bsaid/SensorBoard/firmware/hello_world_orig/README.md

# Hello World Test

Testing space for new software features in SensorBoard.
