bsaid/SensorBoard/firmware/SensorBoard_orig/README.md

# SensorBoard main firmware

* The main firmware source code for ESP32 in SensorBoard.
