bsaid/SensorBoard/thesisCloneUIB/Acronyms.tex

%!TeX root=indexUIB.tex
\chapter{Acronyms}

\begin{acronym}

\acro{AHRS}[AHRS]{Attitude and Heading Reference System}
\acro{API}[API]{Application Programming Interface}
\acro{ARM}[ARM]{Advanced RISC Machine}
\acro{BOM}[BOM]{Bill of Materials}
\acro{CGI}[CGI]{Computer Generated Imagery}
\acro{CPU}[CPU]{Central Processing Unit}
\acro{CSV}[CSV]{Comma-Separated Values}
\acro{DSP}[DSP]{Digital Signal Processing}
\acro{EAGLE}[EAGLE]{Easy Applicable Graphical Layout Editor}
\acro{ESP-IDF}[ESP-IDF]{Espressif IoT Development Framework}
\acro{GPIO}[GPIO]{General-Purpose Input/Output}
\acro{HAL}[HAL]{Hardware Abstraction Layer}
\acro{IMU}[IMU]{Inertial Measurement Unit}
\acro{IoT}[IoT]{Internet of Things}
\acro{JTAG}[JTAG]{Joint Test Action Group}
\acro{LED}[LED]{Light-Emitting Diode}
\acro{Li-poly}[Li-poly]{Lithium polymer battery}
\acro{MEMS}[MEMS]{Micro Electro Mechanical Systems}
\acro{Mo-Cap}[Mo-Cap]{Motion Capture}
\acro{PCB}[PCB]{Printed Circuit Board}
\acro{POSIX}[POSIX]{Portable Operating System Interface}
\acro{RLC}[RLC]{Resistor (R), Inductor (L), Capacitor (C)}
\acro{SMD}[SMD]{Surface Mounted Device}
\acro{SMT}[SMT]{Surface Mount Technology}
\acro{SPI}[SPI]{Serial Peripheral Interface bus}
\acro{SWD}[SWD]{Serial Wire Debug}
\acro{TCP}[TCP]{Transmission Control Protocol}
\acro{TDOA}[TDOA]{Time Difference of Arrival}
\acro{UART}[UART]{Universal Asynchronous Receiver-Transmitter}
\acro{USB}[USB]{Universal Serial Bus}

\end{acronym}
