bsaid/SensorBoard/thesisCloneUIB/indexUIB.tex

\documentclass[english, GINF]{TFGEPSUIB}

\usepackage[printonlyused]{acronym}
\usepackage{siunitx}
\usepackage[draft=false, backref, hyperindex, plainpages=false, breaklinks=true, bookmarksnumbered=true]{hyperref}

\usepackage{paralist} %% Compact list environments
\usepackage{amsmath}  %% Mathematics
\usepackage{amsthm}
\usepackage{amsfonts}
\usepackage{url}      %% Hyperlinks
\usepackage{listings} %% Source code highlighting
\usepackage{graphicx}
\usepackage{listings}
\usepackage{xcolor}
\usepackage{hhline}
\usepackage{siunitx}
\usepackage[most]{tcolorbox}
\usepackage{geometry}
\usepackage{adjustbox}
\usepackage{tcolorbox}
\usepackage{multirow, tabularx}
\usepackage{booktabs}
\usepackage{multirow}
\usepackage{longtable}
\usepackage{gensymb}
\usepackage{multicol}
\usepackage{float}

\estudis{\MakeUppercase{Master degree}}

% Thesis info
\title{Device for Movement Analysis Using Inertial Sensors}
\author{\MakeUppercase{Bedřich Said}}
\tutor{Dr. Antoni Jaume i Capó}
\supervisor{RNDr. Zdeněk Matěj, Ph.D.}
\date{May 22, 2018}

\bibliographystyle{url}

\theoremstyle{definition}
\newtheorem{definition}{Definition}[section]

\theoremstyle{remark}
\newtheorem*{remark}{Remark}

%% Special colors definitions
\definecolor{background}{HTML}{F5DD9D}
\definecolor{symbolColorTop}{HTML}{FFECB3}
\definecolor{symbolColorBox}{HTML}{FFF9E5}
\definecolor{gray}{rgb}{0.25,0.25,0.25}
\definecolor{darkblue}{rgb}{0.0,0.0,0.6}
\definecolor{cyan}{rgb}{0.0,0.6,0.6}
\definecolor{lightblue}{rgb}{0.9,0.95,1.0}
\definecolor{darkgreen}{rgb}{0.0,0.6,0.0}
\definecolor{brown}{HTML}{A52A2A}
\definecolor{darkmagenta}{HTML}{8B008B}

\lstset{
	basicstyle      = \ttfamily,%
	identifierstyle = \color{black},%
	keywordstyle    = \color{blue},%
	keywordstyle    = {[2]\color{cyan}},%
	keywordstyle    = {[3]\color{olive}},%
	stringstyle     = \color{teal},%
	commentstyle    = \itshape\color{magenta}}

\newcommand\Cpp{
	\lstset{
		basicstyle=\ttfamily,
		columns=fullflexible,
		showstringspaces=false,
		tabsize=4,
		numbers=left,
		xleftmargin=2em,
		backgroundcolor = \color{lightblue},
		language=C++,
		identifierstyle=\color{brown},
		keywordstyle=\color{blue},
		stringstyle=\color{red},
		commentstyle=\color{darkgreen},
		morecomment=[l][\color{darkmagenta}]{\#}
	}
}

%% Table colors
\newcommand\greenLow[0]{\cellcolor{green!25} Low}
\newcommand\greenSpare[0]{\cellcolor{green!25} Spare}
\newcommand\yellowMedium[0]{\cellcolor{yellow!25} Medium}
\newcommand\redHigh[0]{\cellcolor{red!25} High}

\newcommand\greenYes[0]{\cellcolor{green!25} Yes}
\newcommand\redNo[0]{\cellcolor{red!25} No}

\newcommand\greenCell[1]{\cellcolor{green!25} #1}
\newcommand\yellowCell[1]{\cellcolor{yellow!25} #1}
\newcommand\redCell[1]{\cellcolor{red!25} #1}

%% Definition of the box with declarations of used symbols.
\newcommand\highlightedBox[2]{
	\tcbset{
		enhanced,
		colback=symbolColorBox,
		boxrule=1.0pt,
		colframe=symbolColorTop!80!black,
		coltitle=black,
		fonttitle=\bfseries
	}
	\vspace{0.5cm}
	\begin{tcolorbox}[title=#1:,lifted shadow={0mm}{0mm}{0mm}{0.1mm}{black!50!white}]
		#2
	\end{tcolorbox}
	\vspace{0.5cm}
}

\newcommand\itwoc[0]{
	I$^{2}$C
}

\newcommand\ind[1]{#1\index{#1}}

\begin{document}
\tcbset{tab2/.style={enhanced,fonttitle=\bfseries,fontupper=\normalsize\sffamily, colback=yellow!10!white, colframe=black, colbacktitle=white, coltitle=black, center title}}

%\portada
\frontmatter

\cleartorecto \tableofcontents

\include{Acronyms}
\include{Abstract}

\newgeometry{twoside, top=2.5cm, left=3cm, textwidth=15cm, textheight=24cm}
\mainmatter\pagestyle{ruled}

\include{Introduction}
\include{Hardware}
\include{Software}
\include{Analysis}
\include{Conclusion}

\backmatter

\bibliographystyle{IEEEtran}

% Using file Bibliography.bib
\bibliography{bibliografia}

\appendix
\include{Appendix}

\end{document}
