bsaid/SensorBoard/thesis/Acronyms.tex

\newacronym{AHRS}{AHRS}{Attitude and Heading Reference System}
\newacronym{API}{API}{Application Programming Interface}
\newacronym{ARM}{ARM}{Advanced RISC Machine}
\newacronym{BOM}{BOM}{Bill of Materials}
\newacronym{CGI}{CGI}{Computer Generated Imagery}
\newacronym{CPU}{CPU}{Central Processing Unit}
\newacronym{CSV}{CSV}{Comma-Separated Values}
\newacronym{DSP}{DSP}{Digital Signal Processing}
\newacronym{EAGLE}{EAGLE}{Easy Applicable Graphical Layout Editor}
\newacronym{ESP-IDF}{ESP-IDF}{Espressif IoT Development Framework}
\newacronym{GPIO}{GPIO}{General-Purpose Input/Output}
\newacronym{HAL}{HAL}{Hardware Abstraction Layer}
\newacronym{IMU}{IMU}{Inertial Measurement Unit}
\newacronym{IoT}{IoT}{Internet of Things}
\newacronym{JTAG}{JTAG}{Joint Test Action Group}
\newacronym{LED}{LED}{Light-Emitting Diode}
\newacronym{Li-poly}{Li-poly}{Lithium polymer battery}
\newacronym{MEMS}{MEMS}{Micro Electro Mechanical Systems}
\newacronym{Mo-Cap}{Mo-Cap}{Motion Capture}
\newacronym{PCB}{PCB}{Printed Circuit Board}
\newacronym{POSIX}{POSIX}{Portable Operating System Interface}
\newacronym{RLC}{RLC}{Resistor (R), Inductor (L), Capacitor (C)}
\newacronym{SMD}{SMD}{Surface Mounted Device}
\newacronym{SMT}{SMT}{Surface Mount Technology}
\newacronym{SPI}{SPI}{Serial Peripheral Interface bus}
\newacronym{SWD}{SWD}{Serial Wire Debug}
\newacronym{TCP}{TCP}{Transmission Control Protocol}
\newacronym{TDOA}{TDOA}{Time Difference of Arrival}
\newacronym{UART}{UART}{Universal Asynchronous Receiver-Transmitter}
\newacronym{USB}{USB}{Universal Serial Bus}
