bsaid/SensorBoard/thesisCloneUIB/indexUIB.pdf

# Final Degree Report

## MASTER DEGREE

# Device for Movement Analysis Using Inertial Sensors

## BEDRICH SAID ˇ

## Tutor

RNDr. Zdenˇek Matˇej, Ph.D.

## Supervisor Dr. Antoni Jaume i Capó

## Escola Politècnica Superior Universitat de les Illes Balears Palma, May 01, 2018

## CONTENTS

Contents | i
Acronyms | iii
Abstract | v
1 Introduction | 1
2 Hardware | 3
3 Software | 25

i

ii | CONTENTS
3.3.2 | Sensor fusion and Attitude and Heading Reference System (AHRS) . . | 36
3.3.3 | UAV Flight controller with non-critical user programmable processor . | 38
3.4.5 | Controlling via Transmission Control Protocol (TCP) connection . . . | 48
4 Conclusion | 51
Bibliography | 53

## ACRONYMS

AHRS Attitude and Heading Reference System

API Application Programming Interface

BOM Bill of Materials

EAGLE Easy Applicable Graphical Layout Editor

ESP-IDF Espressif IoT Development Framework

IMU Inertial Measurement Unit

IoT Internet of Things

JTAG Joint Test Action Group (standard)

MEMS Micro Electro Mechanical Systems

PCB Printed Circuit Board

POSIX Portable Operating System Interface

SMD Surface Mounted Device

SMT Surface Mount Technology

SWD Serial Wire Debug (interface)

TCP Transmission Control Protocol

TDOA Time Difference of Arrival

iii

## ABSTRACT

Attitude sensors are more widely used and their price is decreasing. The lower price allows creating new solutions with lower costs. Some examples can be found in wearable devices, mobile phones, navigation or control systems. There are several devices for various use cases on the market.
These devices usually cover their use cases and don’t have any additional features like power independence, enough logging memory or openness for user code. The remaining hardware that fulfills all the conditions above is usually very expensive.
I have developed a new wearable independent device for capturing and processing the measured data. The independence means no external wires and no external power supply here. The device is able to work outdoors, to log the measured data and to provide a direct output based on internal computations. The user can choose between completely wireless communication or wired connection to other electronics. The sensors measure inertial, attitude, position and atmospheric values.
For outdoor testing of the device, I have selected a task about movement analysis of a horse. The devices were placed on the horse’s body as wearable devices and I was developing algorithms for determination of the type of its movement – stand, walk, trot or gallop.
In general, the developed device can be used for sensor data capturing, onboard data processing, navigation or control of moving mechanics. The device works independently, so it is easy to install on the measured or controlled objects.

v

## C H A P T E R

1

## INTRODUCTION

Attitude sensors are more widely used and their price is decreasing. The decreasing price allows creating new solutions with lower costs. Some examples can be found in wearable devices, mobile phones, navigation or control systems. There are several devices for various use cases on the market.
These devices usually cover their use cases and don’t have any additional versatility. For example, some wearable devices require permanent connection and don’t have enough memory to log the captured data for several minutes. Another hardware requires an external power supply and cannot work independently. Some next boards are closed and don’t allow to run a user code. The remaining hardware that fulfills all the conditions above is usually very expensive.
The goal of this work is to develop a new independent device with several sensors and a user programmable controller. So, why we don’t use a mobile phone? Well, the device should be able to run a real-time user program and to read the sensors at a precisely specified frequency. The size and weight of the device are also very important. With the decreasing price of Micro Electro Mechanical Systems (MEMS) sensors and controllers, we are able to build cheaper and lighter device than a smartphone.
I have utilized a new microcontroller in this work. This microcontroller was released on September 2016 and it’s designed for various real-time embedded tasks and it’s manufactured with on-chip WiFi and Bluetooth. I think that at least one wearable device should be designed with this microcontroller.
This paper goes through the development process of the new wearable hardware including manufacturing, testing, API implementation, firmware implementation and the first use of the prototype outside the laboratory. Each part is discussed in the separated chapter.
The main motivation was to create an independent wearable device with various sensors and enough memory for storing the measured data. The capacity of the battery and power

1

1. INTRODUCTION

consumption is also very important. During the design process, I have added some additional requirements that don’t increase the cost very much, but they give us higher versatility and possibility to use the new hardware in more solutions.
When I finished the development process of the hardware I had to prove the announced functionality of the device. I have selected a task about movement analysis of a horse using inertial sensors. When the device is mounted on a horse’s body, the real-time analysis is able to detect the type of movement of this horse. With this task, I can compare the functionality of my device to the other hardware available on the market. The movement analysis task is based on outdoor measurements, so I can see the usability of my hardware and software outside laboratory conditions. These successful tests are also part of this thesis.
When I was looking for a good algorithm for determination of the movement based on data from inertial sensors, I tried to write my own algorithm with low requirements on the CPU power. The algorithm runs real-time with latency around one step of the horse. Lower latency cannot be achieved because one step is the basic element of each movement. During the outdoor tests, we could see the horse with the SensorBoard mounted on its back and the real-time results of the analysis on the screen of a connected tablet.
The algorithm first determines very basic types of movements and then it’s looking for more advanced ones based on previous results. The types of movement are defined as state-ments, so new types of movement of any subject can be detected without modification of the computation code. These tests achieved the last milestone of this thesis.

2

## C H A P T E R

2

## HARDWARE

The hardware design is split into several steps in this paper. First, I had to decide if it’s really necessary to build a new device or if I can find a suitable solution on the market. When we want to select a suitable device for our task, we have to know the specification of the task itself. The task is specified in section 2.1. Based on the task we can specify all requirements that the selected device should meet (section 2.2). Now, we can start looking for a device that fulfills all the requirements (section 2.3).

When we don’t find any suitable device on the market, we can start to think about creating a new one. In my opinion, it’s not a good way to start any development before doing the previous steps.

When we already start a development of a new hardware we can think about adding some additional requirements for increasing the versatility of the final hardware. Of course, the new requirements mustn’t rapidly increase the final prize. But if the hardware will be used only in the specific task, it’s usually unnecessary to add any other functionality. In this case, I’m adding some additional requirements in section 2.2.3, because I think that in this case, I can add very high versatility with very low additional cost. The analysis of the final expenses is in section 2.7.4.

When I’m decided to develop a new hardware and I have the specification of all the requirements, I can start the development process. The selection of chips and other parts is in section 2.4 and the printed circuit board (Printed Circuit Board (PCB)) design is discussed in section 2.5.

Finally, the manufacturing of the first prototype is described in section 2.6. With the first prototype, it’s time for testing. The tests should find as many errors as possible and they should proof us if the requirements were already met. The section 2.7. The whole process is shown in the figure 2.

3

2. HARDWARE

Figure 2.1: Flowchart of the hardware design process

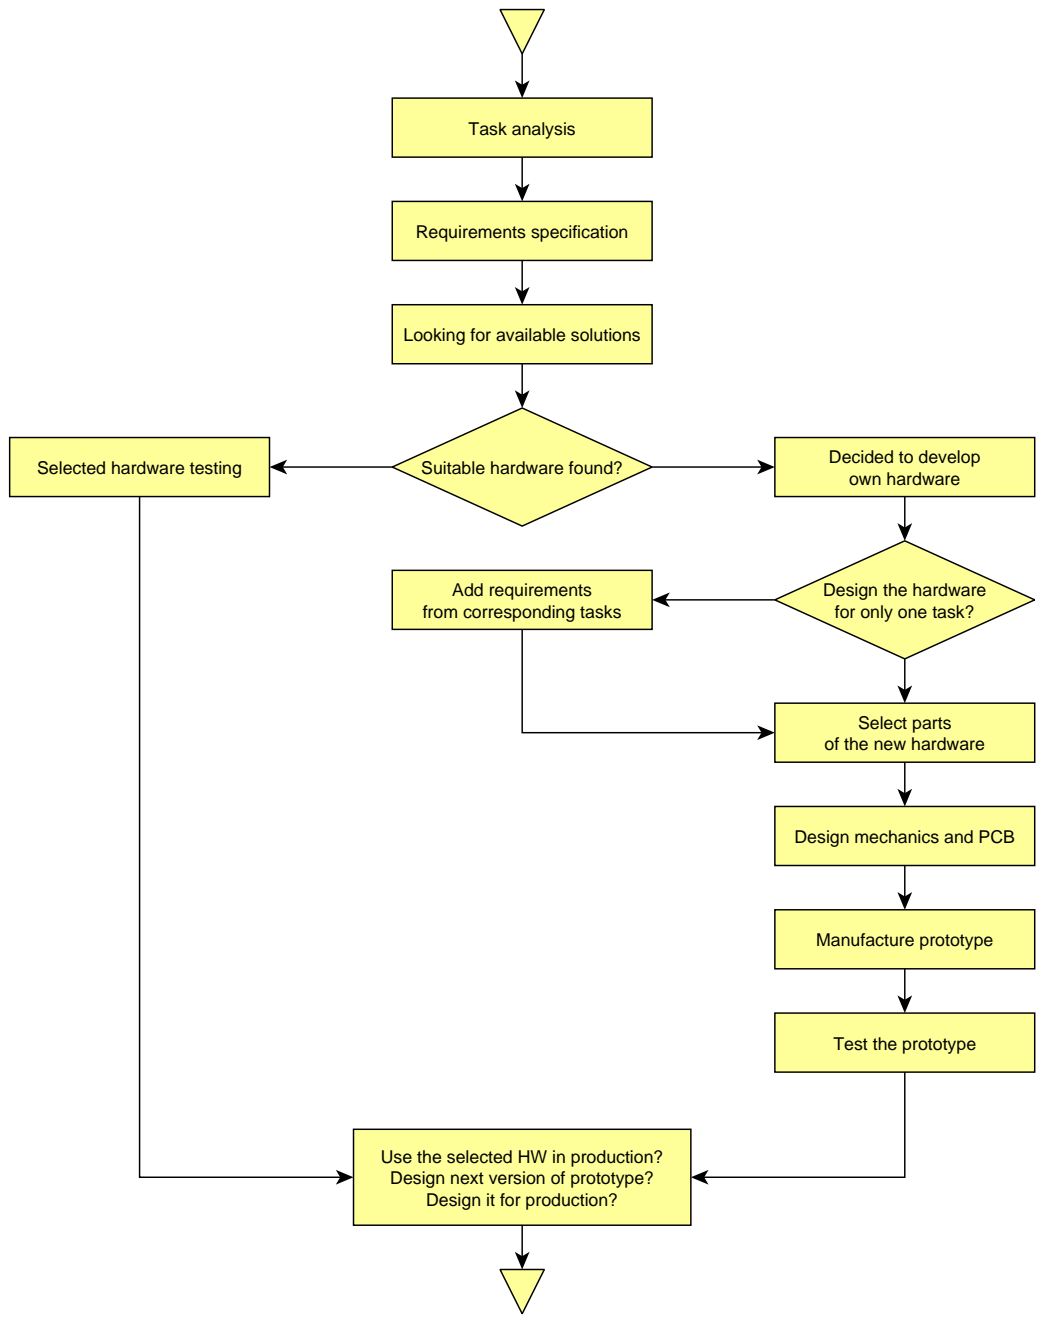
[picture p14: figure]
Task analysis; Requirements specification; Looking for available solutions; Selected hardware testing; Suitable hardware found?; Decided to develop; own hardware; Design the hardware for only one task?; Add requirements from corresponding tasks; Select parts of the new hardware; Design mechanics and PCB; Manufacture prototype; Test the prototype; Use the selected HW in production? Design next version of prototype? Design it for production?

4

2.1. Task Analysis

## 2.1 Task Analysis

When we define our complete task in the first step, then we can derive all requirements for our solution. Finally, we can check if our project was successful based on the previously defined task and requirements.

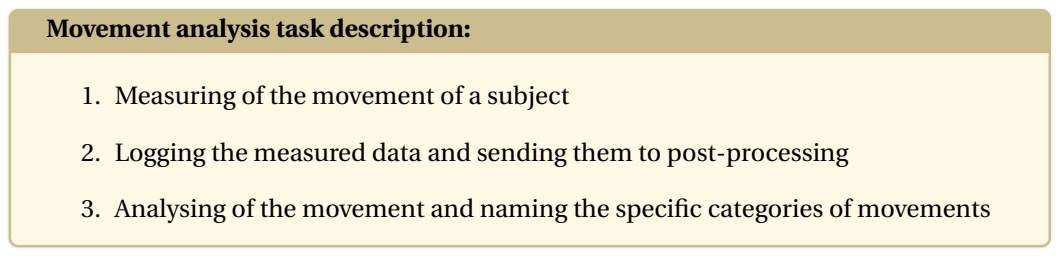
[picture p15: figure]
Movement analysis task description:

1. Measuring of the movement of a subject
2. Logging the measured data and sending them to post-processing
3. Analysing of the movement and naming the specific categories of movements

The subject is an animal – horse in this paper – or human being or a moving machine. The post-processing can be done real-time during the measurement process, but this is not mandatory. The analysis is primarily focused to recognize known movements in logged data. For example, the categories of movement of a horse are stand, walk, trot, gallop etc.

## 2.2 Requirements

The development of a new hardware or software is usually driven by specified requirements. In this paper, I have specified two groups of requirements. The first group is based on the selected task to solve. The second group has lower priority and specifies all the requirements that I found during other similar tasks with similar hardware. The second group of requirements is adding higher versatility to the final electronic device with very low additional cost. These two groups of requirements are later merged and used as a source for next development of the hardware.

### 2.2.1 High level requirements

Measuring of the movement of a subject: The solution should work outdoor. So, we cannot take into account any studio or laboratory-based technologies like Motion Capture (Mo-cap). On the other hand, we can replace the passive or active markers with the whole sensors and remove the necessary cameras. The sensor-based electronics is easier to install and can be used in large and complex areas. Based on this outdoor requirement I will consider only wearable sensor systems.

Logging the measured data and sending them to post-processing: There are no wires ac-ceptable for outdoor use, so we can log the data to internal memory or transmit them via any wireless technology. The wireless systems may be not fully reliable in complex areas with many objects. So, when we want to transmit the data directly it’s still better to log them internally for later downloads.

5

2. HARDWARE

Analysis of the movement and naming the specific categories of movements This is a software requirement, so it’s not very important during the hardware design. But this requirement defines what data we need to measure and this is a hardware requirement.
For the movement reconstruction, we primarily need data about position and attitude of every sensor. Some methods for movement classification don’t need to know the exact location (for example accelerometer-based step counter). This task is focused on developing a new analysis of the movement, so now I cannot exactly say what sensors will be needed in the future. I can make a prediction that the inertial measurement unit (Inertial Measurement Unit (IMU)) and some location sensors will be needed. But there are some other sensors that produce interesting data according to the movement analysis, for example, a heart rate sensor according to animals.
Finally, I would like to add as many interesting sensors as possible, because it will give us more data sources and we are less limited by the data sources. The other advantage is multifunctionality of the hardware. On the other hand, these additional sensors should be added only into additional requirements with lower importance. Otherwise, the selection of an appropriate hardware (based on the requirements) will be manipulated by a number of probably unnecessary sensors.

### 2.2.2 Low level requirements

Finally, I’ve chosen a wearable sensors technology. The next requirements are specific to this technology and focused on the selection of the devices. Let’s call a used wearable device or devices as Sensor Board. The tables 2.1 and 2.2 shows the list of requirements for this Sensor Board.

### 2.2.3 Additional requirements

The additional requirements are not directly derived from the task, but they can increase the versatility of the final product. These requirements are shown in table 2.2.3.

## 2.3 Available solutions

The table 2.4 shows the overview of existing devices I have found.

## 2.4 Selection of parts for the new device

Here I have finally decided to develop a new hardware. Now I’m looking for suitable parts for this new electronic device. The table 2.5 lists all the parts I took into account during the hardware development process.

6

2.4. Selection of parts for the new device

Table 2.1: Sensor Board low level requirements 1

Importance legend

Low | Nice to have
Medium | Very useful, reduce time or human effort
High | Mandatory, impossible without this functionality

Low level requirements 1

Category | Requirement | Importance
Power Supply | Accumulator Battery percentage indicator Charging when external power applied Voltage and current sensor Power LED Power switch Automatic selection between external and battery power Standardized charging connector | High High High Medium High High High Medium
Sensors | Accelerometer Dynamic Gyroscope Magnetometer Indoor position Outdoor position Barometer Board temperature | High High High Medium Low Low Low
Communication | Allow user programming Wireless programming Wired programming Wireless Standardized protocol Wired access Connector for external sensors | High Low High High High High Low

7

2. HARDWARE

Table 2.2: Sensor Board low level requirements 2

Low level requirements 2

Category | Requirement | Importance
Functions | Logging all data for several hours Sensor fusion coprocessor LED indicators | High Low High
Mechanical | Wearable design Dimensions under 6 cm Dimensions under 3 cm Weight under 50 g Weight under 20 g | High High Low High Low
Control multiple devices simultaneously | Medium
Download logged data | High
Streaming data during measurement | Medium
Start logging on multiple devices by clicking one button | Medium
Time synchronization of multiple devices | High

Software

Possibility to upload data to a server | High

## 2.5 PCB design

The PCB design should meet both electrical and mechanical requirements. It’s usually easier to design a large board in the first iteration, which is used only in the laboratory for software development and testing. Then the second iteration brings the first practically usable device and probably the third iteration is the first one dedicated to production use.
Here in this process, I will merge the first and the second version together. I will create a larger device which can be still used as a wearable device. This implies that I can do the software development, laboratory tests and the first outdoor tests with the same board designed during the first iteration. I’m going to decrease the dimensions of the first prototype by splitting the PCB to separate sandwich modules. The testing process should give us advantages and disadvantages of this mechanical solution.
I have used CadSoft EAGLE (Easy Applicable Graphical Layout Editor) [33] during this process. I’ve finally chosen this editor because it has the availability of the libraries for the devices I wanted to use. I would probably use KiCad [34] if there was the same availability of the libraries.

### 2.5.1 Schematics and board layout

The schematics and the board layout was created in CadSoft EAGLE [33]. The figures 2.5.1 and 2.5.1 shows the exported schematics split into two sheets. The exported PCB layout drawing in scale 1:1 is in figure 2.5.1 and in scale 2:1 with more details in figure 2.5.1.

8

2.5. PCB design

Table 2.3: Additional requirements for the SensorBoard

Importance legend

Low | Nice to have
Medium | Useful, can significantly improve functionality
High | Not applicable

Low level additional requirements

Category | Requirement | Importance
Functions | Coprocessor for periodic computations like sensor fusion Piezo buzzer Buttons | Low Low Medium
Sensors | Ambient light Humidity Sound (microphone) Ambient temperature | Low Low Low Low
Communication | UART, I2C, SPI connector PWM outputs Analog inputs | Low Low Low
Software | NMEA input | Low

Table 2.4: Available solutions

Available solutions
Device | Link | Price | Main disadvantages
MetaWear | [1] | $ 80 | Low memory, impossible longer logging. Loosing
| | | packets during streaming.
ArduPilotMega | [2] | $ 250 | Dependent on external power supply, higher dimen-
| | | sions.
pixHawk | [3] | $ 260 | Dependent on external power supply, higher dimen-
| | | sions.
X-IMU | [4] | $ 400 | Price.
Smart Phone | N/A | $ 100 | Impossible logging at higher frequencies, inaccurate
| | | logging frequency.
Fitness sensors | N/A | $ 100 | Mostly closed commercial projects.

9

2. HARDWARE

Table 2.5: Selection of parts for the new electronic device

Available solutions
Part ID | Description | Datasheet | Selected
TACTM-35N-F | Button | [5] | Yes
ADP5062 | Power management and battery charger | [6] | Yes
ADP5063 | Power management and battery charger | [7] | No
SI7006 | Humidity and temperature sensor | [8] | Yes
HDC2010YPAR | Humidity and temperature sensor | [9] | No
SHTC1 | Humidity and temperature sensor | [10] | No
DWM1000 | TDOA location sensor (with antenna) | [11] | Yes
DW1000 | TDOA location sensor (only sensor) | [12] | No
BMP280 | Barometer | [13] | Yes
BMP388 | Barometer | [14] | No
FT232R | UART to USB converter | [15] | Yes
CP2102 | UART to USB converter | [16] | No
CH340E | UART to USB converter | [17] | No
MPU-9250 | Accelerometer, dynamic gyroscope, magne- tometer
[18] Yes
BMI160 | Accelerometer, dynamic gyroscope | [19] | Yes
BMF055 | Accelerometer, dynamic gyroscope, magne- tometer, ARM microcontroller
[20] Yes
GY953 | Backup accelerometer, dynamic gyroscope and megnetometer with embedded pitch, roll and yaw angle estimation (sensor fusion)
[21] Yes
HM-TRP | Long range 433 MHz radio | [22] | Yes
MOLEX-47219 | Micro SD card holder | [23] | Yes
LTR-329ALS | Digital ambient light sensor | [24] | Yes
EAALSTIC1708A0 | Analog ambient light sensor | [25] | No
NOA1212 | Analog ambient light sensor | [26] | No
ESP-WROOM-32 | Dual core controller with WiFi and Bluetooth | [27] | Yes
STM32 | ARM microcontroller | [28] | No
UM18533 | Linear stabilizer 3.3 V | [29] | Yes
LF33 | Linear stabilizer 3.3 V | [30] | No
USB-MICRO | Micro USB connector | [31] | Yes
Pin header | Servo connector 2.54 mm | [32] | Yes

10

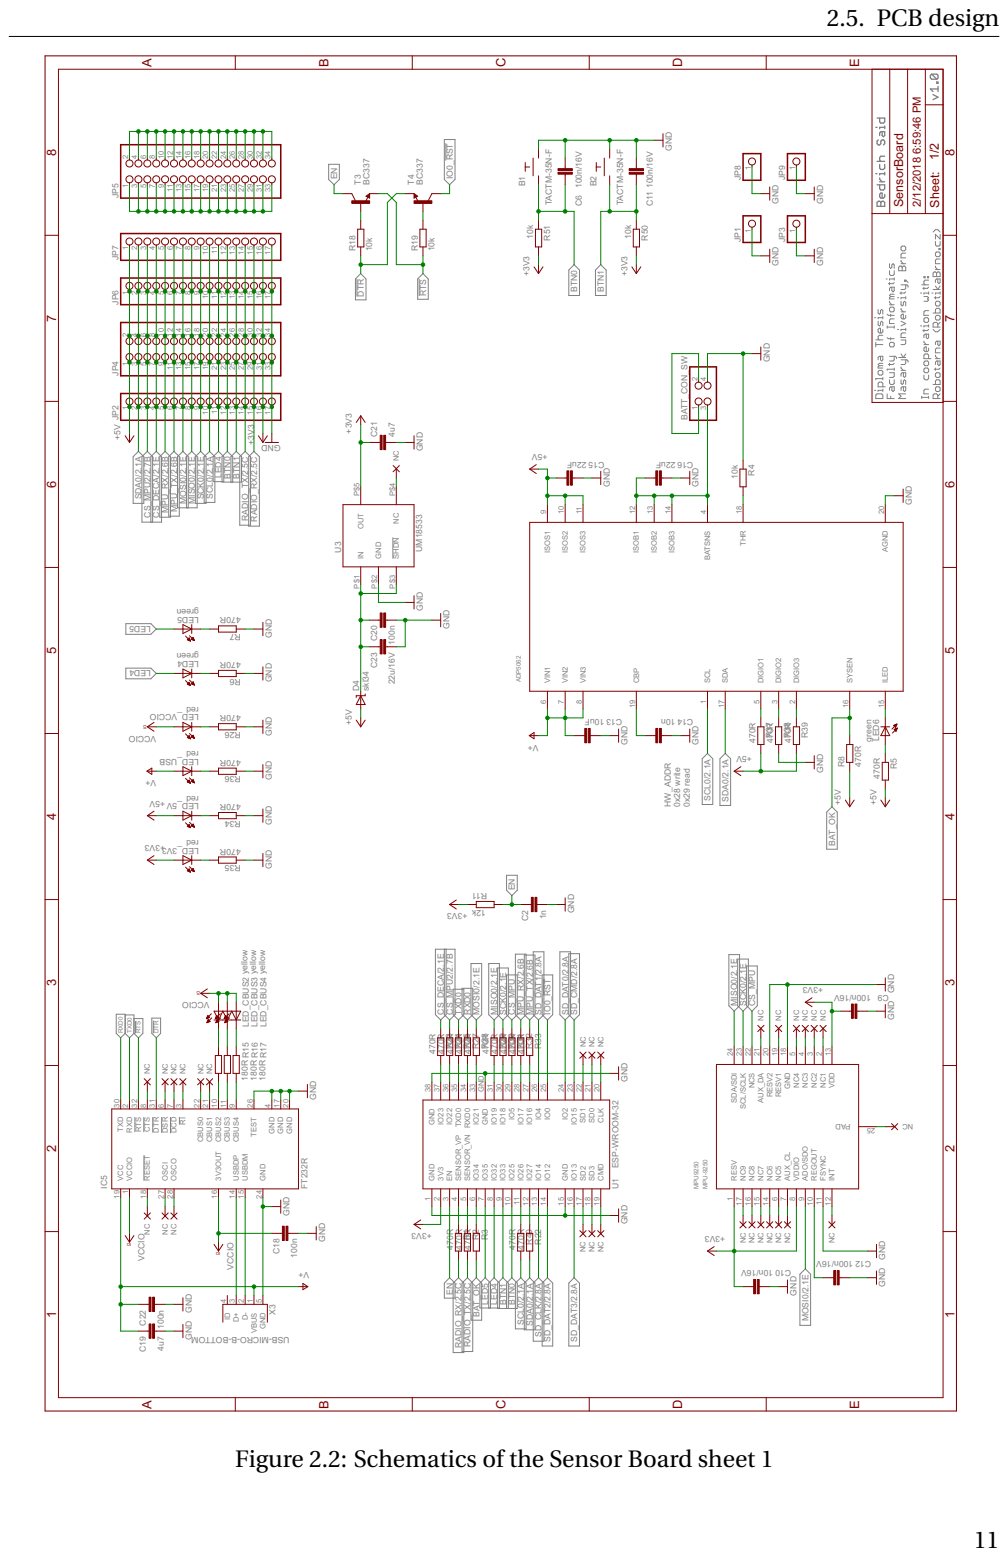
[picture p16: page 19]

GND GND

SDA/SDI 24 SCL/SCLK

Figure 2.2: Schematics of the Sensor Board sheet 1

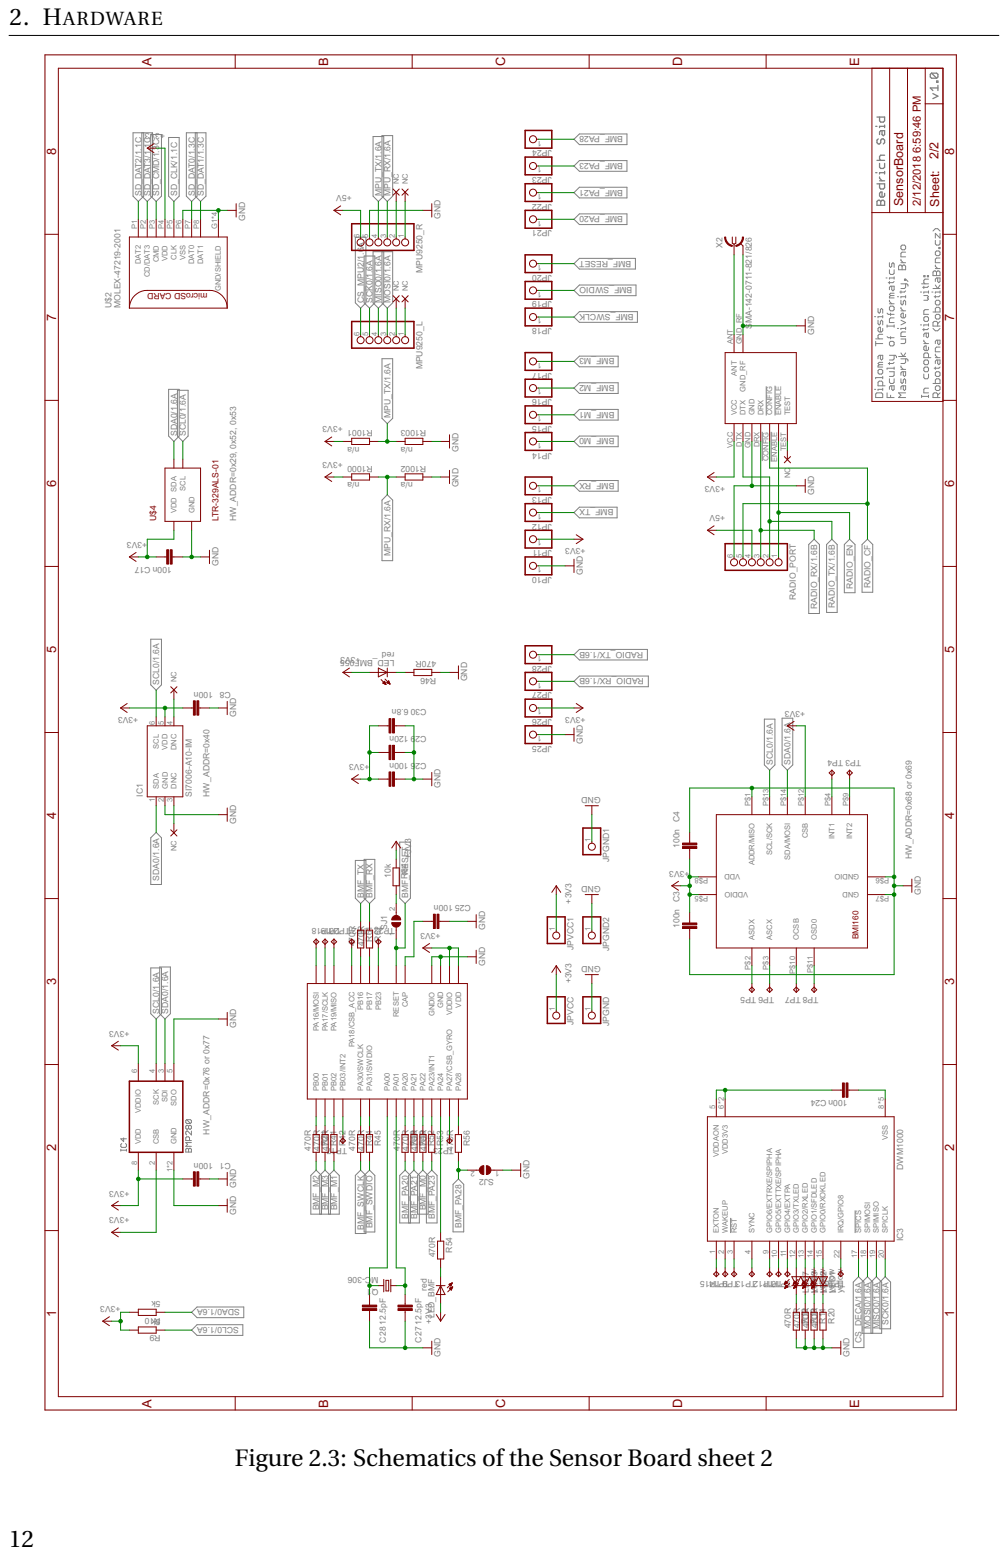
[picture p17: page 20]

P6 DAT0 P7 DAT1 P8 GND/SHIELD G1*4 NC NC

DTX DTX GND GND

Figure 2.3: Schematics of the Sensor Board sheet 2

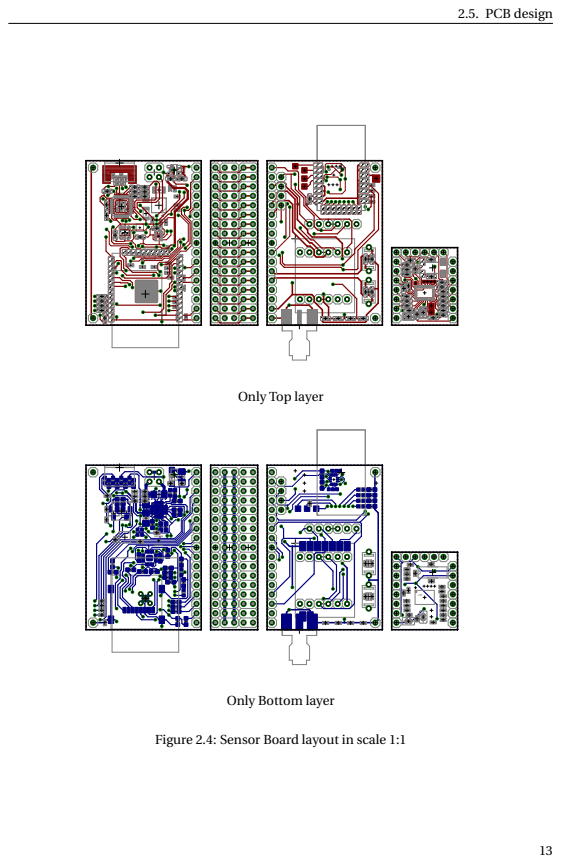
[picture p18: page 21]
2.5. PCB design

Only Top layer

Only Bottom layer

Figure 2.4: Sensor Board layout in scale 1:1

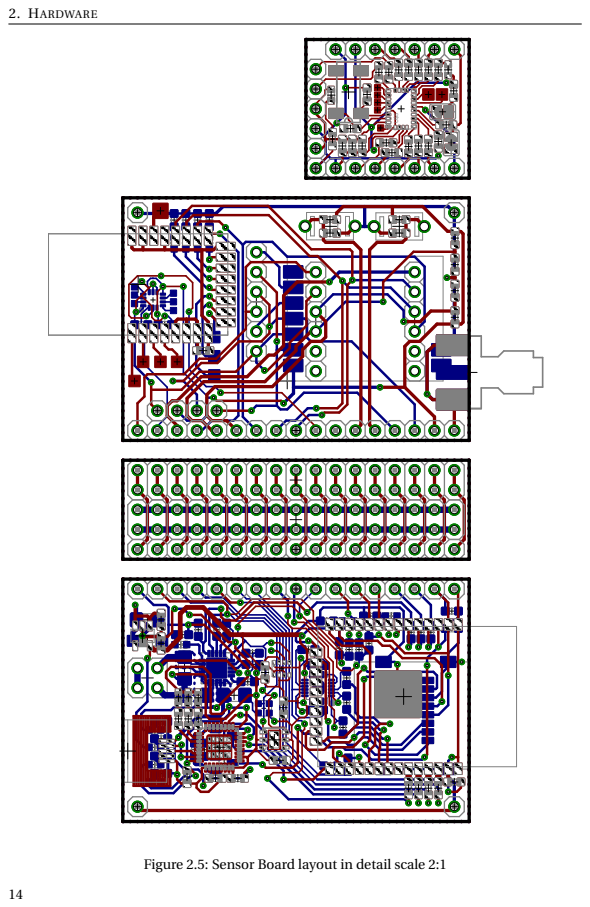
[picture p19: page 22]
2. HARDWARE

Figure 2.5: Sensor Board layout in detail scale 2:1

2.6. Manufacturing

Figure 2.6: Sensor Board dimensions

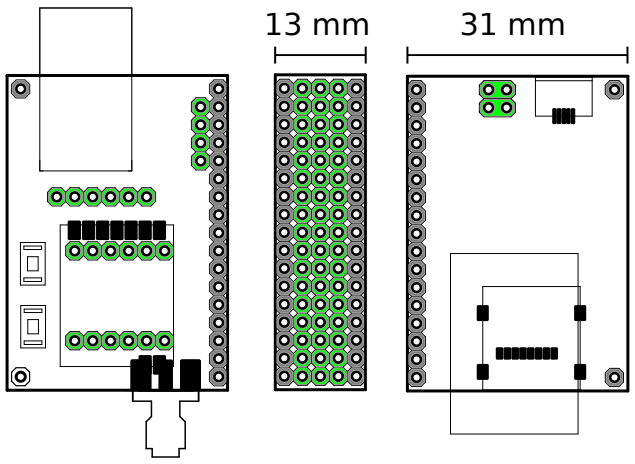
[picture p20: figure]

60 mm

### 2.5.2 Mechanical layout and connectors

The mechanical layout is shown in figure 2.5.2.

## 2.6 Manufacturing

The manufacturing process of the prototype consists of these steps:

1. Collecting source data – schematics and board layout (in this paper in Eagle)
2. Manufacturing of the Printed Circuit Board (PCB)
a) Panelization of the board layout
b) Adding calibration markers
c) Export gerber files
d) Send exported files to manufacturing company
3. Machine surface mount technology (Surface Mount Technology (SMT))
a) Export data for the template for applying solder paste
b) Export partlist – the list of all devices with their coordinates
c) Export bill of materials (Bill of Materials (BOM))
d) Manufacturing of the template for applying solder paste

15

2. HARDWARE
e) Order all devices according to BOM

f ) Sending template for applying solder paste, packages with devices and part list to the manufacturer

4. Finalization of the prototype
a) Hand soldering of some remaining devices like connectors or wires
b) Completing the final prototype from possible parts and packaging
c) Applying power and first testing

### 2.6.1 Collecting source data

The source data may be in various formats according to the used tools. I used CadSoft Easy Applicable Graphical Layout Editor (EAGLE) [33] during the development, but many other tools are available on the market. It depends on the manufacturer company if they accept the source data in our format. They usually accept the source data, but they usually apply an exporting fee. All PCB editors should be able to export the manufacturing data in standardized formats. (Sometimes it’s very hard or impossible to edit the exported data.)

### 2.6.2 Manufacturing of the Printed Circuit Board

When we have more than one board we should assemble all boards onto one or more panels. If we plan to solder the devices using the SMT, we should add a calibration marks on the final panel. I have followed the instructions from SMTplus company [35].
First, I have panelized the separated boards and I have added the calibration marks according to the rules of SMTPlus company [36]. Finally, I have exported the Gerber files using a CAM job [37] in EAGLE. I have followed the design rules for class 3 by Gatema a.s. company [38].

### 2.6.3 Machine surface mount technology

We need the PCB, template for soldering paste and all devices in this step. Some PCB manufac-turers offer to create the template as well, so this is the way I used. The thickness of the template indicates the volume of the paste on each pad. For the small Surface Mounted Device (SMD) parts I used 100 µm, but I recommend to discuss the parameters with the manufacturer. The BOM and part list export depends on the used design tools. When we connect used devices in the sources directly with their part numbers on selected shops, we can simply export the part list and then import it on the seller’s website. I recommend buying some spare devices to minimize the risk of their damage.

### 2.6.4 Finalization of the prototype

We can discuss the finalization works with the manufacturer, but when we create a prototype, I would like to recommend to do this job by yourself. It allows to perform some tests before

16

2.7. Testing

Figure 2.7: Template for soldering paste in scale 1:2

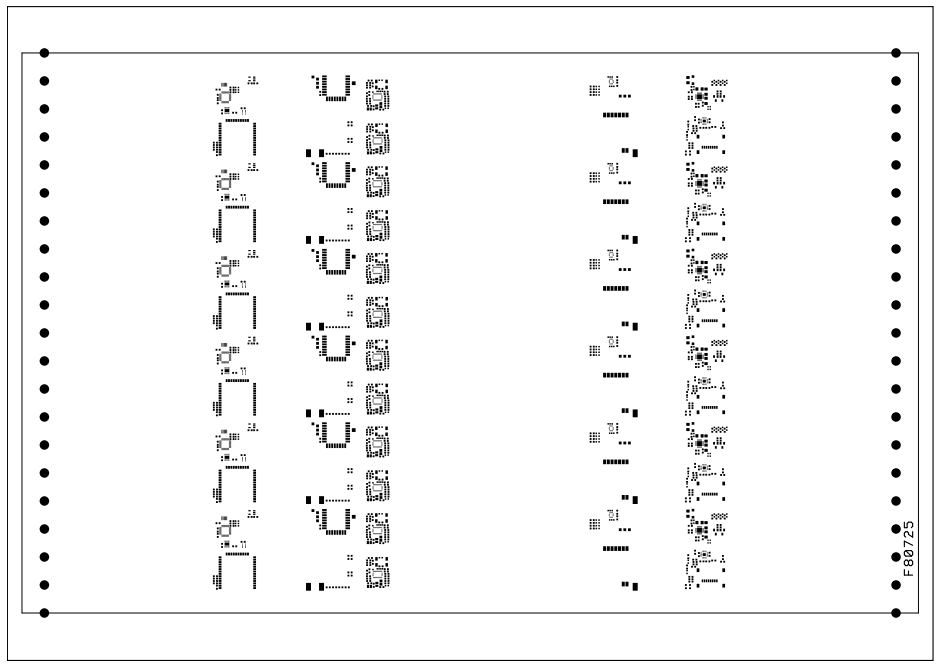
[picture p21: figure]

packaging and we don’t have to spend time and money with a preparation of the documentation about how to assemble and package our prototype. Otherwise, the different software developers and testers can receive the different parts of the prototype for their next work.

## 2.7 Testing

The testing process has been split into two parts: the laboratory testing during the software development and the outdoor testing. I have found some errors in the version 1.0 during the laboratory testing. These errors are described in Errata list in section 2.7.1. I did other tests against the specification of used devices. The results show us what devices should be used in the next version of the hardware and what devices are redundant. The results are shown in the section 2.7.2. The outdoor tests didn’t find any significant errors, but there were found several recommendations for the future versions of the SensorBoard. These recommendations are mentioned in section 2.7.3.

17

2. HARDWARE

### 2.7.1 Errata

The tables 2.6 and 2.7 show all errors I have found during software development and laboratory testing of the Sensor Board prototype.

### 2.7.2 Device testing

The device testing helped me to select the parts recommended for the future versions of the SensorBoard. It also helped me to mark all spare parts in the prototype. The table 2.8 shows the results.

### 2.7.3 Recommendations for the next version

Recommendations for the future versions of the Sensor Board based on the outdoor testing:

– Replace software LEDs by one or more RGB LEDs. For example WS2812 RGB LED [39].

– Move the sensor fusion and computations to Atmel SAM D21 [40] processor inside the BMF055 [20] chip. Keep the ESP32 [27] processor only for communication and user computations.

– Decrease board dimensions using 4 layer PCB. The increased cost for 4 layer board may be saved on a smaller surface.

– Sometimes it is better to have all SMD parts on one side of the board. The manufacturing is cheaper and the space on the second side can be used for example for battery mounting or for connectors.

– Split the board area to an area for sensors, an area for power electronics and an area for computing. The power distribution is easier in this situation and the sensors are less influenced by other electronics.

– Use another driver with more capabilities for USB connection. The USB on board actually supports only UART communication on the virtual COM port. The File Transfer protocol for the SD card should be supported, too. (If it is needed we can add full USB host support or USB-C compatibility.)

– Add specialized pads for an oscilloscope. The pads are connected to the signal and to the ground, so the oscilloscope measurements are more accurate.

– The main processor should be able to switch on/off the power of other parts (sensors). The sensors support sleep modes, but we cannot completely switch them off to save more energy from the battery.

– If we recognize that the ESP-WROOM-32 controller is not powerful enough, we can use a fully compatible alternative with larger memory ALB32-WROVER [41]. It should be possible to compile a terminal based Linux distribution for this controller.

18

2.7. Testing

Table 2.6: Errata of the SensorBoard

Severity legend

Low | No significant affects
Spare | Only spare devices may not work
Medium | Some part of the prototype may not work
High | The prototype has to be remade

Errata 1 of 2
Number | Description | Error | created
| | during

Severity

1 | Bridge between boards under micro USB connector What happens: The micro USB connector may be placed with lower accuracy | panelization | Low
2 | Swapped MISO and MOSI on pins IO19 and IO21 on the ESP-WROOM-32 chip according to ESP32 Arduino standard What happens: The SPI interface is not working in Arduino compatible mode without modification of the Arduino SPI library | schematics design | Medium
3 | LED5 connected to IO35 on ESP-WROOM-32 is not working What happens: The pins IO34 – IO39 are input only, so they cannot drive a LED | schematics design | Spare
4 | Missing pull-up resistors on SD card What happens: The SDIO interface needs external pull-up resistors to work properly. I have added these resistors later by hand. | schematics design | Medium

19

2. HARDWARE

Table 2.7: Errata of the SensorBoard

Errata 2 of 2
Number | Description | Error | created
| | during

Severity

5 | The temperature measurement is placed very close to the main processor What happens: The processor heating affects the measured temperature | board layout | Spare
6 | Low capacity capacitor placed on power supply What happens: When we use WiFi some brownouts can be detected. I have added a bigger capacitor later by hand. | schematics design | Medium
7 | The light sensor is placed on inner side of the board What happens: The measured values are affected by shadow of the board. | board layout | Spare
8 | Missing safety resistors on pins with buttons. These pins are directly connected to processor. What happens: When the pins are defined in software to be used in different way, incorrect connection can burn the processor. | schematics design | Medium

20

2.7. Testing

Table 2.8: Parts of the SensorBoard recommended for the future versions

Decision legend

Selected | Recommended for use in future versions
Possible | Not necessary, but has use-cases, may be replaced with another part
Removed | Not recommended or will be spare

Parts of the SensorBoard recommended for the future versions
Part ID | Description | Datasheet | Selected
TACTM-35N-F | Button | [5] | Selected
ADP5062 | Power management and battery charger | [6] | Selected
SI7006 | Humidity and temperature sensor | [8] | Selected
DWM1000 | TDOA location sensor (with antenna) | [11] | Selected
BMP280 | Barometer | [13] | Selected
FT232R | UART to USB converter | [15] | Selected
MPU-9250 | Accelerometer, dynamic gyroscope, magne- tometer
[18] Removed
BMI160 | Accelerometer, dynamic gyroscope | [19] | Removed
BMF055 | Accelerometer, dynamic gyroscope, magne- tometer, ARM microcontroller
[20] Selected
GY953 | Backup accelerometer, dynamic gyroscope and megnetometer with embedded pitch, roll and yaw angle estimation (sensor fusion)
[21] Removed
HM-TRP | Long range 433 MHz radio | [22] | Possible
MOLEX-47219-
2001 | Micro SD card holder | [23] | Selected
LTR-329ALS | Digital ambient light sensor | [24] | Selected
ESP-WROOM-
32 | Dual core controller with WiFi and Bluetooth | [27] | Selected

UM18533

Linear stabilizer 3.3 V

Note: Insufficient current

[29] Removed
LF33 | Linear stabilizer 3.3 V | [30] | Selected
USB-MICRO | Micro USB connector | [31] | Selected
Pin header 2.54 mm | Servo connector | [32] | Possible

21

2. HARDWARE

### 2.7.4 Analysis of additional costs

By the analysis of additional costs, I mean the counting the prices of all parts that were finally spare or weren’t used. The table 2.9 counts all parts of the SensorBoard and their prices.
The column "Used" tells us if the item was used for any use case or if it was spare at all times. If any item is still unused it doesn’t mean that it cannot be used in some future use case. The column "Is necessary" points the basic items, the SensorBoard can’t work or can’t be built without them.
It means that the green cost "Total used and necessary" is the lowest cost of the prototype without any additional functionality. The yellow cost "Total used and unnecessary" is the cost of all items that had significant value during development, but weren’t mandatory for the main task. These items also made the development process easier and faster, so I don’t count this cost as additional. The last red cost "Total unused" covers all items that weren’t used. These items were a part of the design because they lowered some risks in functionality. For example, if I wasn’t sure that an accelerometer will work properly, I added another spare accelerometer, which covered this risk. I could get a working prototype in the first iteration using this strategy. I finally count the red cost as a cost of decreased risks and as a cost of higher versatility.
We have to take into account that all the mentioned costs are costs of the prototype. The same items would have significantly lower costs during the production of more devices.

22

2.7. Testing

Table 2.9: Additional cost calculation

Additional cost calculation
Part ID | Price | Used | Is necessary
PCB SMT job | $ 23 $ 65 | Yes Yes | Yes Yes
TACTM-35N-F ADP5062 SI7006 DWM1000 BMP280 FT232R MPU-9250 BMI160 BMF055 GY953 HM-TRP MOLEX-47219-2001 LTR-329ALS ESP-WROOM-32 | $ 0.4 $ 3.8 $ 2 $ 22 $ 4 $ 5 $ 10 $ 4.3 $ 11 $ 11 $ 13 $ 1.2 $ 0.7 $ 12 | Yes Yes No Yes Yes Yes Yes No Yes No Yes Yes No Yes | No Yes No No No Yes No No Yes No No Yes No Yes
Total used and necessary | $ 121 | Yes | Yes
Total used and unnecessary | $ 49.4 | Yes | No
Total unused | $ 18 | No | No

23

## C H A P T E R

3

## SOFTWARE

The Sensor Board hardware has two programmable CPUs and several configurable chips. The main ESP32 CPU (two low-power Xtensa 32-bit LX6 microprocessors) [27] is programmable via USB or Bluetooth or Joint Test Action Group (standard) (JTAG). The JTAG connector is not present on the Sensor Board. The second microcontroller is a part of BMF055 [20] multifunctional chip. It is Atmel SAMD20 [40] with ARM Cortex-M0+ CPU programmable via Serial Wire Debug (interface) (SWD) interface [42].

Microcontrollers:

1. Espressif ESP-WROOM-32 [27]:
- dual core, 240 MHz, 448 kB ROM, 520 kB SRAM, 4 MB SPI flash memory
- Designated for main program handling all communication and interaction with user or other devices.
2. Atmel SAMD20 [40]:
- ARM Cortex-M0+ CPU, 48 MHz, 32 kB SRAM, 256 kB flash memory
- Designated for processing inertial data (for example computing sensor fusion), it can be used for example as an emulator of other sensors or as a simple flight controller.

25

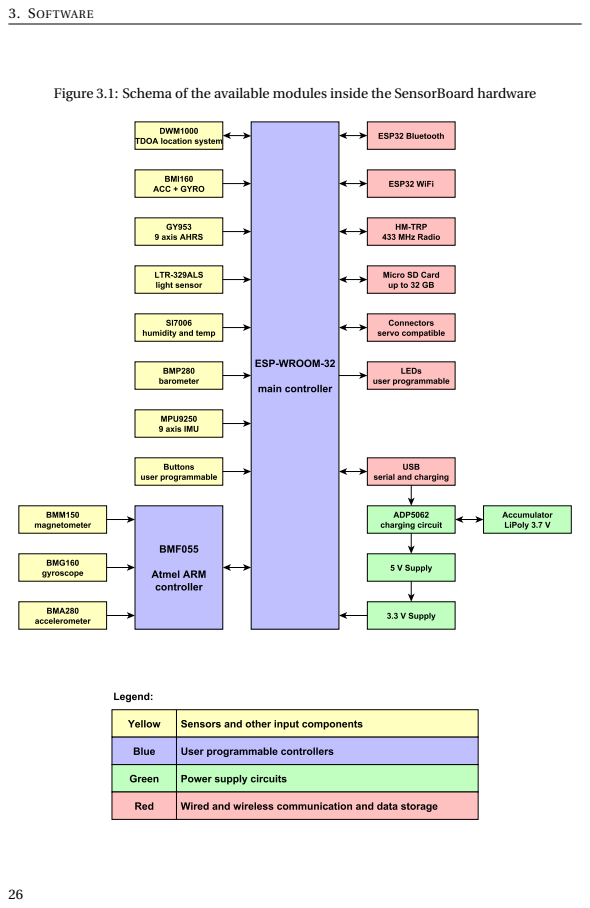
[picture p22: page 34]
3. SOFTWARE

Figure 3.1: Schema of the available modules inside the SensorBoard hardware

3.1. Programming the Board

## 3.1 Programming the Board

Each processor on the SensorBoard has to be programmed separately via its interface. Only ESP32 [27] (main processor) can be programmed over the air via Bluetooth. This feature is disabled by default.

### 3.1.1 Programming ESP32

There are several ways how to program and use the ESP32 [27] controller. The official framework is Espressif IoT Development Framework (ESP-IDF) [43] and supports all the chip functionality. The ESP-IDF framework is Portable Operating System Interface (POSIX) compatible. The chip can be programmed using Arduino compatible framework [44] which creates an easy way for prototyping and learning, but does not offer all the functionality of the chip. The Arduino framework uses the ESP-IDF framework, so we can create "hybrid" programs that use both frameworks.
The last mentioned programming method is scripting in Python. We can upload the MicroPython [45] firmware directly to the ESP32 controller. The Python libraries, scripts and other files are stored on the SD card. The MicroPython firmware supports most of the hardware functionality, but there are still some restrictions.
There are some other ways how to create a program for this hardware, but many of them use one of the mentioned frameworks. For example, we can create a program in Simulink and then export the code to the ESP32 controller. [46]

ESP-IDF Framework

The ESP-IDF framework is almost POSIX compatible. [47] It supports many POSIX compatible functions, but it still doesn’t support all of them. It means that we can compile many POSIX compatible programs for ESP32, but not all of them.
We can follow the official ESP32 programming guide [48] to set up the environment and program the board. The user can do everything from the terminal (command line). The figure 3.1.1 shows a configuration tool used for setup the program before the first compilation and upload to the ESP32 microcontroller.
If we prefer some GUI for development of our software we have several options. I will mention two of them:
1. Eclipse IDE can be setup using the guide in ESP-IDF Programming Guide [49]. In my opinion, the compilation of our programs is very slow when we use this option. The figure 3.1.1 shows the SensorBoard project opened in Eclipse IDE.
2. PlatformIO IDE is an open source ecosystem for IoT development. [50] There is integrated ESP-IDF and Arduino framework for ESP32 microcontrollers. This option was more familiar to me with much faster compilation process. I have used the PlatformIO ecosystem inside Atom [51] advanced text editor. The figure 3.1.1 shows the SensorBoard project opened in Atom editor with PlatformIO plugin.

27

3. SOFTWARE

Figure 3.2: Configuration of the ESP-IDF program in terminal before the first compilation

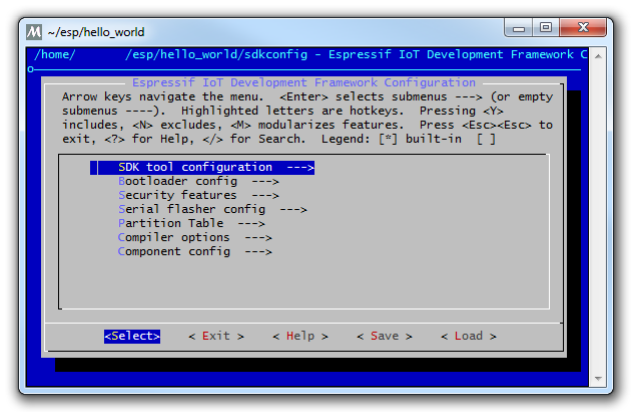
[picture p23: figure]

Arduino Compatibility

The Arduino compatible framework for ESP32 [44] is dependent on ESP-IDF framework [43]. It means that we can use both – the ESP-IDF functions and the Arduino functions – in our programs. The Arduino framework is primarily targeted for beginners and for fast prototyping. I don’t recommend to use this framework for advanced applications, because it doesn’t cover the whole ESP32 functionality. We can develop our Arduino compatible programs in Arduino IDE, but we can use the PlatformIO ecosystem, too. It means that we can use the same environment like in the figure 3.1.1. All libraries are downloaded and installed automatically inside the PlatformIO. We have to set only a platformio.ini file in the root directory of our project. We can add a line framework = arduino for Arduino compatible programs and a line framework = espidf for programs using the ESP-IDF framework.

MicroPython Compatibility

The built MicroPython binary for ESP32 can be directly downloaded from MicroPython website.
[45] We can directly flash this binary to our ESP32 controller (to the SensorBoard) and then directly run our Python scripts. Of course, it is possible to download the MicroPython source code from the same website. The MicroPython allows to control the SensorBoard via Python serial terminal, so we can send a separate command via this serial terminal or run the whole Python scripts stored as files in the SD card. The SD card slot is a part of the SensorBoard.

28

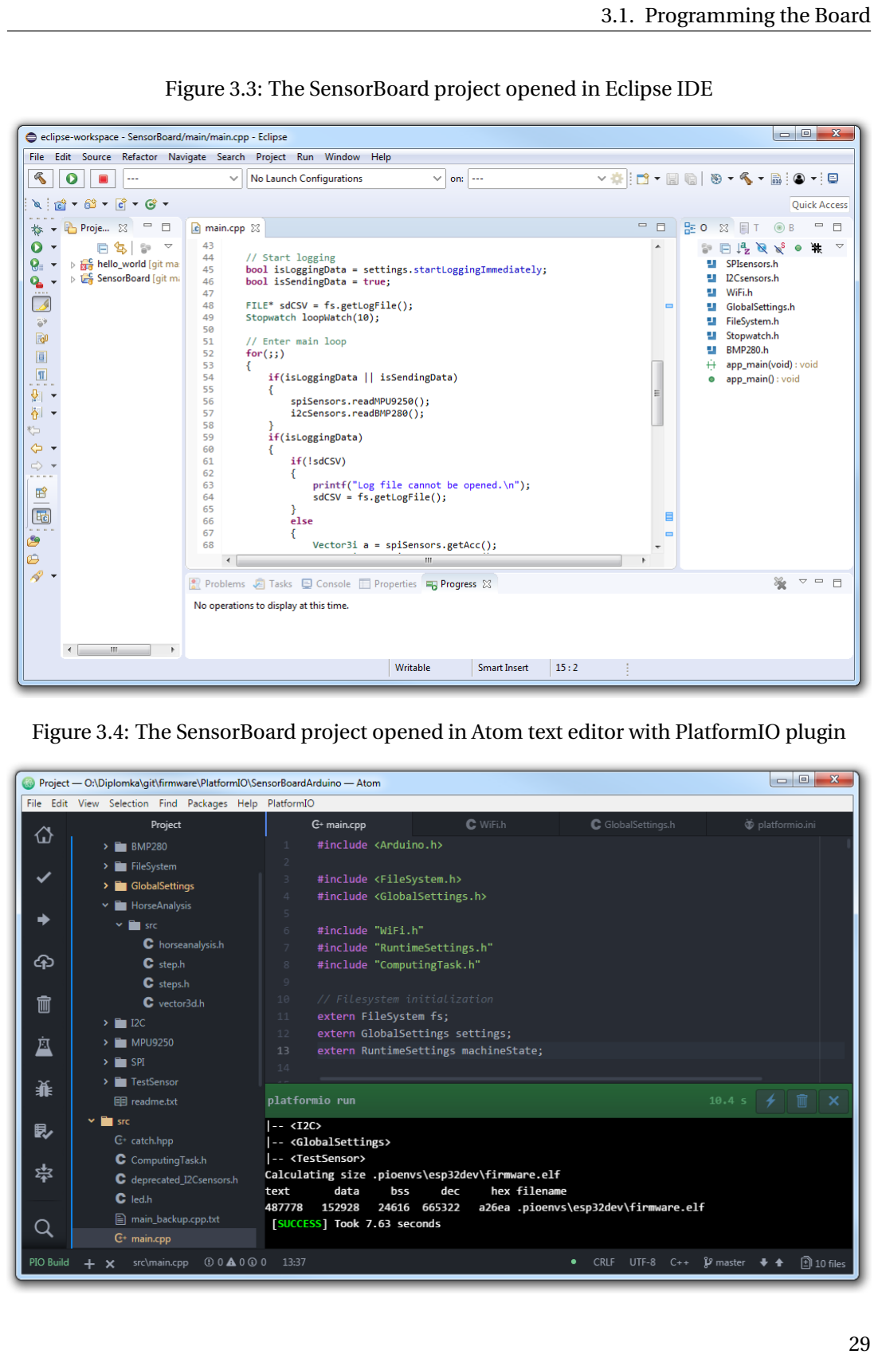
[picture p24: page 37]

3.1. Programming the Board

Figure 3.3: The SensorBoard project opened in Eclipse IDE

Figure 3.4: The SensorBoard project opened in Atom text editor with PlatformIO plugin

29

3. SOFTWARE

One of the Python scripts on the SD card can be configured to be executed automatically after powering on the SensorBoard. The running Python serial terminal on the SensorBoard is shown in figure 3.1.1.

Figure 3.5: The running Python serial terminal on the SensorBoard


30

3.1. Programming the Board

### 3.1.2 Programming BMF055

The BMF055 [20] is a custom programmable 9-axis motion sensor. It is a single chip triaxial accelerometer, dynamic gyroscope, magnetometer and ARM controller. The BMF055 chip is mounted on a separate board which can be optionally mounted to the SensorBoard or it can be used independently. The figure 3.1.2 shows the separate BMF055 board and the same board mounted to the SensorBoard.

Figure 3.6: The separate BMF055 board on the left and the same board mounted to the Sensor board on the right

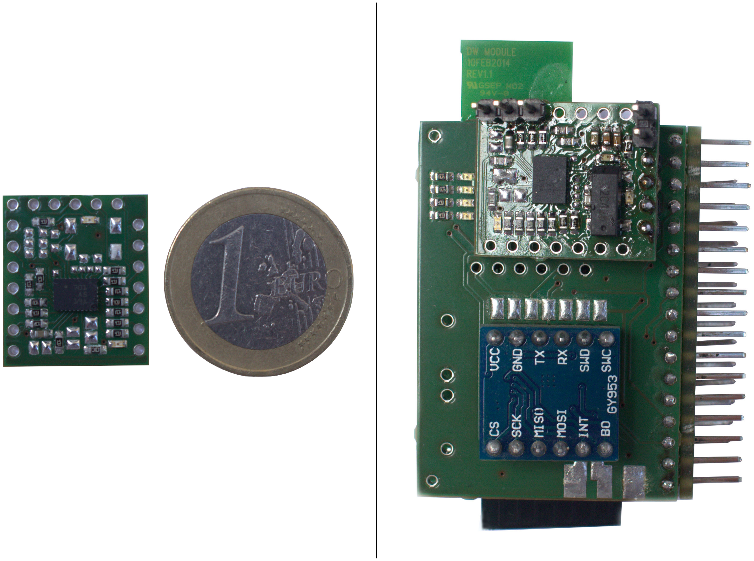
[picture p25: figure]

The BMF055 board has several usages because it contains a user programmable controller. It can be used for example as a simple UAV controller or autopilot. The project BMF055-flight-controller [52] implemented this single chip autopilot solution for multicopters.

The Atmel SAM D20 controler [40] can be programmed in Atmel Studio [53] and the program can be flashed to the chip via SWD interface [42]. We have to use Atmel ICE programmer
[54] or similar hardware. For details about configuration and programming of the BMF055 chip we can follow the BMF055 datasheet [20] or the Atmel SAM D20 datasheet [40]. The figure 3.1.2 shows an opened BMF055 project in Atmel Studio 7.

31

3. SOFTWARE

Figure 3.7: An opened BMF055 project in Atmel Studio 7


## 3.2 Application Programming Interface

The programming interface for the SensorBoard can be split into several categories. There is a native support from the manufacturer of the microcontrollers. This API is written for any electronic device with the targeted microcontroller and this API is mentioned in section 3.2.2. I have implemented a new library for easier working with the sensors on the SensorBoard. This library is described in section 3.2.1.

### 3.2.1 SensorBoard API

The ESP32 and Atmel SAM controller have defined their API by the manufacturer, but these APIs don’t implement a communication with specific sensors and peripherals connected to the controllers. For easier work with all the functionality of the SensorBoard, I have implemented specific API for the ESP32 controller.
The API is built on ESP-IDF and it should be used together with the ESP-IDF API from the manufacturer. It allows, for example, a FreeRTOS usage, because the FreeRTOS is a part of ESP-IDF framework [27]. The SensorBoard API can be used together with Arduino API for ESP32, too.

32

3.2. Application Programming Interface

The SensorBoard API implements

- Peripherials:

– MPU9250 Accelerometer, dynamic gyroscope and magnetometer

– BMP280 Barometer (Altitude meter)

– Programmable LEDs Two green LEDs

– PWM Servo output Controlling connected servos or regulators

– File System SD card and SPI file system

– ADP5062 Battery charger and power supply configuration

– Buttons Read button state as input device

– WiFi Access Point, FTP server, remote control and communication protocol

- Internal functionality:

– Global Settings Configuration file stored on the SD card

– Stopwatch Checking the timing of tasks

– Test Sensor Virtual sensor used for testing other functionalities

- Partially implemented and actually unused

– BMI160 Acclerometer and dynamic gyroscope

– LTR-329ALS Light sensor

– SI7006 Humidity and teperature sensor

The API is documented in the source code and in the separate generated file.

### 3.2.2 General API for the controllers

Both controllers used on the SensorBoard have an API defined and implemented by the manufacturer.

Atmel SAM D21: [55]

- AC – Analog Comparator (Callback APIs)
- ADC – Analog-to-Digital Converter (Polled APIs)
- T30TSE75X Temperature Sensor
- AT45DBX DataFlash
- AVR2025 – IEEE 802.15.4 MAC Stack

v3.1.1

- AVR2025 – TAL
- AVR2025 – TFA
- AVR2025-MAC Serial Interface Module
- AVR2130 – LW MESH v1.2.1
- BOD – Brown Out Detector

33

3. SOFTWARE
- CRC-32 calculation
- CRC32 – 32-bit cyclic redundancy check
- DAC – Digital-to-Analog Converter (Callback APIs)
- Debug Print (FreeRTOS)
- Delay routines
- EEPROM Emulator Service
- Ethernet Physical Transceiver (ksz8851snl)
- EVSYS – Event System with interupt hooks support
- EXTINT – External Interrupt (Polled APIs)
- FatFS file system
- Generic board support
- GFX Monochrome – Menu System
- GFX Monochrome – Monochrome Graphic Library
- GFX Monochrome – Spinner/Spin control widget
- GFX Monochrome – System Font
- Interrupt management – SAM implementation
- IOPORT – General purpose I/O service
- Memory Control Access Interface
- NVM – Non-Volatile Memory
- PAC – Peripheral Access Controller
- Performance Analyzer Application
- PORT – GPIO Pin Control
- QTouch Library for SAMD20/D21
- RTC – Real Time Counter in Calendar Mode (Callback APIs)
- RTC – Real Time Counter in Count Mode (Callback APIs)
- SAM D20/D21 implementation of AT25DFx SerialFlash with vectored master SPI
- SD/MMC stack on SPI interface
- SERCOM I2C – Slave Mode I2C (Polled APIs)
- SERCOM SPI – Serial Peripheral Interface (Callback APIs)
- SERCOM SPI – Serial Peripheral Interface (Master Mode, Vectored I/O)
- SERCOM USART – Serial
Communications (Polled APIs)
- Serial I/O – Host using UART
- Serial I/O – NCP Using UART
- Sleep manager – SAMD
implementation
- Smart Card
- SSD1306 OLED controller
- Standard serial I/O (stdio)
- SYSTEM – Clock Management for SAMD20
- SYSTEM – I/O Pin Multiplexer
- TC – Timer Counter (Callback APIs)
- Unit test framework – SAM0 implementation
- USART – Serial interface – SAM implementation for devices with only USART
- WDT – Watchdog Timer (Polled APIs)

34

3.2. Application Programming Interface

Espressif ESP-WROOM-32: [56]

- Wi-Fi

– Wi-Fi
– Smart Config

– ESPNOW

- Mesh

– ESP Mesh

- Bluetooth

– Bluetooth Controller && VHCI

– Bluetooth Common

– Bluetooth LE

– Bluetooth Classic

- Ethernet

– Ethernet

- Peripherals

– ADC

– DAC
– GPIO (including RTC low power I/O)

– I2C

– I2S
– LED Control

– MCPWM
– Pulse Counter

– Remote Control

– SDMMC Host

– SD SPI Host
– Sigma-delta Modulation

– SPI Master
– SPI Slave

– Timer
– Touch Sensor

– UART

- Protocols

– mDNS

– ESP-TLS

- Storage

– SPI Flash and Partition APIs

– SD/SDIO/MMC Driver

– Non-Volatile Storage

– Virtual Filesystem

– FAT Filesystem

– Wear Levelling

– SPIFFS Filesystem

- System

– FreeRTOS

– FreeRTOS Hooks

– Heap Memory Allocation

– Heap Memory Debugging

– Interrupt Allocation

– Watchdogs

– Inter-Processor Call

– High Resolution Timer

– Logging

– Application Level Tracing

– Power Management

– Sleep Modes

– Base MAC address

– Over The Air Updates (OTA)

– ESP pthread

- Configuration Options

– Kconfig

35

3. SOFTWARE

Figure 3.8: Simple logging application with SensorBoard

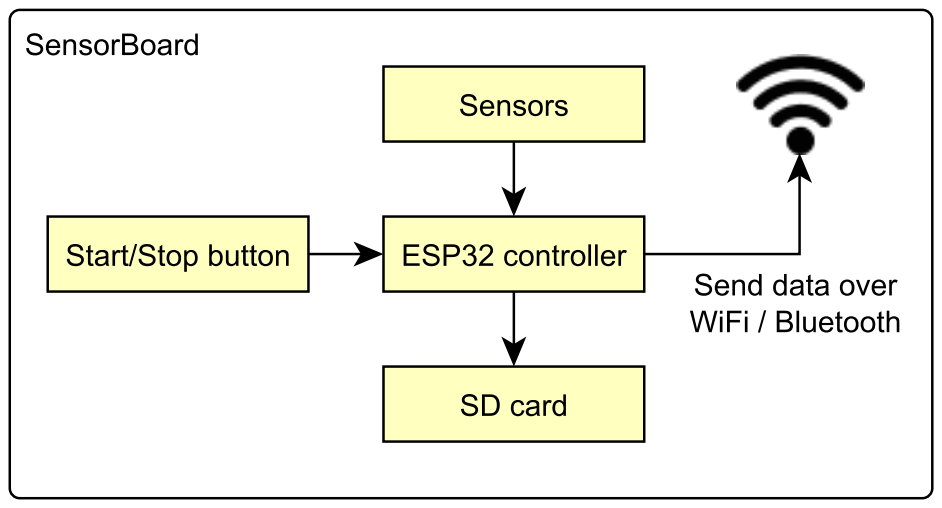
[picture p26: figure]

## 3.3 Usage Examples

The SensorBoard is a multifunctional user programmable hardware that can be used in several ways. There are some examples presented in this section.

### 3.3.1 Sensors data logger

Sensor logger can be understood as very simple logging device or as a very advanced application with an integrated web server and with the ability to connect more boards into one synchronized grid with centralized control. The simple version is shown in figure 3.3.1.
When we need to measure some inertial data, we sometimes need more sensors placed in different places. Then, it’s a big advantage when we can start and stop all the sensors synchronously and control all of them by one button. This solution is shown in figure 3.3.1. I’m using this advanced configuration during the analysis of a movement of a horse. This solution is explained in detail in section 3.4. The goal of this task is to recognize the type of the movement of a horse (stand, walk, trot or gallop). So, we can get some results from only one sensor, but we get better results when we can measure each leg and the body separately. How the SensorBoards are used in this task is shown in figure 3.3.1.

### 3.3.2 Sensor fusion and AHRS

Sensor fusion is a method that combines data from more sensors and calculates new information. The new information is read from the sensor fusion algorithm like from a virtual sensor. [57]

36

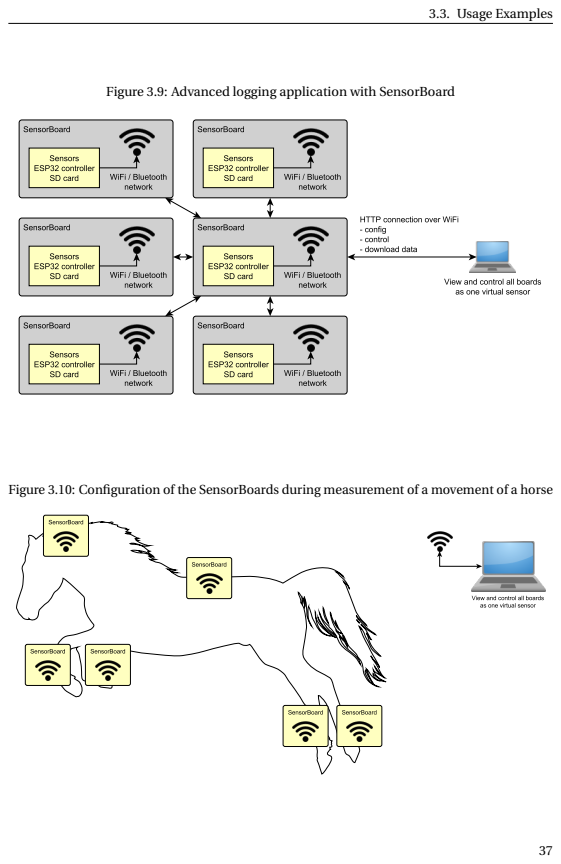
[picture p27: page 45]
3.3. Usage Examples

Figure 3.9: Advanced logging application with SensorBoard

Figure 3.10: Configuration of the SensorBoards during measurement of a movement of a horse

3. SOFTWARE

Figure 3.11: Sensor fusion example on custom AHRS

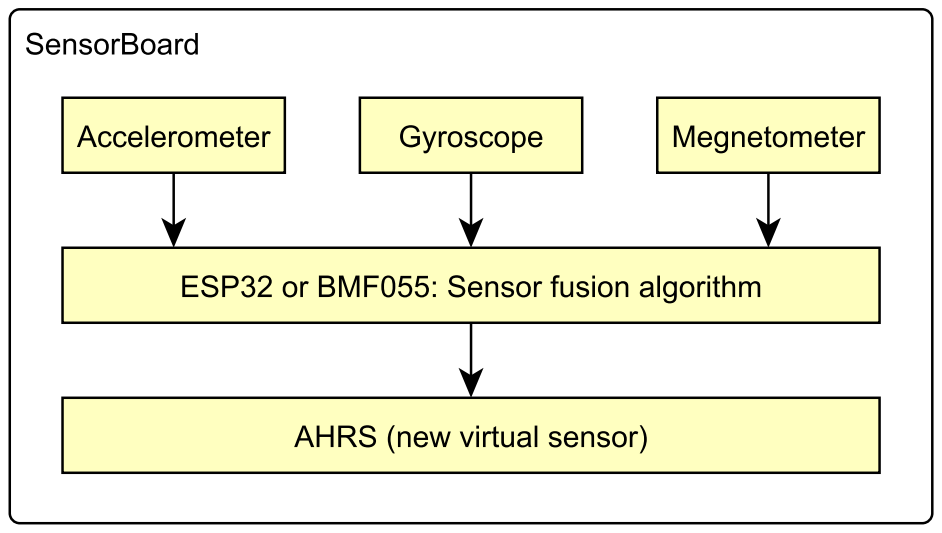
[picture p28: figure]

This example shows how to use a sensor fusion algorithm to computing AHRS data on the SensorBoard. AHRS is Attitude and heading reference system and computes pitch, roll and yaw values from triaxial accelerometer, dynamic gyroscope and magnetometer data. We can use for example Madgwick’s algorithm [58] in the way shown in figure 3.3.2. This application is a base step for example 3.3.3.
We can use an advantage of two controllers at one board and run the sensor fusion algorithm on the BMF055 chip and the ESP32 is still free for some user program like is shown in figure 3.3.2. When an error occurs in the user program, the sensor fusion at BMF055 chip continues to run without any problem. This feature is a big advantage for Flight Controllers where we want to allow the user to run for example his navigation code.

### 3.3.3 UAV Flight controller with non-critical user programmable processor

The flight controllers must be very reliable devices. They usually consist of two parts. The first part controls the pitch, roll, yaw, velocity, the angle of attack etc. The second part is a navigator that processes user commands and makes high-level flight planning. The pilot’s input can be processed on both parts. We usually want to create only the basic control algorithm, which is safety critical and develop all the remaining as a non-critical code.
Here we can use dual controller advantage on the SensorBoard and run the basic critical code at the first controller and the remaining non-critical code on the second controller. The non-critical program on the second controller is usually a navigator or user program. The figure 3.3.3 shows the possible configuration of the flight controller on the SensorBoard. This configuration uses BMF055 Flight Controller [52] by Lukas Blocher. His code can be compiled

38

3.3. Usage Examples

Figure 3.12: Sensor fusion AHRS example with two controllers

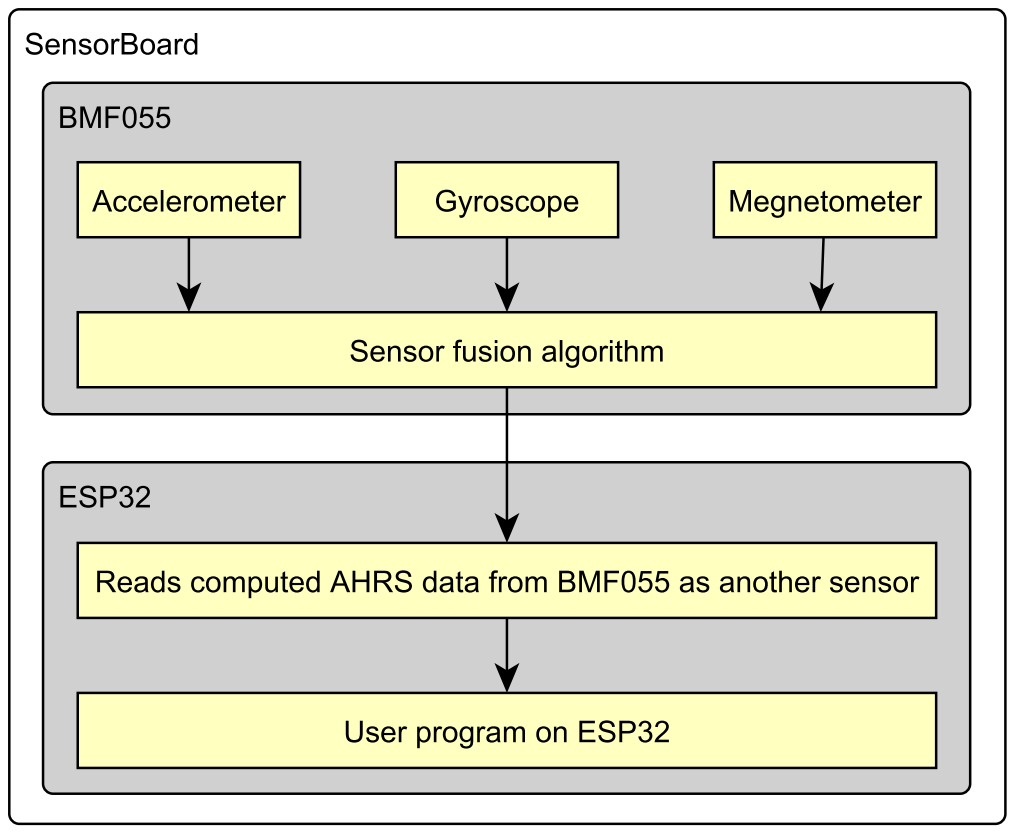
[picture p29: figure]

directly for the SensorBoard without any modification.

### 3.3.4 Indoor navigation using TDOA

Indoor navigation requires high accuracy positioning. We usually need higher accuracy than given by GPS. I know so many projects approaching the indoor positioning. There was, for example, an Indoor Positioning and Indoor Navigation conference in September 2017 in Japan. This example uses Time Difference of Arrival (TDOA) method to compute its position in space with the precision of 10 cm. The device measures time differences in received messages from other devices. When the device knows the time differences and the speed of light, it can compute its relative position to the other boards. There is a DWM1000 chip that is able to measure and compute these data. [11]. The figure 3.3.4 shows how the relative positioning works on the SensorBoard.
The DWM1000 [11] module is present on SensorBoard and when it connects to at least

39

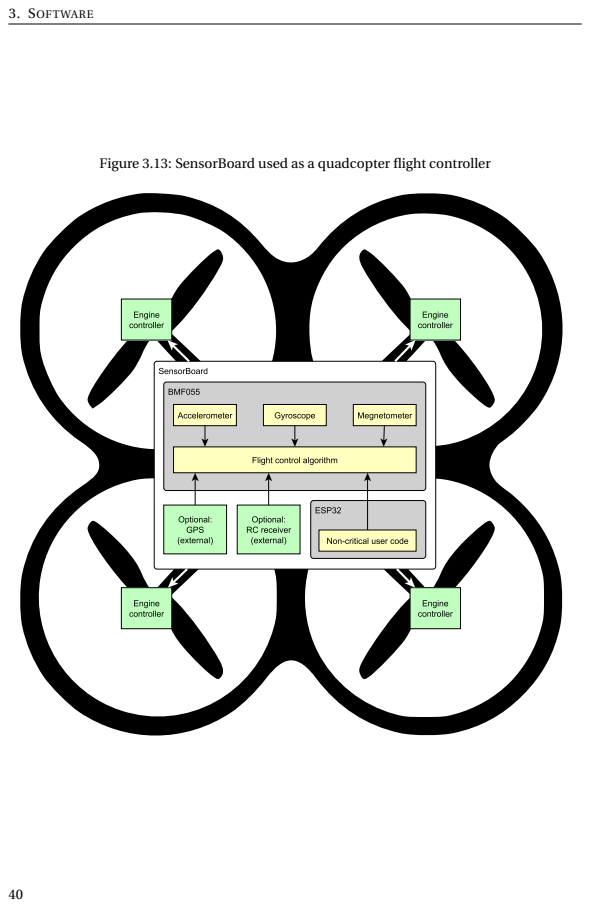
[picture p30: page 48]
3. SOFTWARE

Figure 3.13: SensorBoard used as a quadcopter flight controller

3.3. Usage Examples

Figure 3.14: TDOA relative location service on the SensorBoard

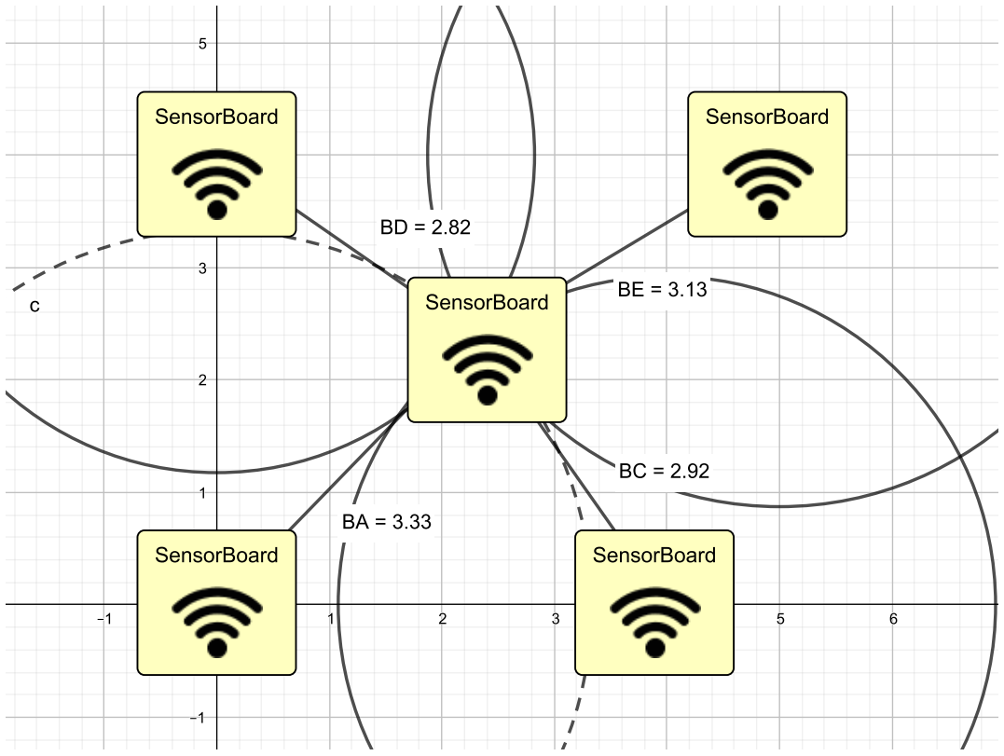
[picture p31: figure]

three other boards, then it computes its relative position with the mentioned precision. When the board knows an absolute position of the other boards, it can compute its absolute position, too. The absolute location can be obtained for example from GPS receiver or from static transmitters.
When we use the AHRS mentioned in section 3.3.2, we have all data about current position and attitude of the SensorBoard. We can use some other sensors on the SensorBoard like BMP280 barometer [13] to improve the current position and attitude data.

### 3.3.5 RTOS education board

Real-time systems are different from common operating systems in personal computers and they cannot be emulated as a standard application for a computer with the common operating system. The common operating system doesn’t give a guarantee that a job completes on time, so any application running on this operating system cannot give this guarantee, too.
The ESP32 controller on the SensorBoard uses FreeRTOS and supports all its functionality.
[59] So, we can run a hard real-time system on the SensorBoard or on the other hand, we can use the SensorBoard for education about real-time systems. Simple FreeRTOS application uses

41

3. SOFTWARE

Figure 3.15: FreeRTOS application diagram on ESP32 on the SensorBoard

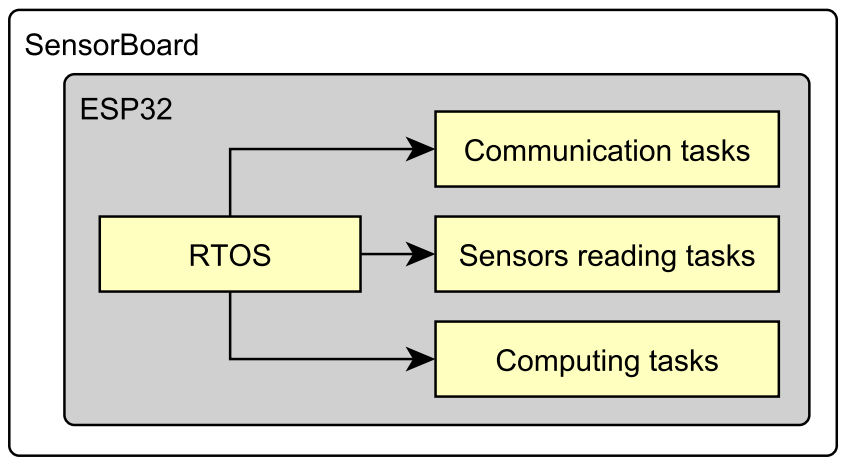
[picture p32: figure]

only the ESP32 controller like is shown in figure 3.3.5 and optionally we can use the sensors as data sources and as resources.

### 3.3.6 MicroPython Robot Controller

The SensorBoard supports MicroPython firmware [45] on the ESP32 controller. When we create a Python library that implements simple API for controlling some electromechanical device. We can use the SensorBoard as a controller of this electromechanical hardware. Then we simply send Python commands via UART or WiFi to the target device.
In my opinion, this setup is an easy way how to teach the basics of programming (in Python) with some dynamic hardware. This way of teaching is probably easier for the students and it probably creates more interactivity between students and the device. The figure 3.3.6 shown an example of using MicroPython inside the SensorBoard.

### 3.3.7 WiFi AccessPoint with server services

The ESP32 controller has a built-in Bluetooth and WiFi module. So, we can create any WiFi based application on the SensorBoard. The only limitation is memory (SD card up to 32 GB) and CPU power (dual-core 240 MHz). We can use the SensorBoard for example as a simple HTTP server [60] or FTP server [61] or implement any other WiFi-based service like is shown in figureUEWiFi.

### 3.3.8 Grid computing education board

The biggest advantages of the SensorBoard are hidden in its real-time system, wireless technology and independence. These advantages can create a grid of multiple items. Then we can use

42

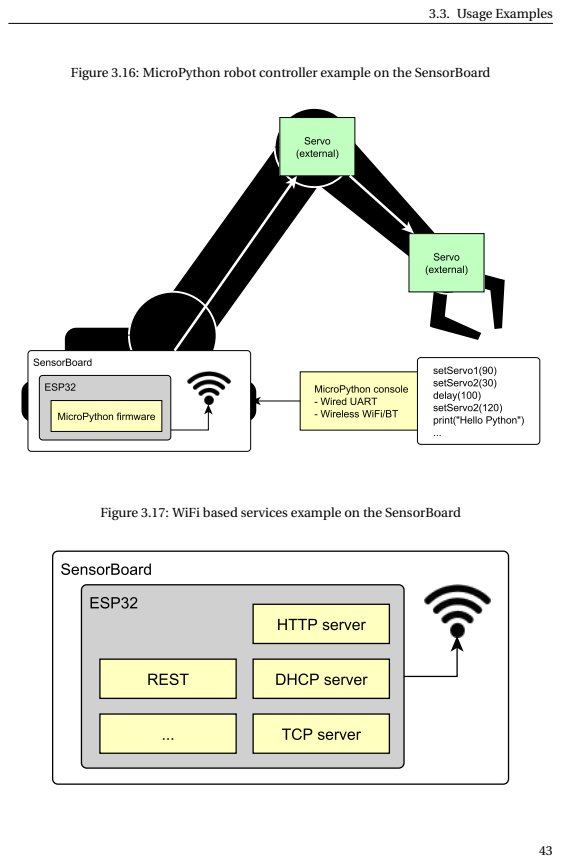
[picture p33: page 51]
3.3. Usage Examples

Figure 3.16: MicroPython robot controller example on the SensorBoard

Figure 3.17: WiFi based services example on the SensorBoard

3. SOFTWARE

Figure 3.18: Example of a grid with two failures created from multiple SensorBoards

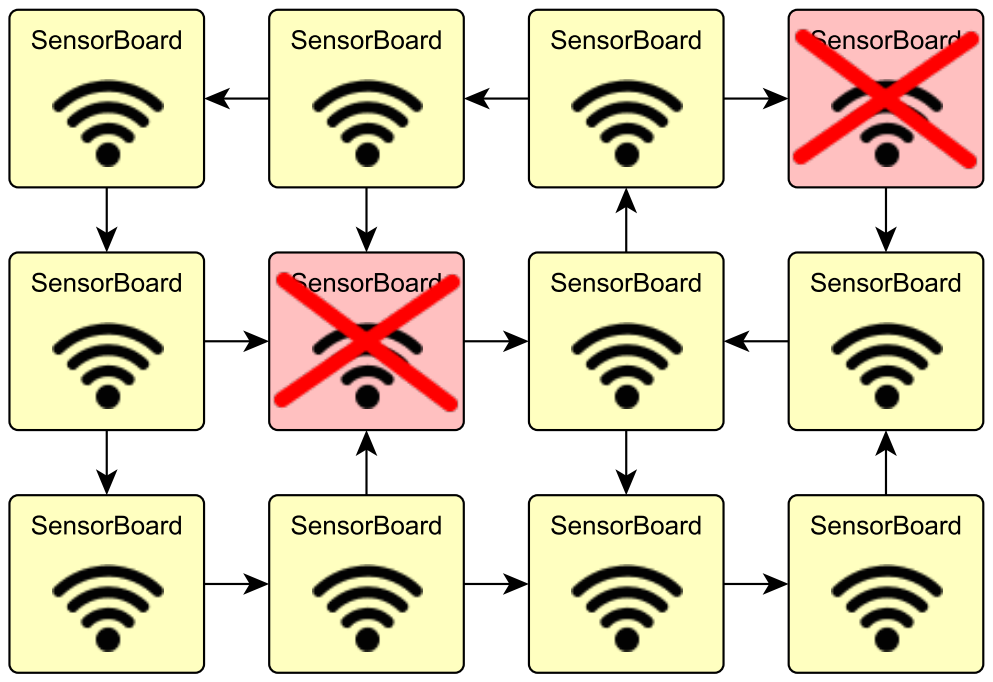
[picture p34: figure]

the whole grid as one virtual unit. When we solve the problems with failures and accessibility, we have a grid solution with swappable items. An example of a grid with two failures is shown in figure 3.3.8.

### 3.3.9 IoT wireless sensors

The Internet of Things (IoT) is a commercially used word for all devices connected to the Internet with some sensors onboard. The SensorBoard fulfills both conditions and it can be used directly this way. The figure 3.3.9 shows an example of using the SensorBoard as a device reading sensors data and streaming them via GSM network or via WiFi connection.

## 3.4 Movement Analysis Firmware

The firmware is a sensor data logging application similar to the example in section 3.3.1. The program is able to read values from sensors in a defined frequency and store the captured data to SD card and/or send them directly via WiFi. The application is controlled by start/stop button or via TCP connection.

44

3.4. Movement Analysis Firmware

Figure 3.19: Example of using SensorBoard as an IoT device streaming data from sensors via

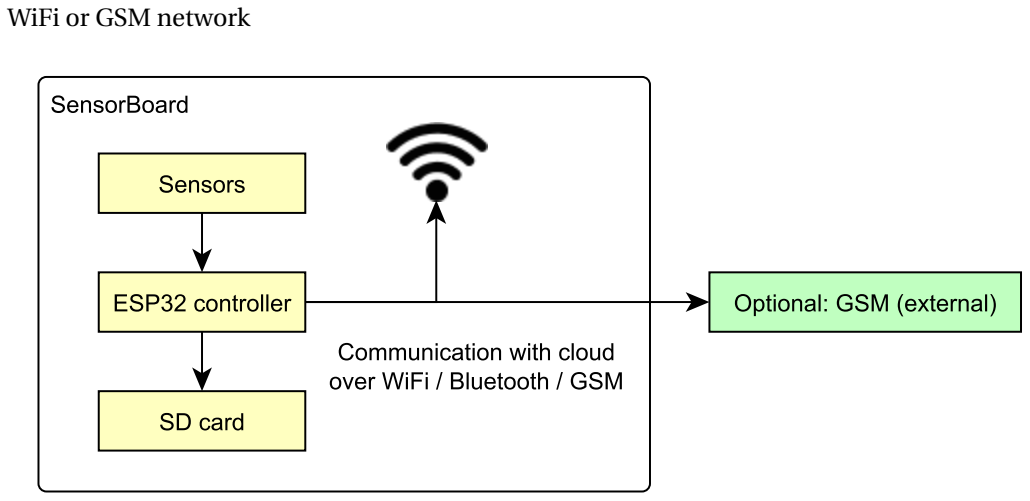
[picture p35: figure]
WiFi or GSM network

When the SensorBoard is switched on, it initializes WiFi access point and waits 5 seconds before the reading and logging procedure starts. After these 5 seconds, the board enters a loop and starts logging data to SD card. The logging loop can be stopped via TCP connection, by pressing the start/stop button or by switching the board off.
When we want to control the SensorBoard via TCP client, we have to connect our device to SensorBoard’s WiFi access point. Then we can connect to the TCP server and send the control commands.

### 3.4.1 Before first use

All the configuration is saved in config.ini file on the SD card (root directory). The configuration is read every time when the SensorBoard is powered on. The configuration file is never modified by the SensorBoard. An example of the configuration file is in figure 3.4.1. If no configuration file is present on the SD card, default values are used.

### 3.4.2 Files on the SD card

All the files are stored and read from the root directory of the SD card. The files are:

- config.ini: (read-only) Configuration file explained in section 3.4.1.
- counter.txt: (read/write) This text file contains only one integer on the first line, other data are ignored. The SensorBoard has no real-time clock reference, so it cannot add a timestamp to each log file. The board increments this number after each startup. This number is used as session number of each log file.

45

3. SOFTWARE

Figure 3.20: Example of the configuration file on SD card

% Enable or disable WiFi adapter
isWiFienabled = true

% Initializes WiFi as an access point when true, otherwise as a station isWiFiAccessPoint = true

% Network SSID
% When initialized as a station: tries to connect % to an existing network with this SSID
% When initialized as AP: creates the new network WiFiSSID = SensorBoard

% WiFi network password
WiFiPassword = 1234567890

% IP address of the device,
% if initialized as an access point, we can use 192.168.1.1 myIP = 192.168.1.1

% TCP server port
TCPseverPort = 3000

% If enabled, starts logging automatically ’startUpWaitTime’ seconds % after powered on
startLoggingImmediately = true

% Waits N milliseconds before entering the logging loop startUpWaitTime = 5000

% If enabled, the horse movement analysis starts automatically isHorseAnalysis = false

% If enabled, the data streaming starts automatically
isStreaming = false

% If enabled, the logging can be controlled by the start/stop button isStartButtonUsed = false

46

3.4. Movement Analysis Firmware

Figure 3.21: Example of the ’format.txt’ file on SD card.

’S’; #; milliseconds; baroAltitude QFE [m]; baroTemp [degree C]; | \
ACC_X [g]; ACC_Y [g]; ACC_Z [g]; | \
GYR_X [rad/s]; GYR_Y [rad/s]; GYR_Z [rad/s]; | \
MAG_X [degree]; | MAG_Y [degree]; | MAG_Z [degree]; | \
- X_Y_log.csv: (write only) The main log file in CSV format. The name consists of the session number X, log number Y and the configured filename. The format is X_Y_NAME, for example 12_34_log.csv. It means, that the file was created after 12th switching on, it is 34th log during the session and the configured file name is log.csv.
- format.txt (write only) Format of the CSV main log file. This file contains names of all columns in order in the main log file. Example of this file is shown in figure 3.4.2.
- X_Y_horse.txt: (write only) The movement analysis log file in plain text or CSV format. The X, Y numbers correspond to the main log file numbers. The files with the same numbers were captured simultaneously during the same measurement.

### 3.4.3 Using the firmware

The application is usually used only during the measurement process. The behavior of the program can be described using the state machine presented in figure 3.4.3.
The meaning of each state of the machine:
- Startup Powering on the board
- WiFi initialization Initialization of the WiFi adapter according to the configuration file
- Waiting N seconds Waiting a few (milli)seconds according to the configuration file. We usually configure this waiting when we want to prevent the creation of very short logs.
- System idle The system is waiting for control commands. If the board is configured to start logging immediately, the system automatically switches to running state.
- Downloading data The data can be downloaded directly from the SD card or to a connected device.
- Running The Running state starts the measuring loop and allows to log, stream or analyze the measured data. It’s not possible to download data from SD card in this state. This state is activated when the user starts logging, streaming or movement analysis process from the Idle state. The Running state can be activated automatically according to the configuration file.

47

3. SOFTWARE

Figure 3.22: State machine of the firmware

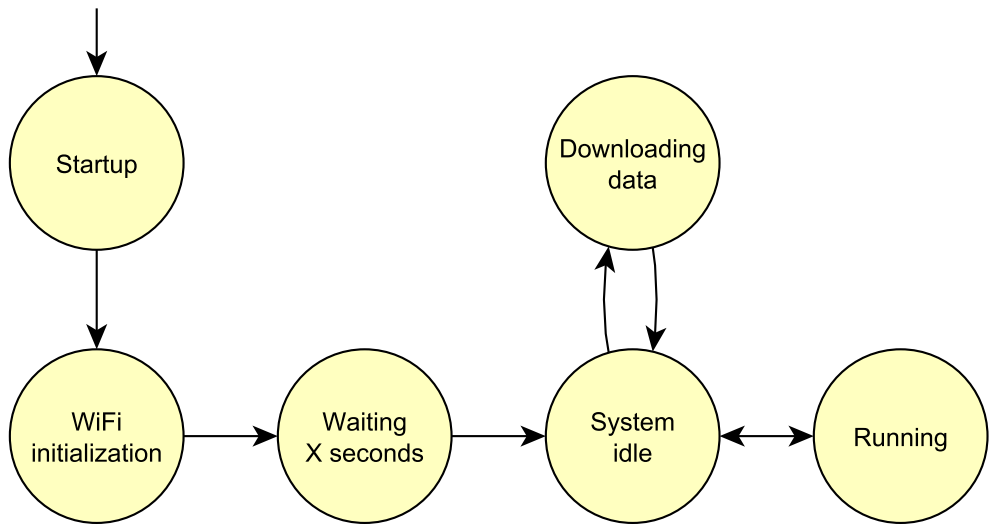
[picture p36: figure]

### 3.4.4 Horse movement analysis feature

The application has built-in movement analysis tool. When the SensorBoard is placed on a horse’s body, the tool can determine when the horse is moving and what kind of movement it does. The figure 3.4.5 shows a screenshot from the tablet used for controlling the SensorBoard during measurement process on a horse’s body.
This tool demonstrates that the SensorBoard is able to run some user code in real-time with real-time results.

### 3.4.5 Controlling via TCP connection

The application can be controlled via TCP connection using single letter commands. I recommend implementing a web-page based user interface in the future versions of the application. One letter commands are actually used because it’s the easiest way how to control the board from a tablet with on-screen keyboard only. All the communication is possible via the TCP connection or via UART through USB connection. The control commands are:

r Reset the board and restart the application. We get the same result when we switch the board off and on.

p Ping command. When received, the text "Ping received." is printed.

h Start/stop the horse movement analysis. When the analysis is running the text output is sent every second.

s Start/stop streaming the raw data from the sensors.

48

3.4. Movement Analysis Firmware

l Start/stop logging the raw data from the sensors to the SD card. When the logging is in progress, the green software LED is ON on the SensorBoard.

Figure 3.23: Screenshot of the tablet used for controlling the SensorBoard during measurement process


### 3.4.6 Using multiple SensorBoards

When we have more SensorBoards, we can connect them like in figure 3.3.1. Then all the hardware connected together behaves like one SensorBoard with so many sensors in different places. All the SensorBoards should connect to one WiFi network created by one board or by an external WiFi access point (e.g. mobile phone tethering/hotspot). All the SensorBoards except one (must be configured in the configuration file on SD card) behaves as TCP clients and connects to TCP server (the last SensorBoard). The TCP server resends all the commands to the other boards, so all the SensorBoards behaves synchronously. The log files are stored on the SD card on each board and the names of these files are the same on all connected boards. So, the TCP server dictates the names of all log files. One synchronous session creates multiple files on multiple SD cards, but with the same filenames on all devices.
The whole system of connected boards can be used for example like in figure 3.3.1.

49

## C H A P T E R

4

## CONCLUSION

The work was finally split into four milestones. The first milestone was achieved when I have decided to develop a new data logging hardware because the existing solutions didn’t fulfill all the requirements. I have successfully developed the SensorBoard hardware in the second step and then the board was manufactured in six copies. I have achieved the second milestone with the manufactured hardware. The third phase was about testing the hardware and about implementing libraries for communication between the controller and other parts, mainly sensors. I have found several mistakes in the hardware design during programming, but all of them were corrected. The third milestone was achieved when I had a working hardware with C++ libraries for easier communication with sensors and other parts of the hardware. These libraries are a part of the API. During the last phase, I have implemented the firmware for real-time movement analysis. When the SensorBoard is placed on a horse under the saddle, it is able to recognize the kind of movement of a horse. This firmware demonstrates the functionality of the designed hardware in real use. I have achieved the last milestone during the first successful test of the platform on a horse’s body.
There are many applications and use cases of the SensorBoard presented as examples in the thesis. I have selected the movement analysis case because this task started the whole project in the beginning. The movement analysis firmware shows the advantages of running some user code on the hardware. We can see the results of the analysis in real-time.
If there is an interest in future work with this hardware, I would like to recommend to create the second version of the SensorBoard with attention to the list of hardware errors presented in this thesis. The actual version was designed as a prototype and it’s not recommended for production. The prototype of the SensorBoard was used for example as a simple autopilot of a small quadcopter, so I believe that it will be used in several applications in the near future. I hope that the firmware for the movement analysis of a horse will help to work with this kind of animals easier.

51

## BIBLIOGRAPHY

[1] Sensors for r&d. [Online]. Available: https://mbientlab.com/ 2.4
[2] Ardupilot mega. [Online]. Available: https://www.ardupilot.co.uk/ 2.4
[3] Px4 autopilot. [Online]. Available: https://pixhawk.org/ 2.4
[4] X-imu our original versatile imu board. [Online]. Available: http://x-io.co.uk/x-imu/ 2.4
[5] Product card TACTM-35N-F, Ninigi, 01 2018. 2.5, 2.8
[6] Linear Li-Ion Battery Charger with Power Path and USB Compatibility in LFCSP, Analog Devices, 2 2017, rev. B. 2.5, 2.8
[7] Linear LiFePO4 Battery Charger with Power Path and USB Compatibility in LFCSP, Analog Devices, 2 2017, rev. 0. 2.5
[8] I2C HUMIDITY AND TEMPERATURE SENSOR, Silicon Laboratories, 8 2016, revision 1.2. 2.5, 2.8
[9] HDC2010 Low Power Humidity and Temperature Digital Sensors, Texas Instruments, 3 2018, revision A. 2.5
[10] Datasheet SHTC1 Humidity and Temperature Sensor IC, Sensirion, 8 2015, version 4. 2.5
[11] DWM1000 IEEE 802.15.4-2011 UWB Transceiver Module, Decawave Ltd, 8 2016, v1.6. 2.5, 2.8, 3.3.4, 3.3.4
[12] DW1000 IEEE802.15.4-2011 UWB Transceiver, Decawave Ltd, 2015, version 2.09. 2.5
[13] BMP280 Digital Pressure Sensor, Bosch Sensortec, 05 2015. 2.5, 2.8, 3.3.4
[14] Digital pressure sensor, Bosch Sensortec, 01 2018, revision 1.0. 2.5
[15] FT232R USB UART IC, Future Technology Devices International Ltd, 11 2015, v2.13. 2.5, 2.8
[16] Single-Chip USB-to-UART Bridge, Silicon Labs, 01 2017, rev. 1.8. 2.5
[17] USB to serial chip CH340, wch.cn, 2017, version 1D. 2.5

53

BIBLIOGRAPHY

[18] MPU-9250 Product Specification, InvenSense, 6 2016, revision 1.1. 2.5, 2.8
[19] Small, low power Inertial Measurement Unit, Bosch Sensortec, 2 2015, revision 0.8. 2.5, 2.8
[20] BMF055 Custom programmable 9-axis motion sensor, Bosch Sensortec, 11 2015. 2.5, 2.7.3, 2.8, 3, 3.1.2, 3.1.2
[21] H. Xiaoyan and K. S. C. Kuang, “Structural motion monitoring systems using 9-axis sensing modules,” in The 2016 Structures Congress, September 2016, pp. 4–6. 2.5, 2.8
[22] HM-TRP Series 100mW Transceiver modules V1.0, HopeRF Electronic, 2006, v1.0. 2.5, 2.8
[23] MicroSD Memory Card Connector, Molex, 8 2016. 2.5, 2.8
[24] Digital Ambient Light Sensor, LiteON Technology Corp., 2018, revision 1.1. 2.5, 2.8
[25] Ambient Light Sensor – Surface Mount, Everlight America, 12 2013, issue No: 1. 2.5
[26] Ambient Light Sensor with Dark Current Compensation, ON Semiconductor, 11 2017, revision 4. 2.5
[27] ESP-WROOM-32 Datasheet, Espressif Systems, 9 2017, v2.1. 2.5, 2.7.3, 2.8, 3, 1, 3.1, 3.1.1, 3.2.1
[28] ARM-based 32-bit MCU, STMicroelectronics, 8 2016, rev15. 2.5
[29] 300mA, Micropower, VLDO Linear Regulator, Union Semiconductor, 7 2008, rev01. 2.5, 2.8
[30] Very low drop voltage regulator with inhibit function, STMicroelectronics, 5 2017, rev31. 2.5, 2.8
[31] Micro-USB B Receptacle with Flange, Bottom Mount, Surface Mount, Lead-Free, Molex, 3 2018. 2.5, 2.8
[32] BERGSTIK Headers, Amphenol FCI, 7 2016, rev:L. 2.5, 2.8
[33] Easy applicable graphical layout editor. [Online]. Available: https://www.autodesk.com/products/eagle/overview (https://www.autodesk.com/products/eagle/overview) 2.5, 2.5.1, 2.6.1
[34] Kicad eda: A cross platform and open source electronics design automation suite. [Online]. Available: http://kicad-pcb.org/ 2.5
[35] Zadávání zakázek pro strojní osazování dps na osazovacím automatu samsung cp45v. [Online]. Available: http://smtplus.cz/pdf/oa.pdf 2.6.2
[36] Podmínky zadávání zakázek. [Online]. Available: http://smtplus.cz/?page=podminky 2.6.2

54

Bibliography

[37] Export gerber dat z eagle. [Online]. Available: https://www.gatema.cz/www/files/file/eagle-002.pdf (https://www.gatema.cz/www/files/file/eagle-002.pdf) 2.6.2
[38] Technické informace. [Online]. Available: https://www.gatema.cz/plosne-spoje/technicke-informace (https://www.gatema.cz/plosne-spoje/technicke-informace) 2.6.2
[39] Intelligent control LED integrated light source, Worldsemi, 01 2017. 2.7.3
[40] SMART ARM-Based Microcontrollers SAM D20E / SAM D20G / SAM D20J, Atmel, 09 2016. 2.7.3, 3, 2, 3.1.2
[41] Alb32-wrover | – | esp-wroom-32 | module | with | 128mb | flash | and
32mb | psram. | [Online]. | Available: | https://www.analoglamb.com/product/
alb32-wrover-esp32-module-with-64mb-flash-and-32mb-psram/ (https://www.analoglamb.com/product/alb32-wrover-esp32-module-with-64mb-flash-and-32mb-psram/) 2.7.3
[42] ARM Debug Interface Architecture Specification, ARM Holdings, 08 2013, third issue, for ADIv5.0 to ADIv5.2. 3, 3.1.2
[43] E. Systems, “Espressif iot development framework,” https://github.com/espressif/esp-idf, 2018. 3.1.1, 3.1.1
[44] ——, “Arduino core for esp32 wifi chip,” https://github.com/espressif/arduino-esp32, 2018. 3.1.1, 3.1.1
[45] Micropython. [Online]. Available: http://micropython.org/ 3.1.1, 3.1.1, 3.3.6
[46] Arduino support from simulink. [Online]. Available: https://uk.mathworks.com/hardware-support/arduino-simulink.html (https://uk.mathworks.com/hardware-support/arduino-simulink.html) 3.1.1
[47] N. Kolban, Kolban’s Book on ESP32. Leanpub.com, 5 2018, p. 1059. 3.1.1
[48] Esp-idf programming guide. [Online]. Available: https://esp-idf.readthedocs.io/en/v2.0/index.html (https://esp-idf.readthedocs.io/en/v2.0/index.html) 3.1.1
[49] Build and flash with eclipse ide. [Online]. Available: https://esp-idf.readthedocs.io/en/v2.0/eclipse-setup.html (https://esp-idf.readthedocs.io/en/v2.0/eclipse-setup.html) 1
[50] Platformio is an open source ecosystem for iot development. [Online]. Available: https://platformio.org/ 2
[51] A hackable text editor for the 21st century. [Online]. Available: https://atom.io/ 2
[52] L. | Blocher, | “Bmf055-flight-controller,” | https://github.com/NightHawk32/
BMF055-flight-controller, (https://github.com/NightHawk32/BMF055-flight-controller) 2016. 3.1.2, 3.3.3
[53] Atmel studio 7. | [Online]. | Available: http://www.microchip.com/avr-support/
atmel-studio-7 (http://www.microchip.com/avr-support/atmel-studio-7) 3.1.2
[54] Atmel-ice. [Online]. Available: https://www.microchip.com/atatmel-ice 3.1.2
| | | | | | | 55

BIBLIOGRAPHY

[55] Microchip advanced software framework samd20 documentation. [Online]. Available: http://asf.atmel.com/docs/latest/samd20/html/index.html 3.2.2
[56] Esp-idf programming guide api reference. [Online]. Available: http://esp-idf.readthedocs.io/en/latest/api-reference/index.html (http://esp-idf.readthedocs.io/en/latest/api-reference/index.html) 3.2.2
[57] W. Elmenreich, “Sensor fusion in time-triggered systems,” Ph.D. dissertation. [Online]. Available: https://mobile.aau.at/~welmenre/papers/elmenreich_Dissertation_sensorFusionInTimeTriggeredSystems.pdf (https://mobile.aau.at/~welmenre/papers/elmenreich_Dissertation_sensorFusionInTimeTriggeredSystems.pdf) 3.3.2
[58] S. O. H. Madgwick, A. J. L. Harrison, and R. Vaidyanathan, “Estimation of imu and marg orientation using a gradient descent algorithm,” in 2011 IEEE International Conference on Rehabilitation Robotics, 6 2011, pp. 1–7. 3.3.2
[59] Esp-idf programming guide freertos. [Online]. Available: http://esp-idf.readthedocs.io/en/latest/api-reference/system/freertos.html (http://esp-idf.readthedocs.io/en/latest/api-reference/system/freertos.html) 3.3.5
[60] I. Grokhotkov, “Simple http server,” https://github.com/igrr/esp32-http-server, 2018. 3.3.7
[61] C. McIntyre, “Ftp server for the esp-wroom-32,” https://github.com/cgmcintyr/esp32-ftp, 2017. 3.3.7

56
