bsaid/SensorBoard/thesisCloneUIB/img/sensorMount.pdf

Sensor mounted on the:
head
saddle

hoof (cannon)
