bsaid/SensorBoard/thesisCloneUIB/img/peakHeelHillExample.pdf

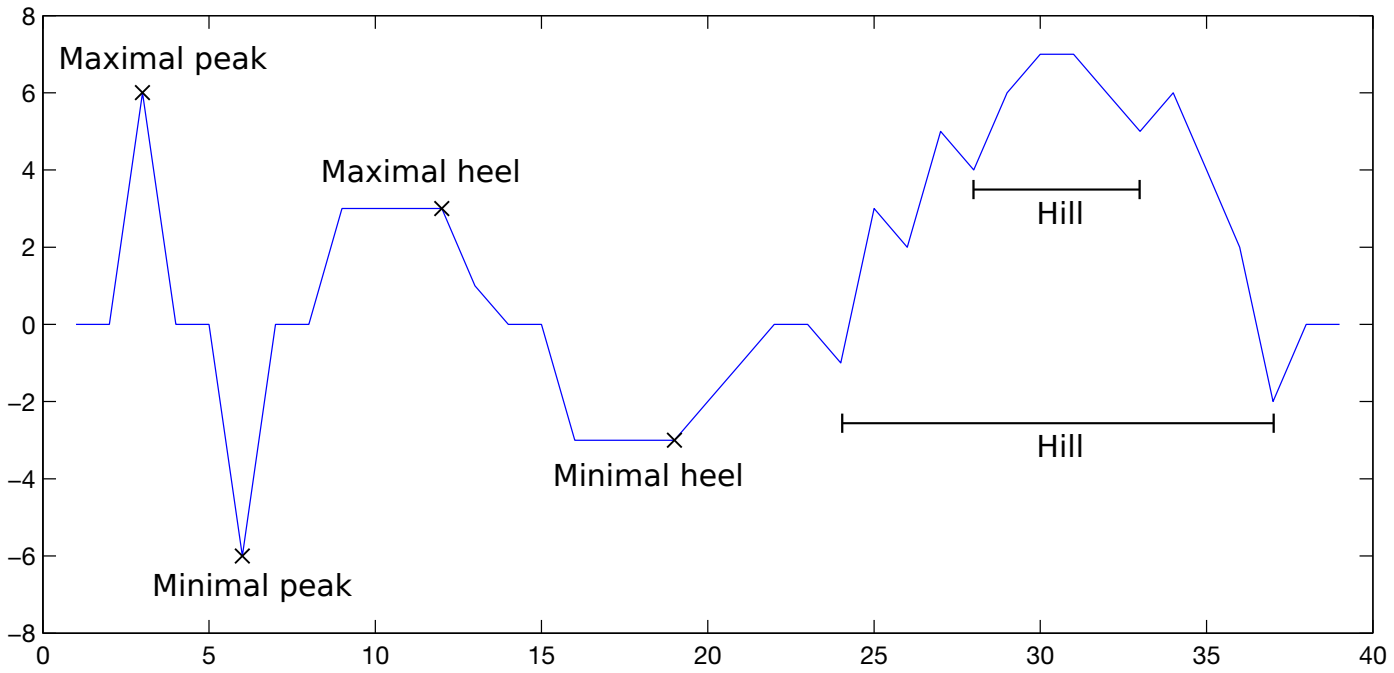
[picture p37: figure]
Maximal peak; Minimal peak; Maximal heel; Minimal heel; Hill
