bsaid/SensorBoard/thesisCloneUIB/img/touchHillDefinition.pdf

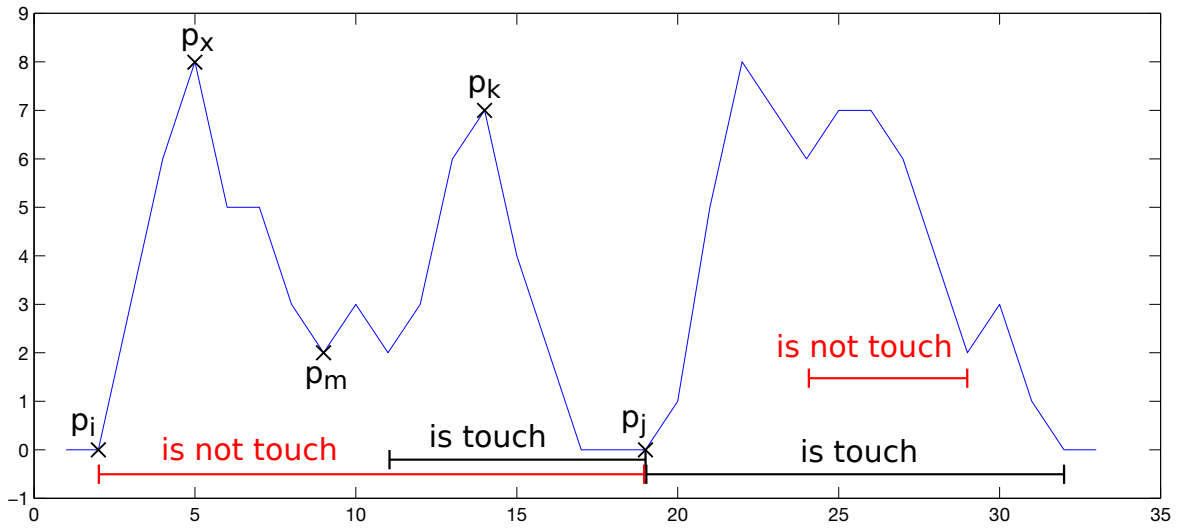
[picture p38: figure]
is touch; is not touch
