bsaid/SensorBoard/thesisCloneUIB/img/touchHillProperties.pdf

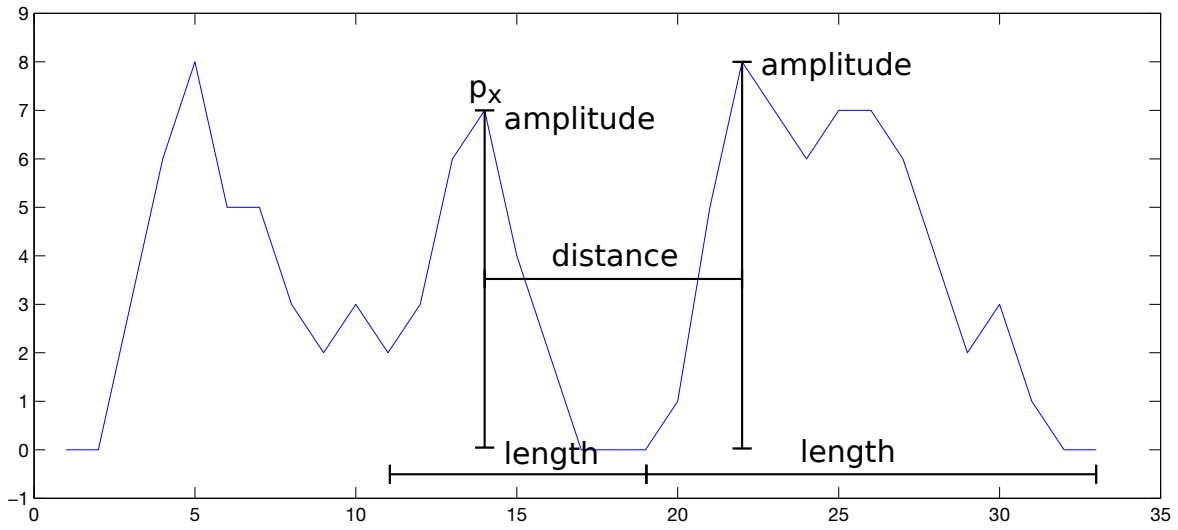
[picture p39: figure]
length; amplitude; distance
