bsaid/SensorBoard/thesis/src/PCBphoto3.jpg

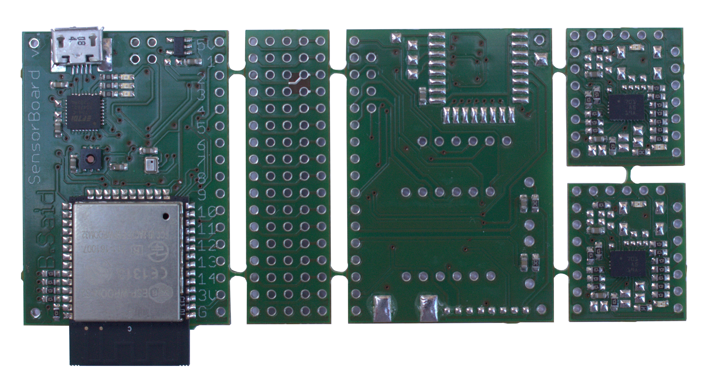
thesis/src/PCBphoto3.jpg
