bsaid/SensorBoard/thesis/src/PythonESPOrig.png

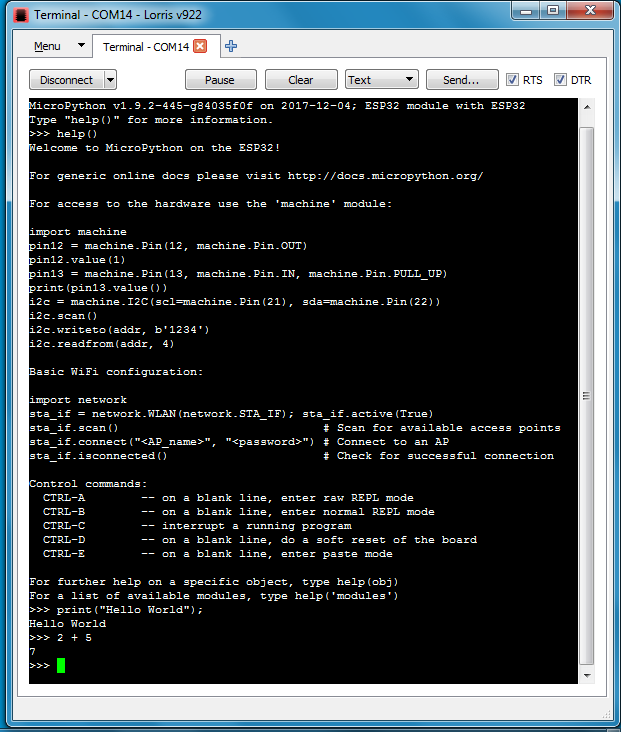
thesis/src/PythonESPOrig.png
