bsaid/SensorBoard/thesis/src/renderBottom2.png

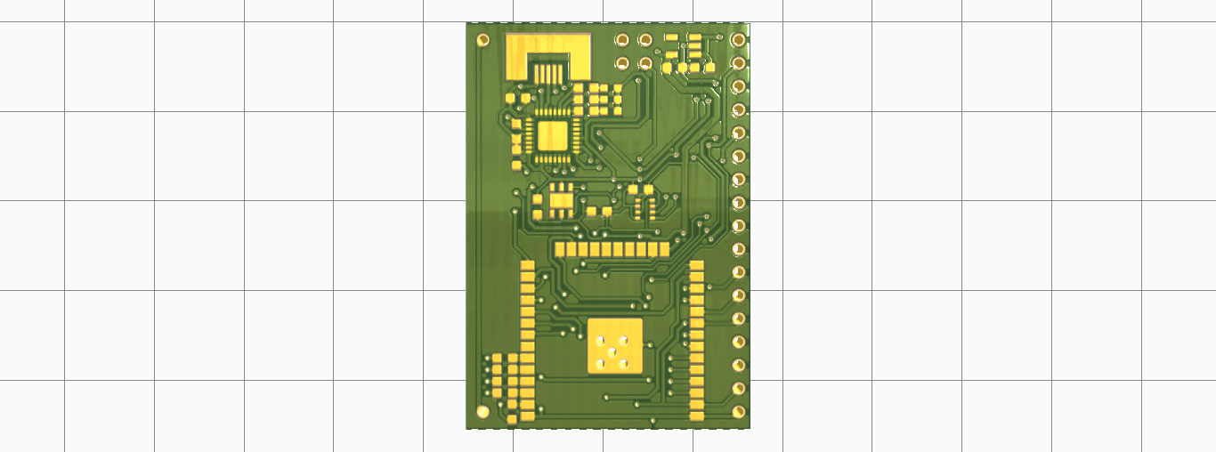
thesis/src/renderBottom2.png
