bsaid/SensorBoard/thesisCloneUIB/img/HorseAnalysisTabletFade.png

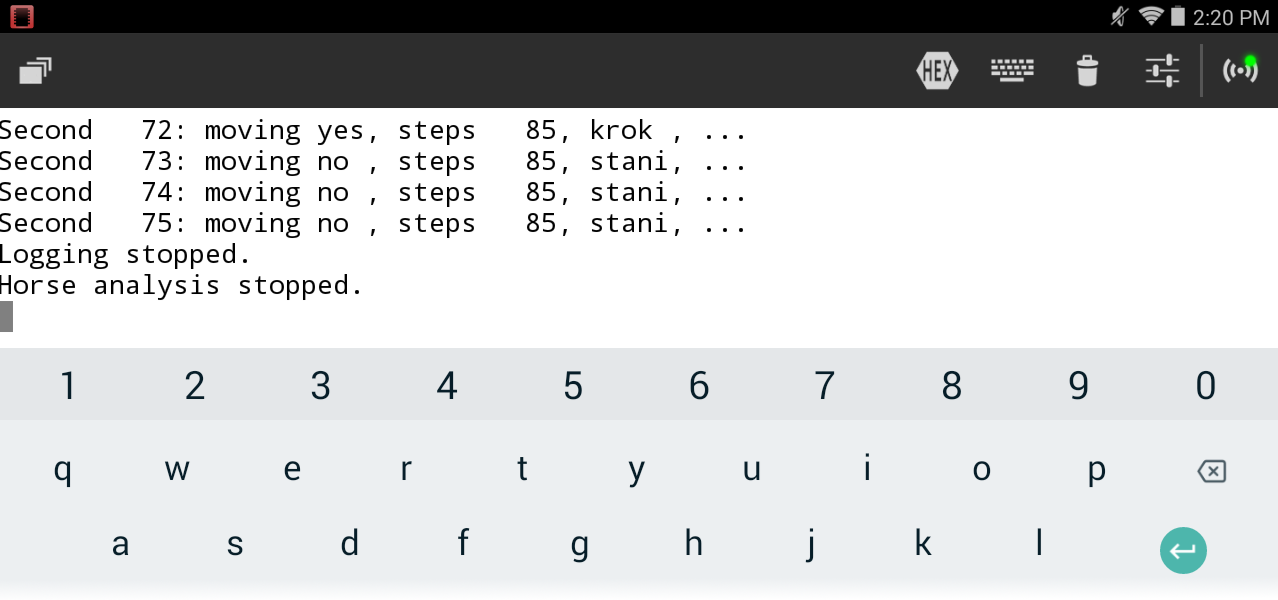
thesisCloneUIB/img/HorseAnalysisTabletFade.png
