bsaid/SensorBoard/thesisCloneUIB/img/renderBMF.png

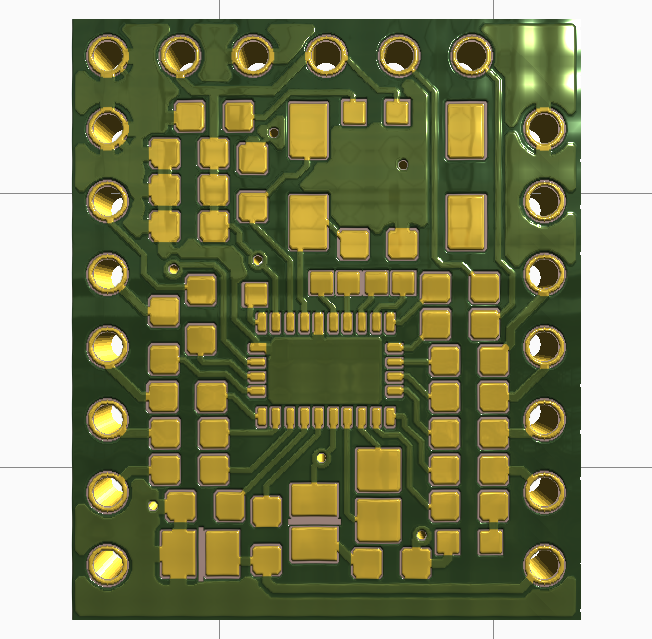
thesisCloneUIB/img/renderBMF.png
