bsaid/SensorBoard/thesisCloneUIB/img/renderBottom.png

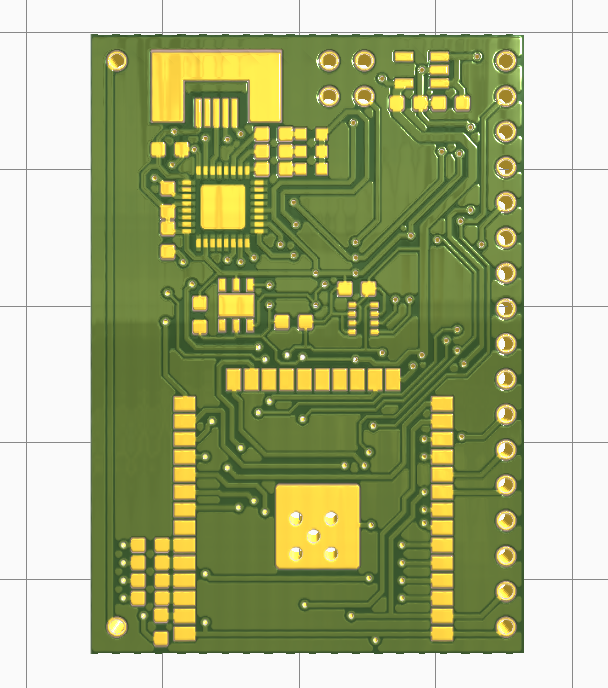
thesisCloneUIB/img/renderBottom.png
