bsaid/SensorBoard/thesisCloneUIB/img/renderTop.png

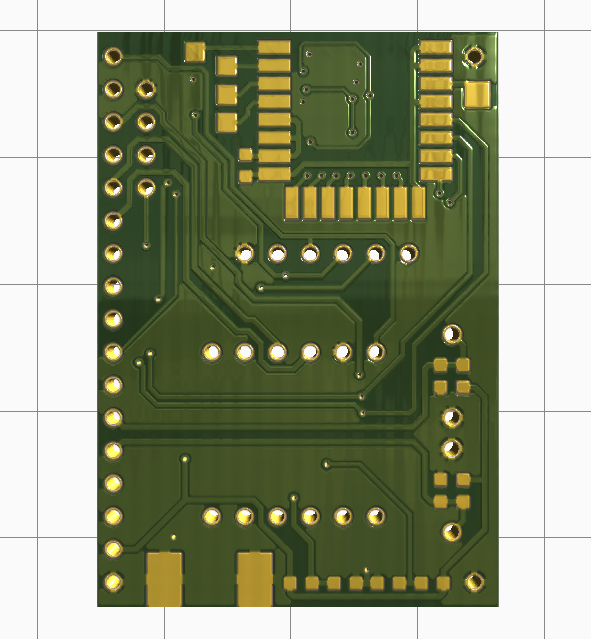
thesisCloneUIB/img/renderTop.png
