bsaid/SensorBoard/thesisCloneUIB/img/HWassembling.pdf

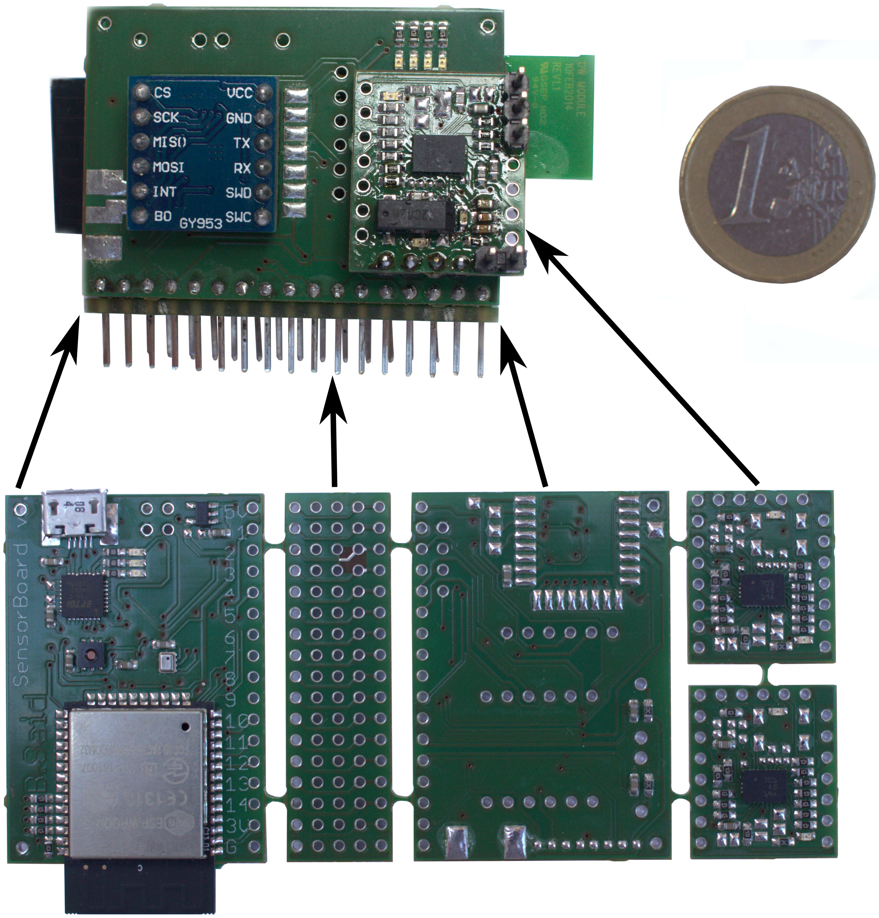
[picture p47: page 1]
