bsaid/SensorBoard/thesisCloneUIB/EvaluationZdenekMatej.pdf

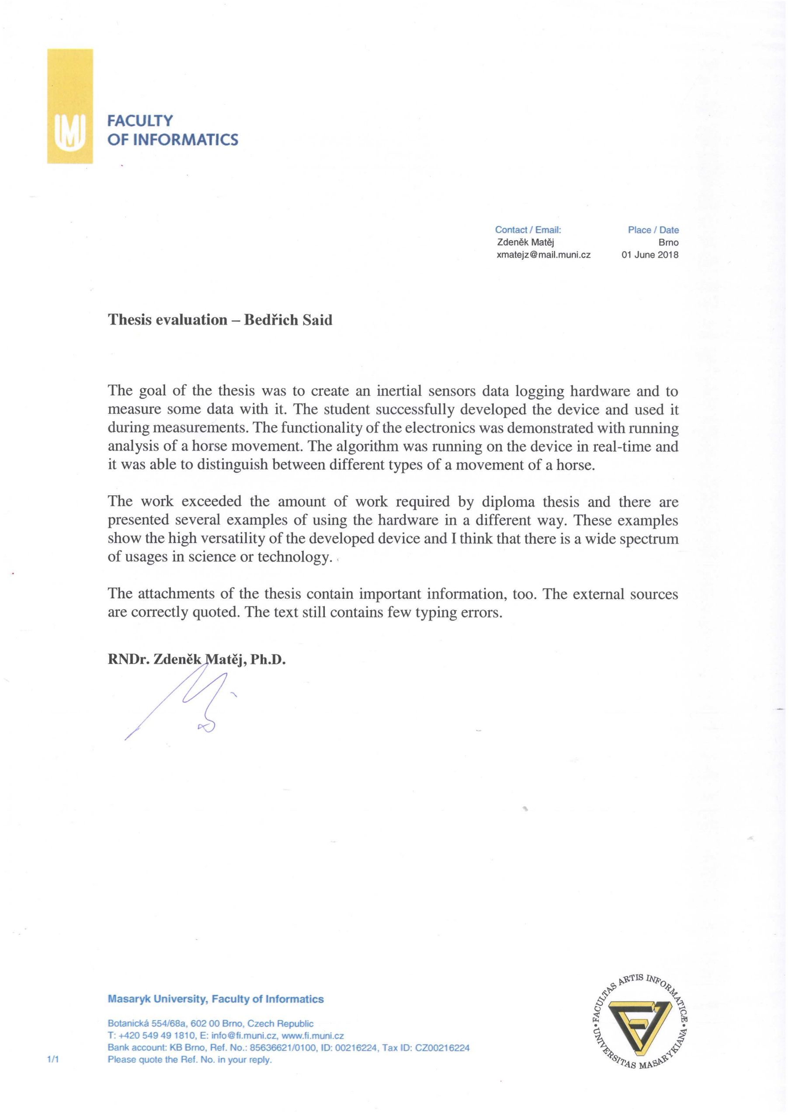
[picture p48: page 1]
