bsaid/SensorBoard/thesisCloneUIB/img/filteredMarked.pdf

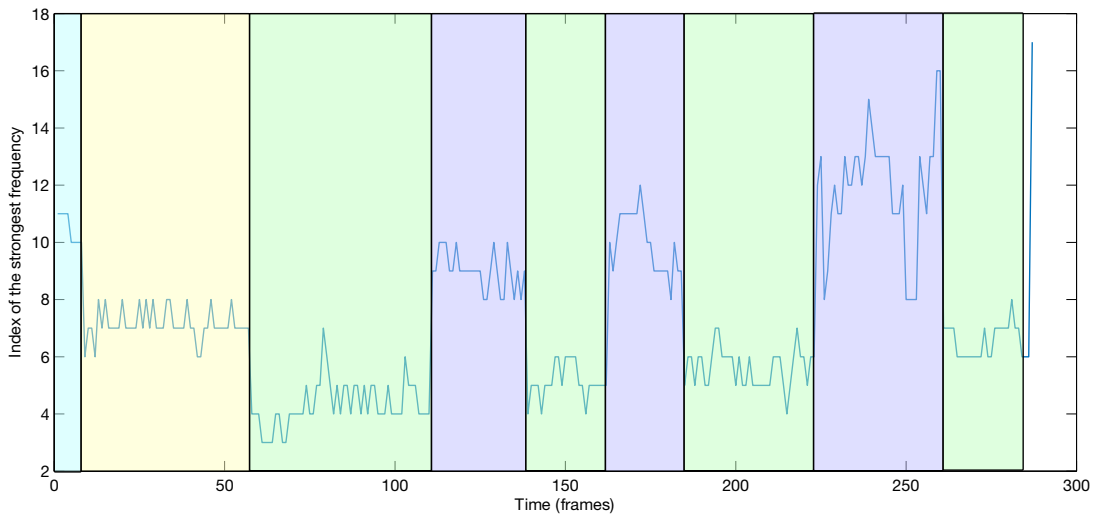
[picture p49: page 1]
Time (frames)

Index of the strongest frequency
