bsaid/SensorBoard/thesisCloneUIB/img/SchLeds.pdf

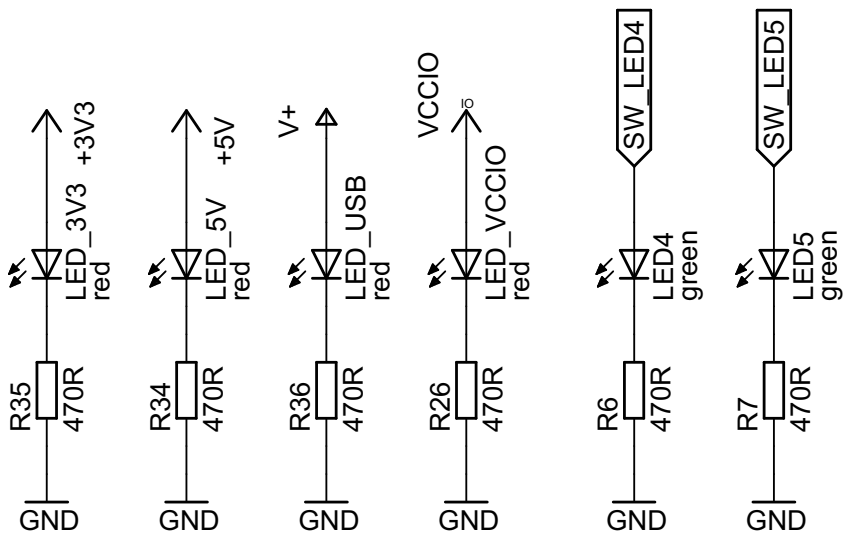
[picture p50: page 1]

red 470R GND 470R GND red green 470R GND green 470R GND red 470R GND 470R GND red VCCIO V+ +5V +3V3 LED_VCCIO R26 R36 LED_USB LED4 R6 LED5 R7 LED_5V R34 R35 LED_3V3 SW_LED4 SW_LED5 IO
