bsaid/SensorBoard/thesisCloneUIB/img/jumpers.pdf

## B used as +5V

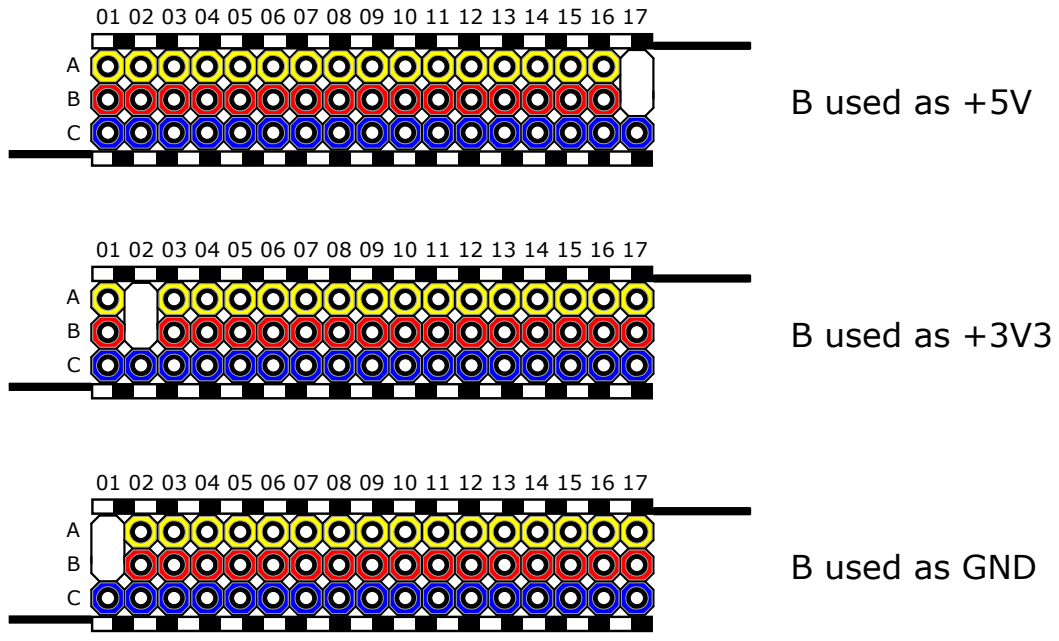
[picture p51: page 1]
B used as +3V3

B used as GND
