bsaid/SensorBoard/thesis/img/brdBottom.pdf

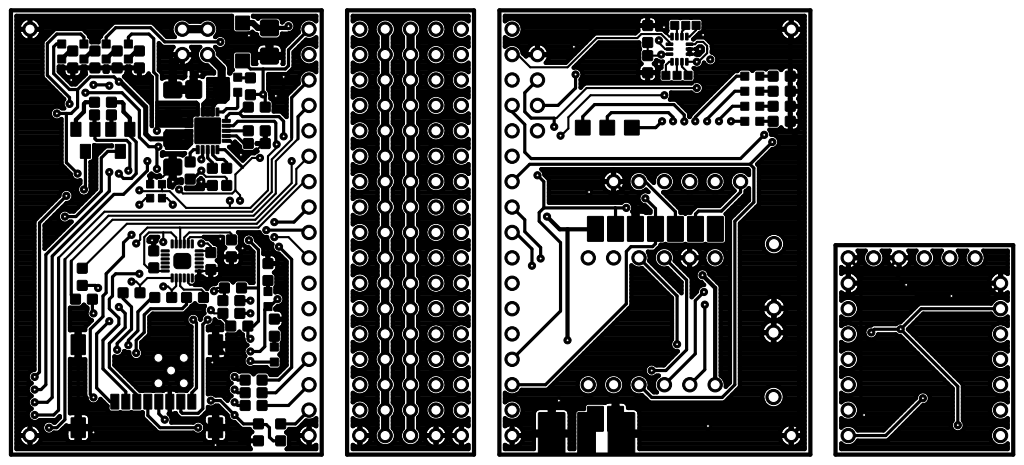
[picture p52: page 1]
