bsaid/SensorBoard/thesis/img/brdTop.pdf

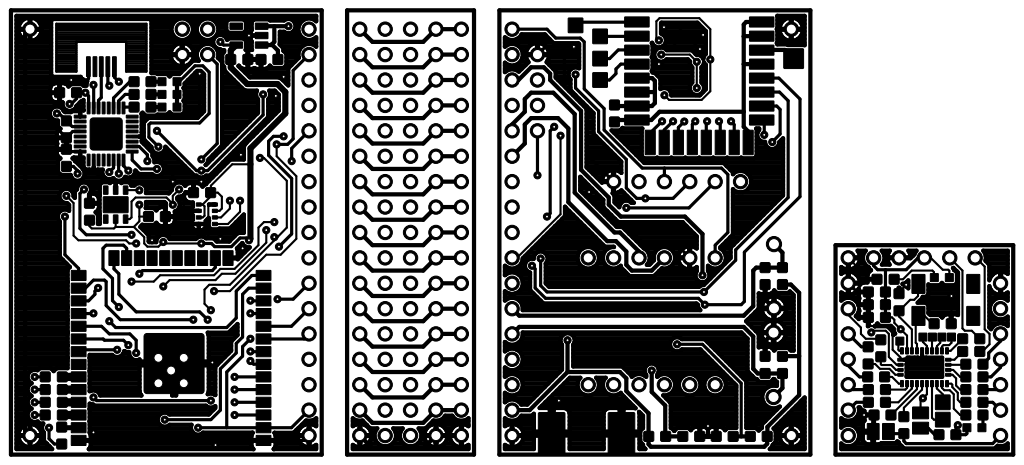
[picture p53: page 1]
