bsaid/SensorBoard/thesis/img/HWdesignProcess.pdf

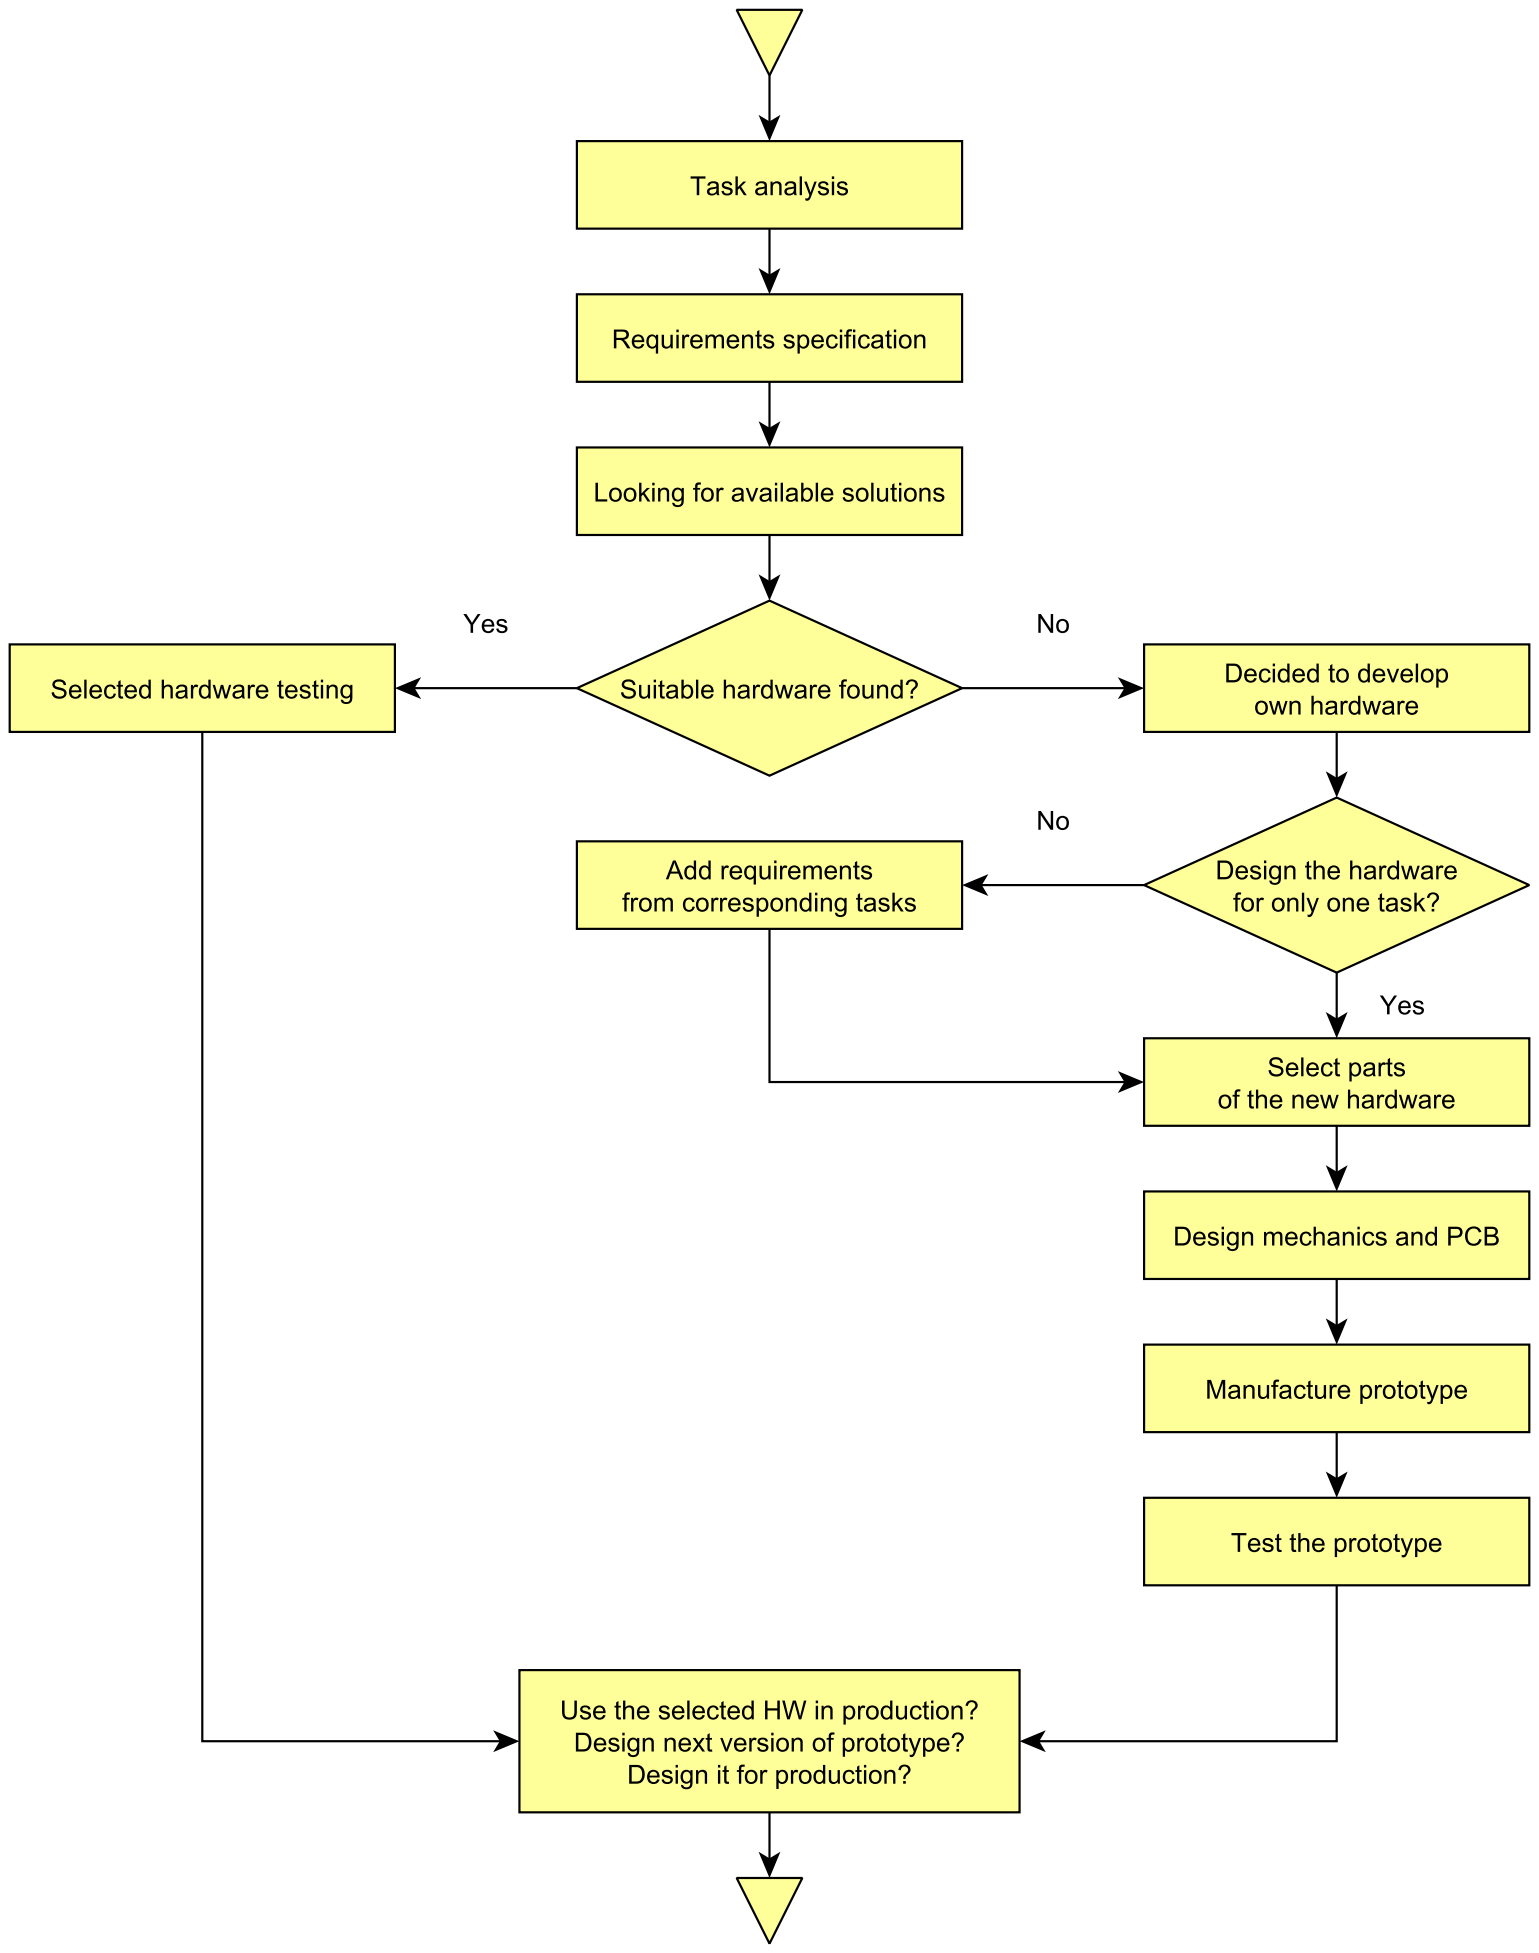
[picture p54: page 1]
