bsaid/SensorBoard/thesis/img/sch1.pdf

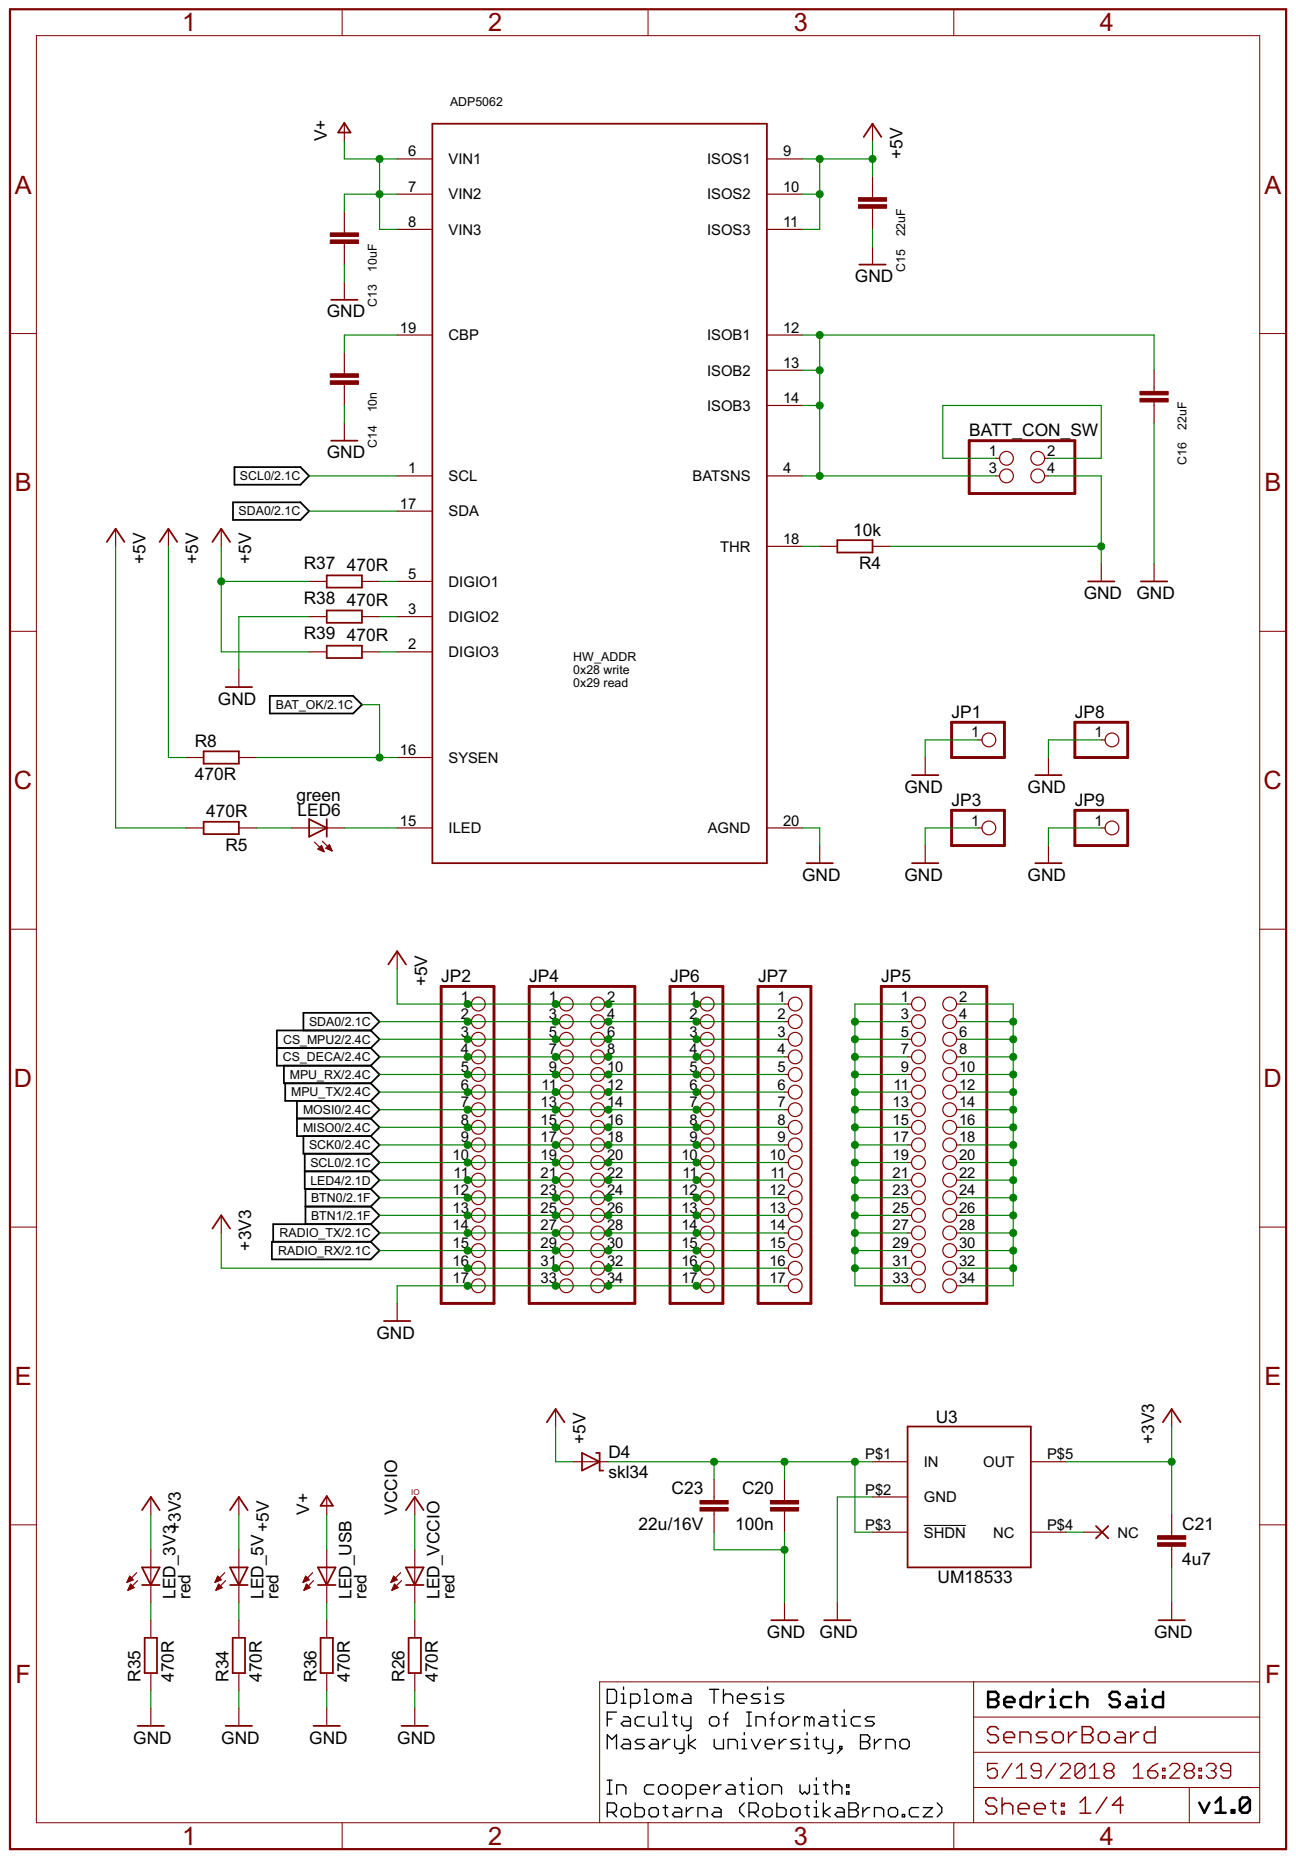
[picture p55: page 1]
