bsaid/SensorBoard/thesis/img/sch2.pdf

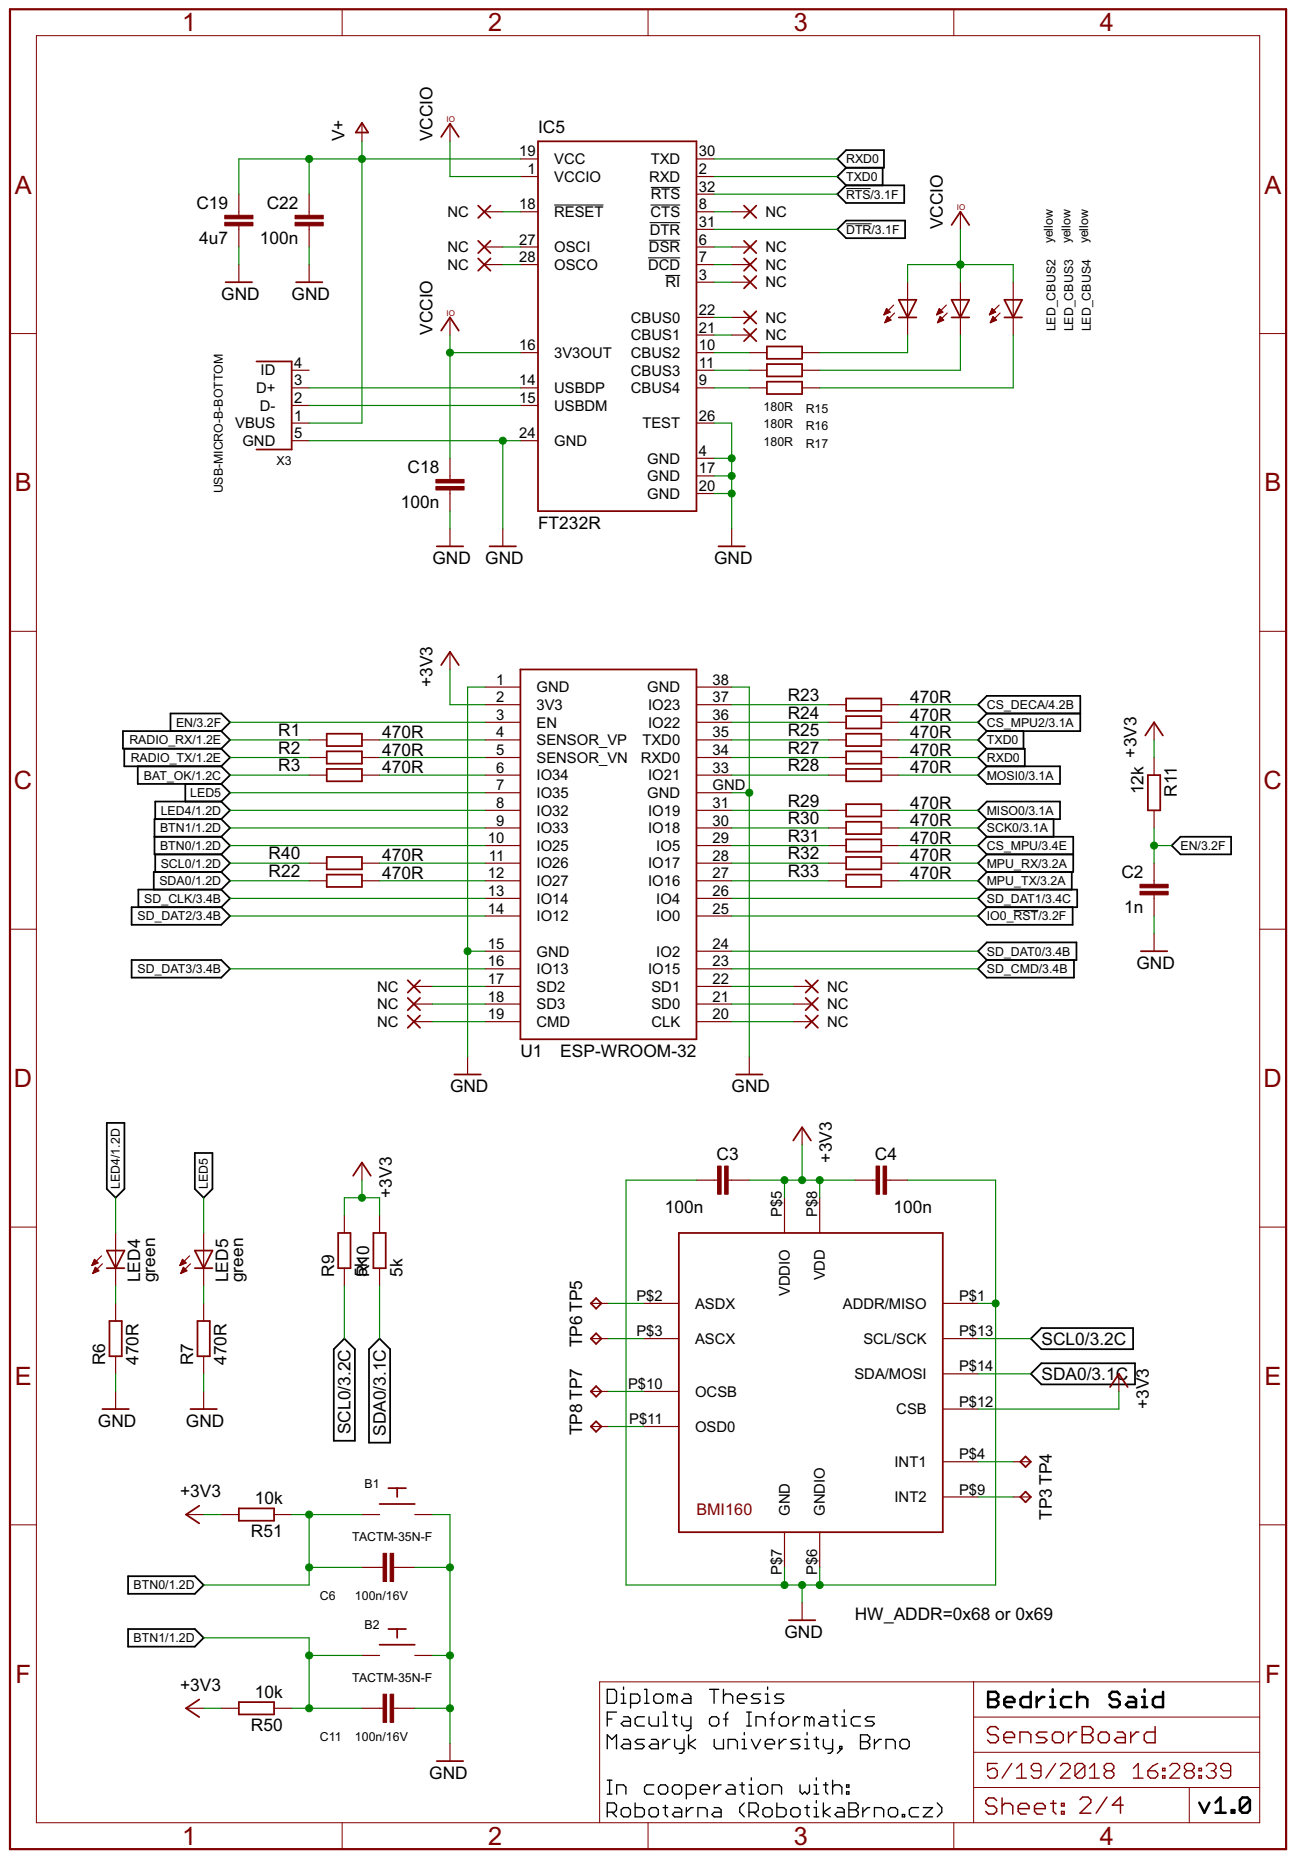
[picture p56: page 1]

12 | 27
13 14 15 | 26
