bsaid/SensorBoard/thesis/img/SensorBoardSchema.pdf

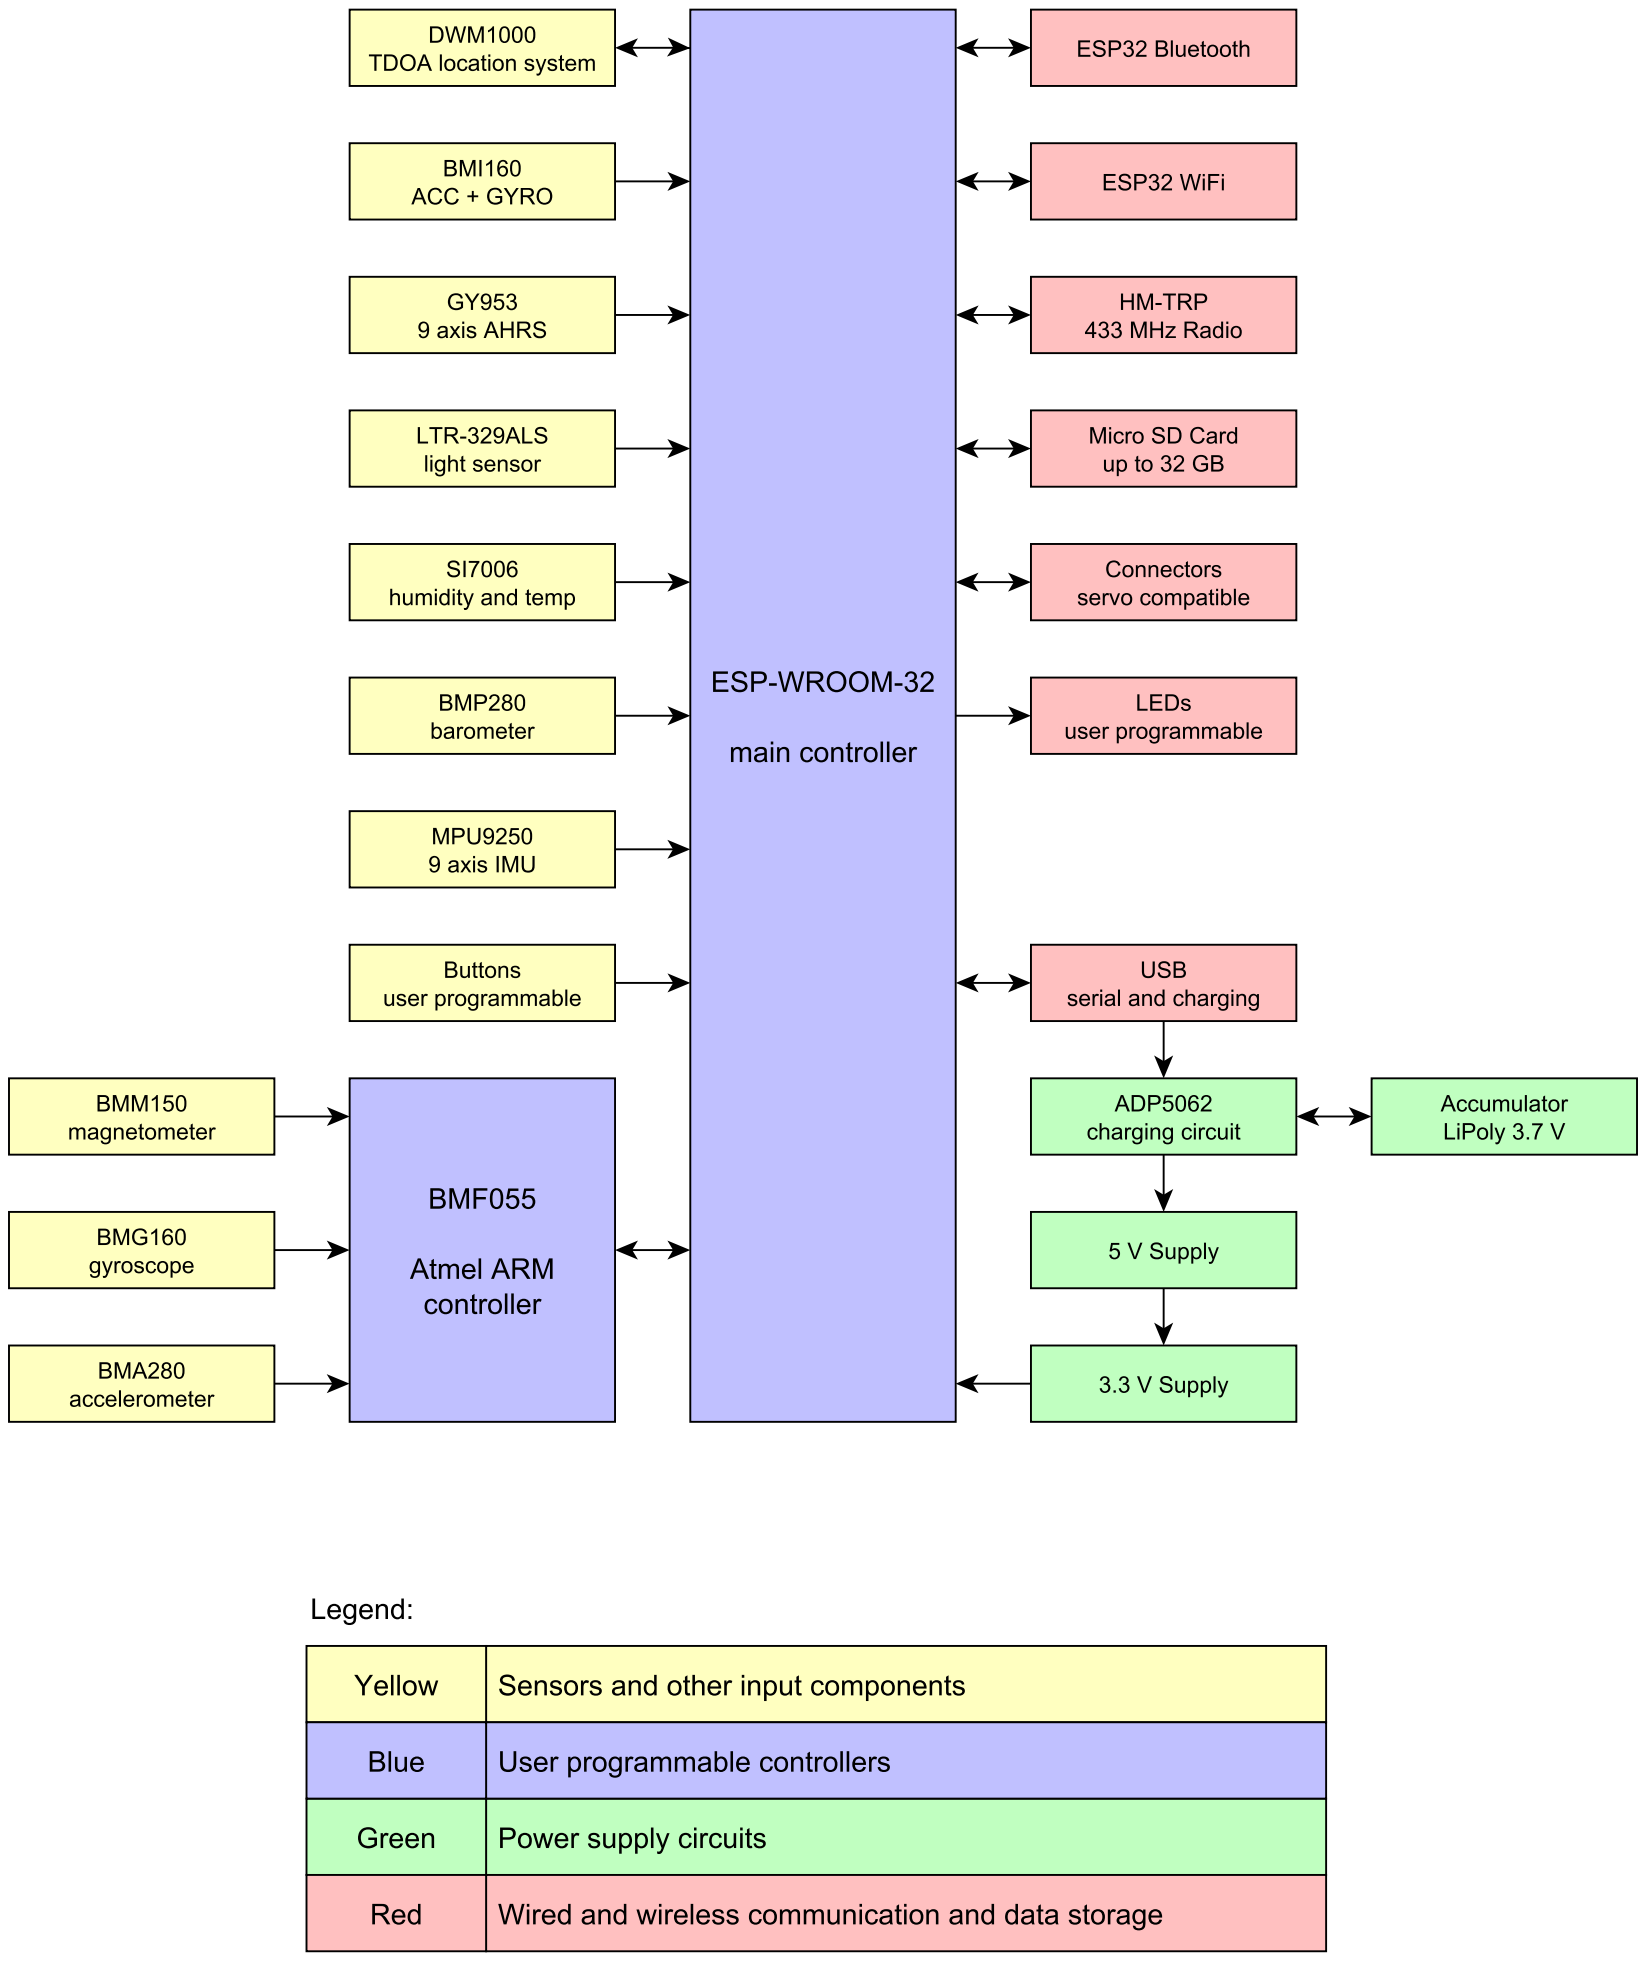
[picture p57: page 1]
