bsaid/SensorBoard/thesisCloneUIB/img/brdCBottom.pdf

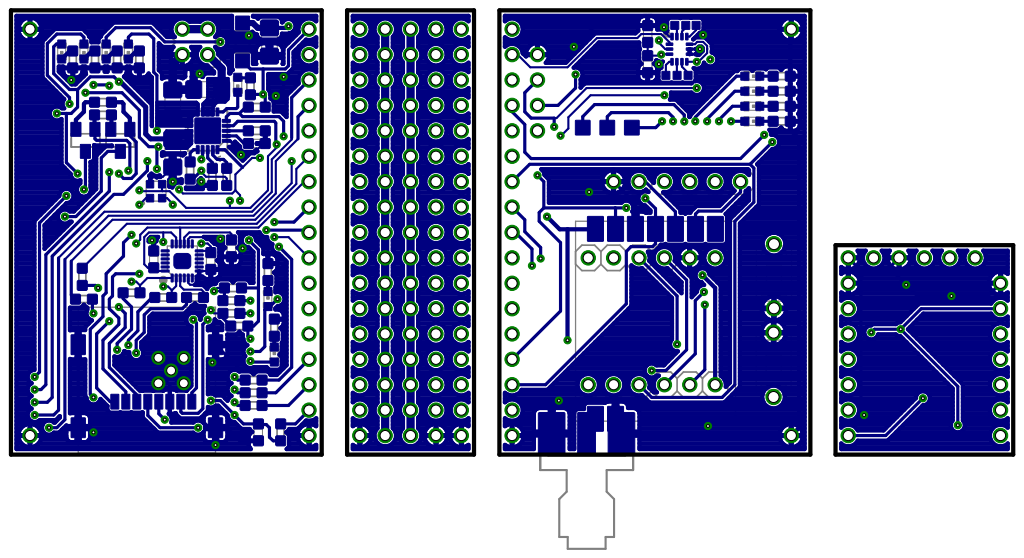
[picture p58: page 1]
