bsaid/SensorBoard/thesisCloneUIB/img/brdCTop.pdf

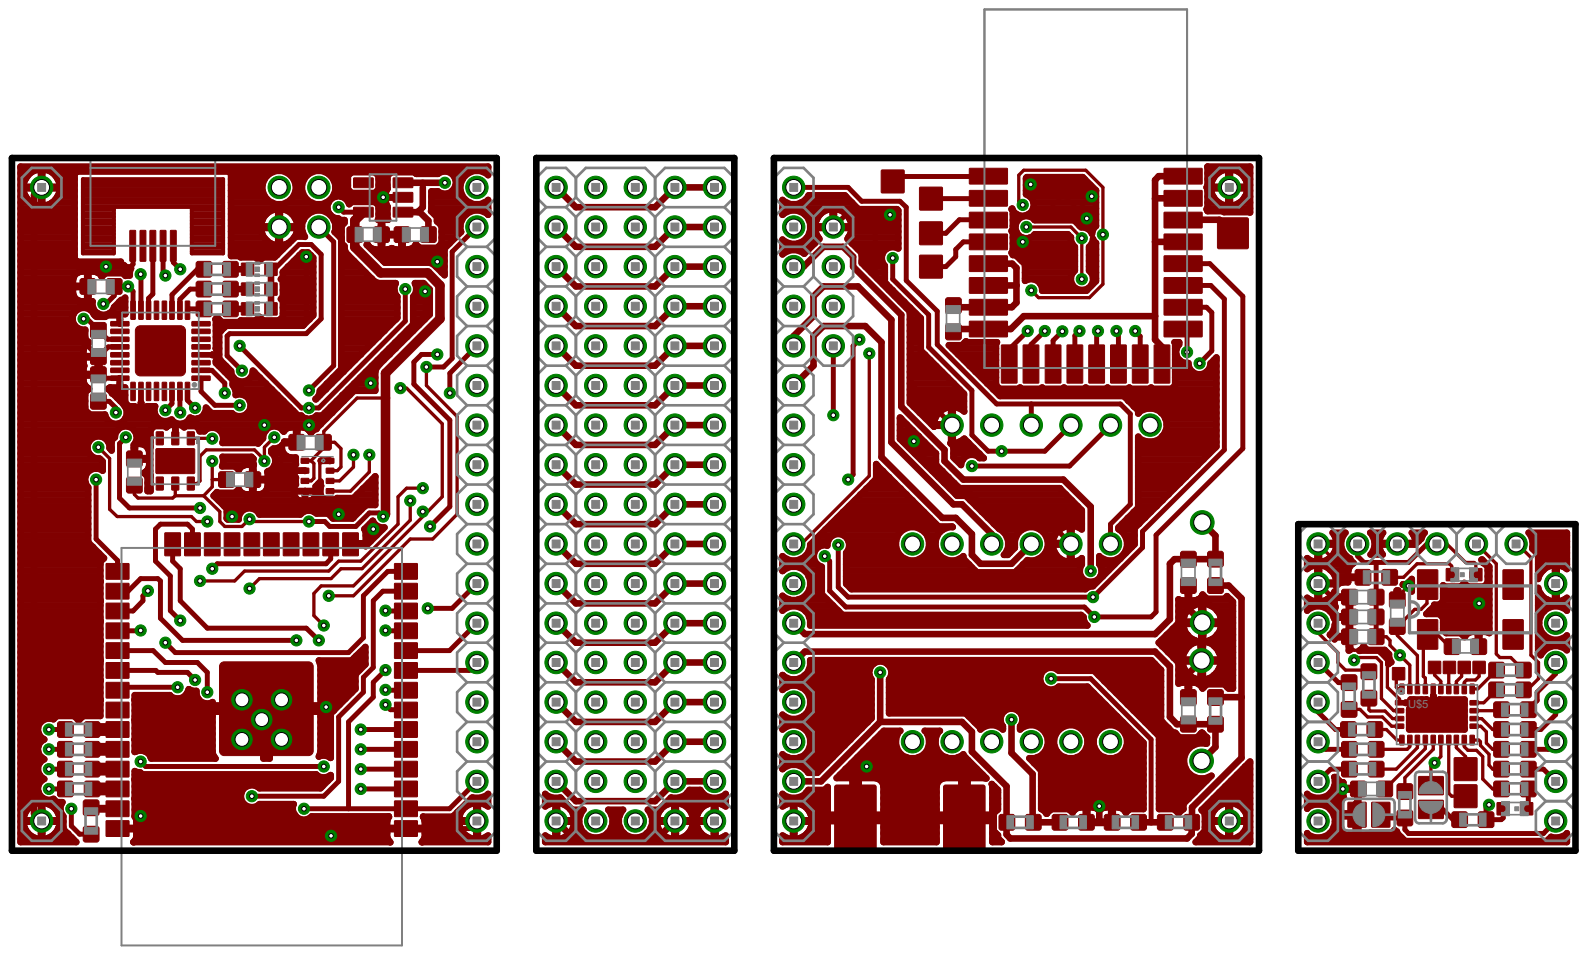
[picture p59: page 1]
