bsaid/SensorBoard/thesisCloneUIB/img/cval.pdf

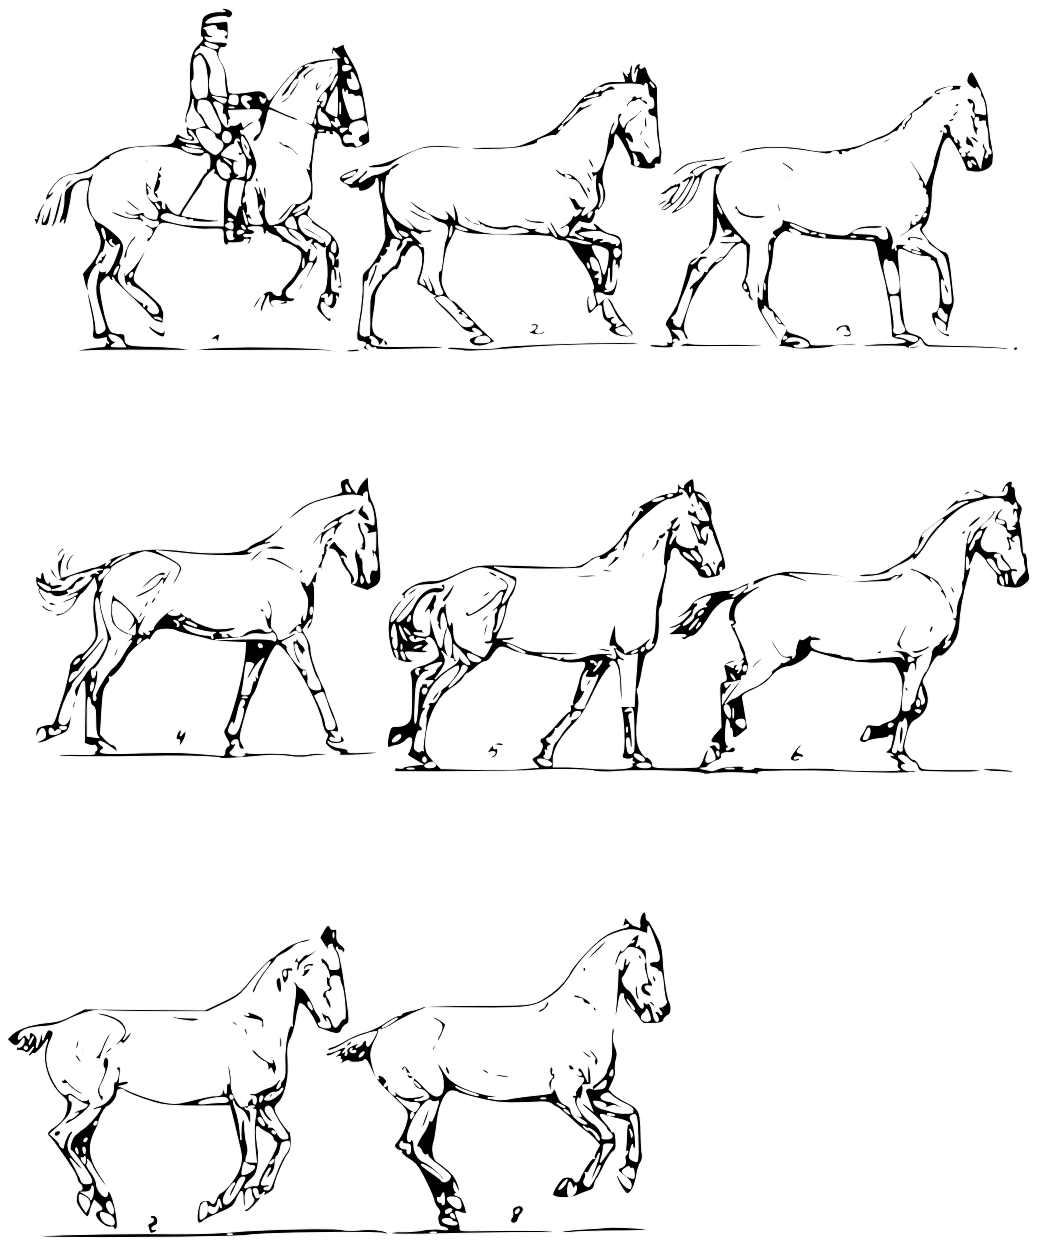
[picture p60: page 1]
