bsaid/SensorBoard/thesisCloneUIB/img/klus.pdf

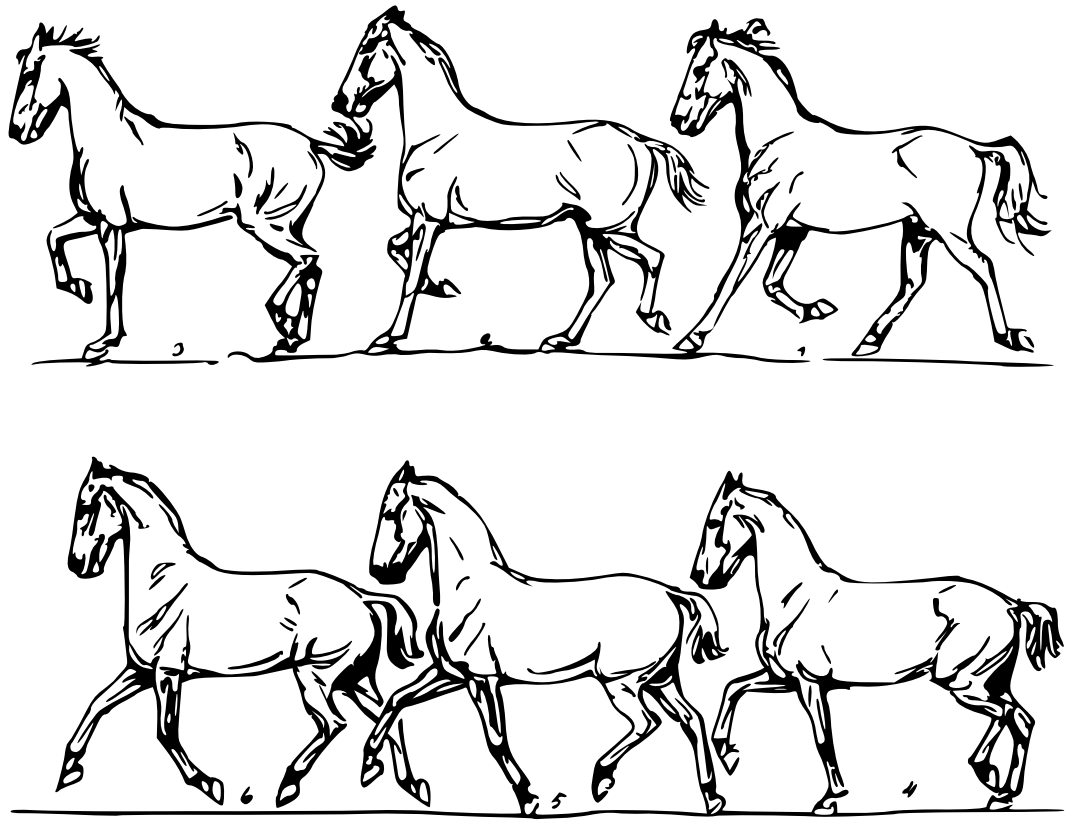
[picture p61: page 1]
