bsaid/SensorBoard/thesisCloneUIB/img/krok.pdf

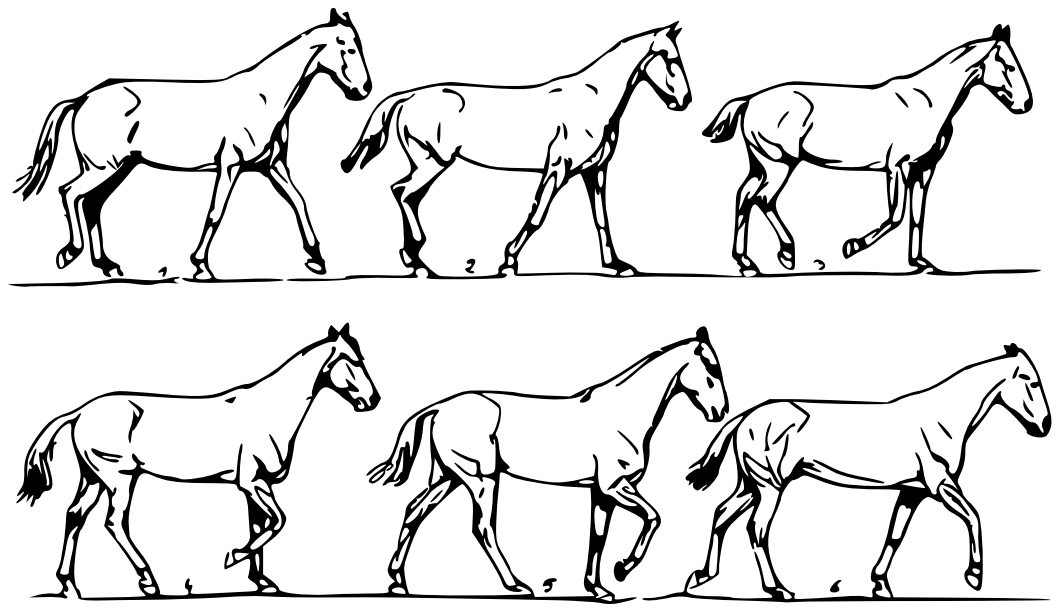
[picture p62: page 1]
