bsaid/SensorBoard/thesisCloneUIB/img/sch3.pdf

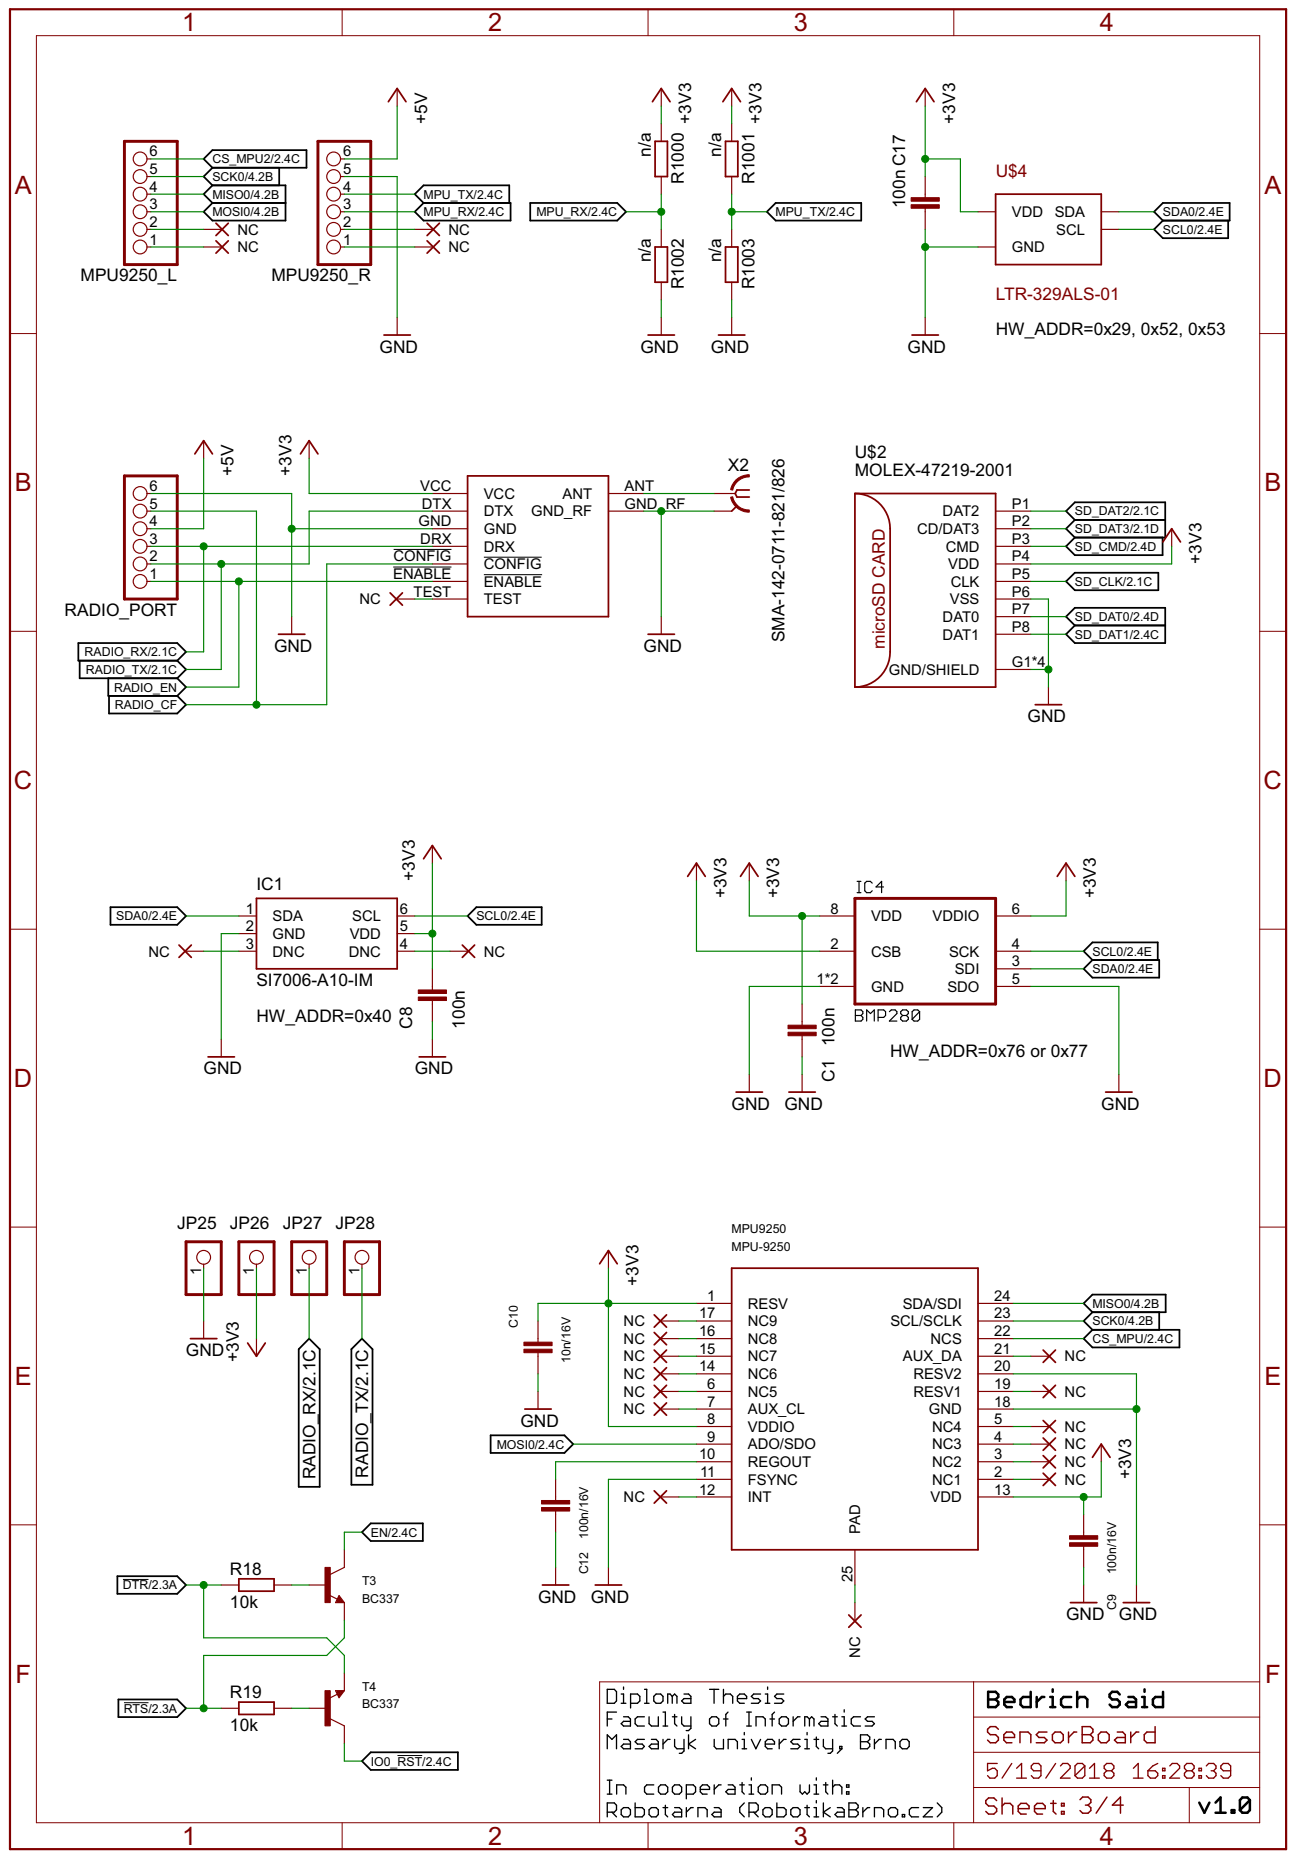
[picture p63: page 1]
