bsaid/SensorBoard/thesisCloneUIB/img/sch4.pdf

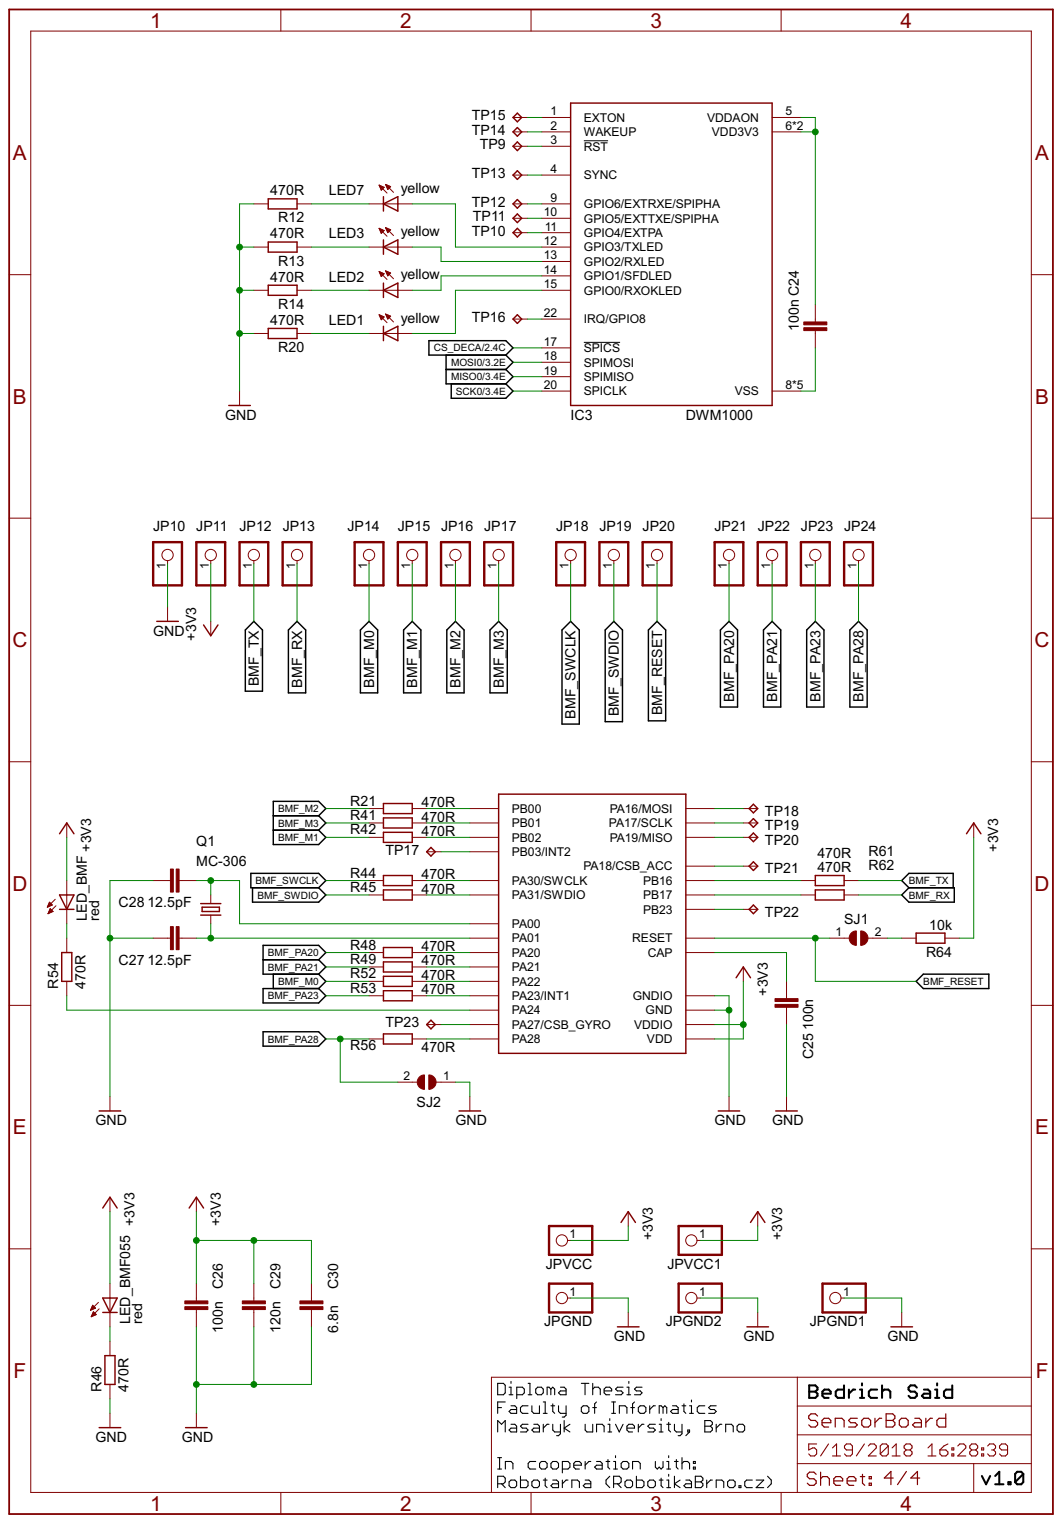
[picture p64: page 1]
