bsaid/SensorBoard/thesisCloneUIB/img/schB1.pdf

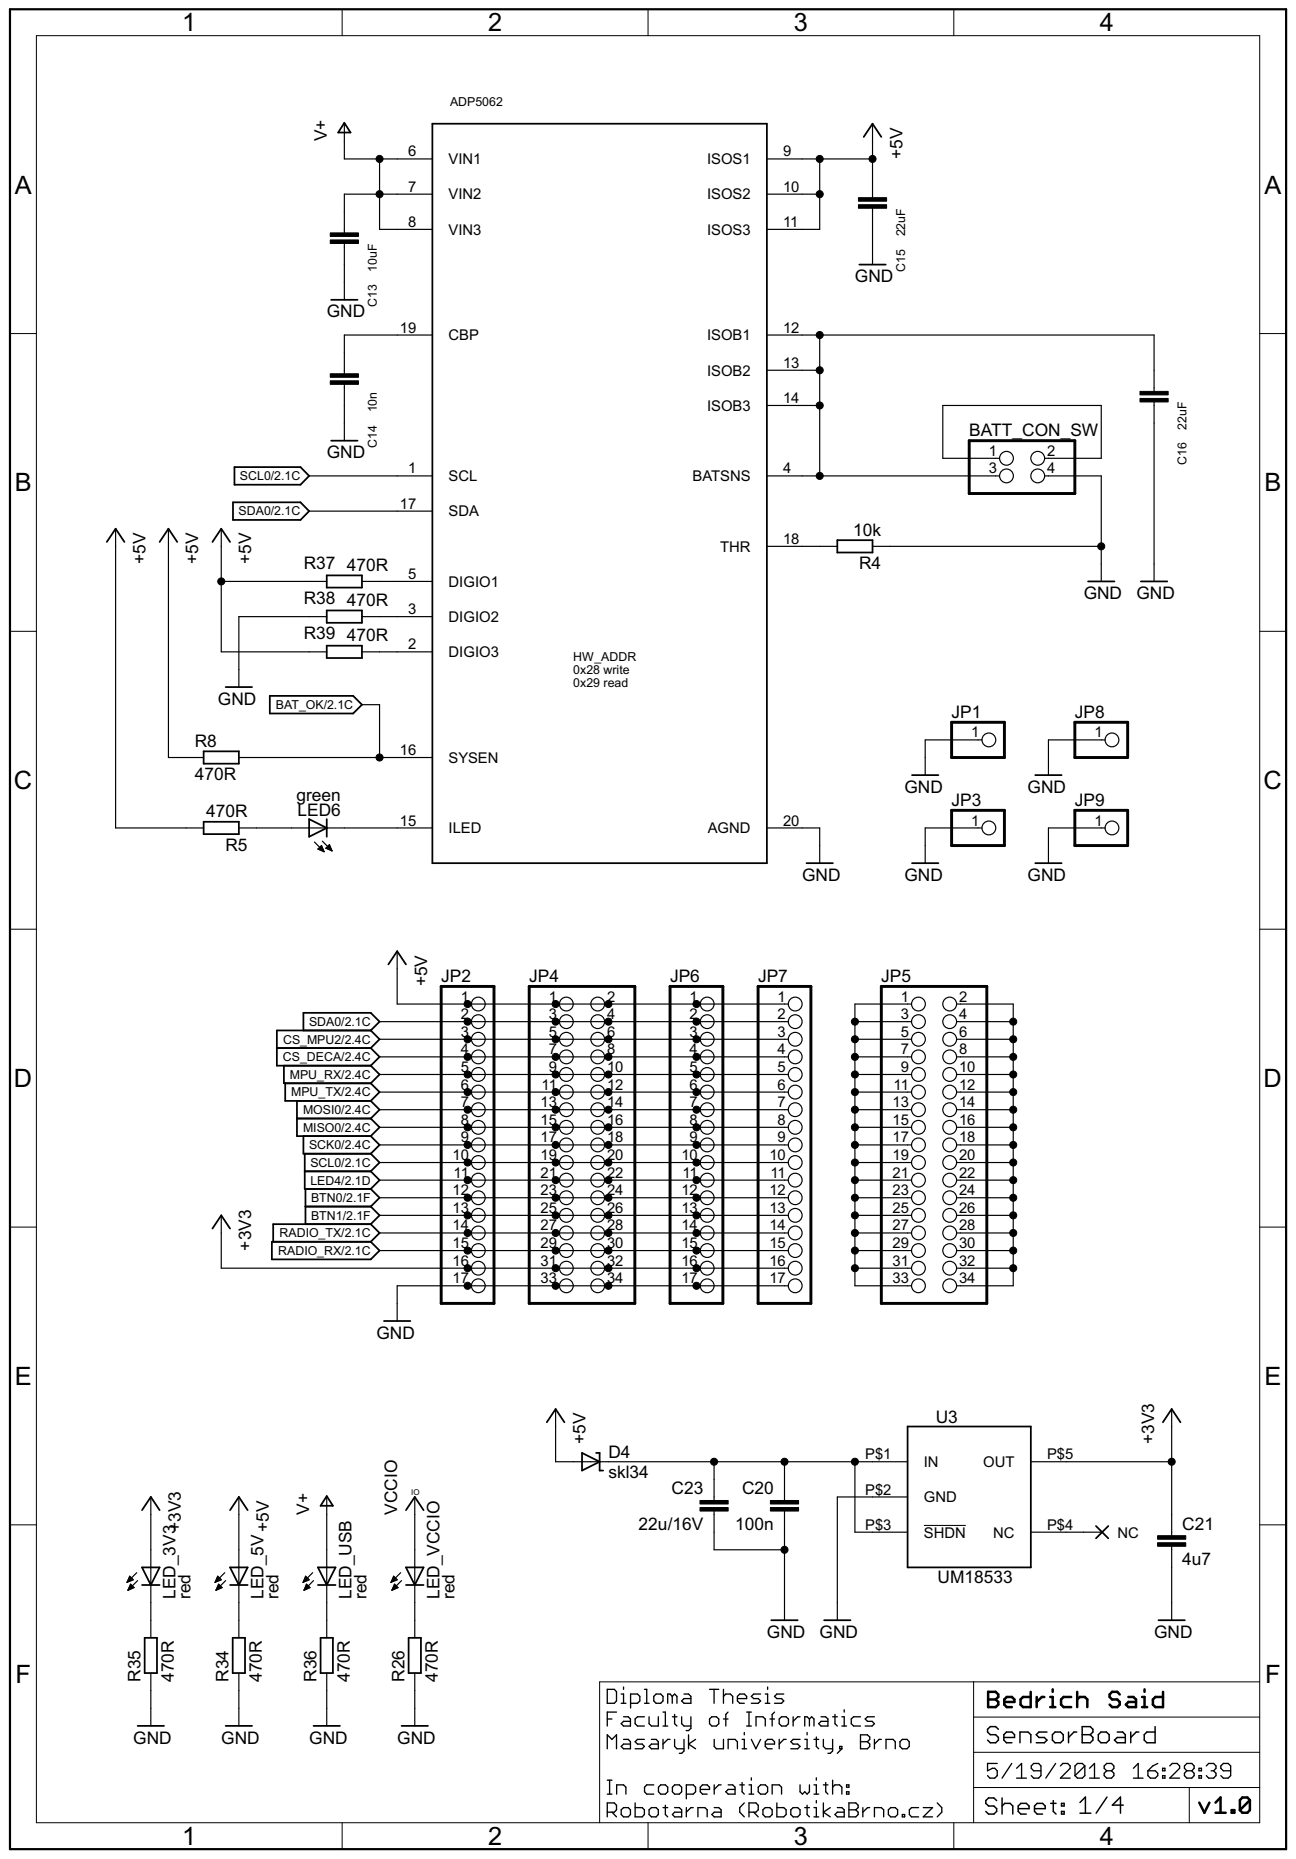
[picture p65: page 1]
