bsaid/SensorBoard/thesisCloneUIB/img/schB2.pdf

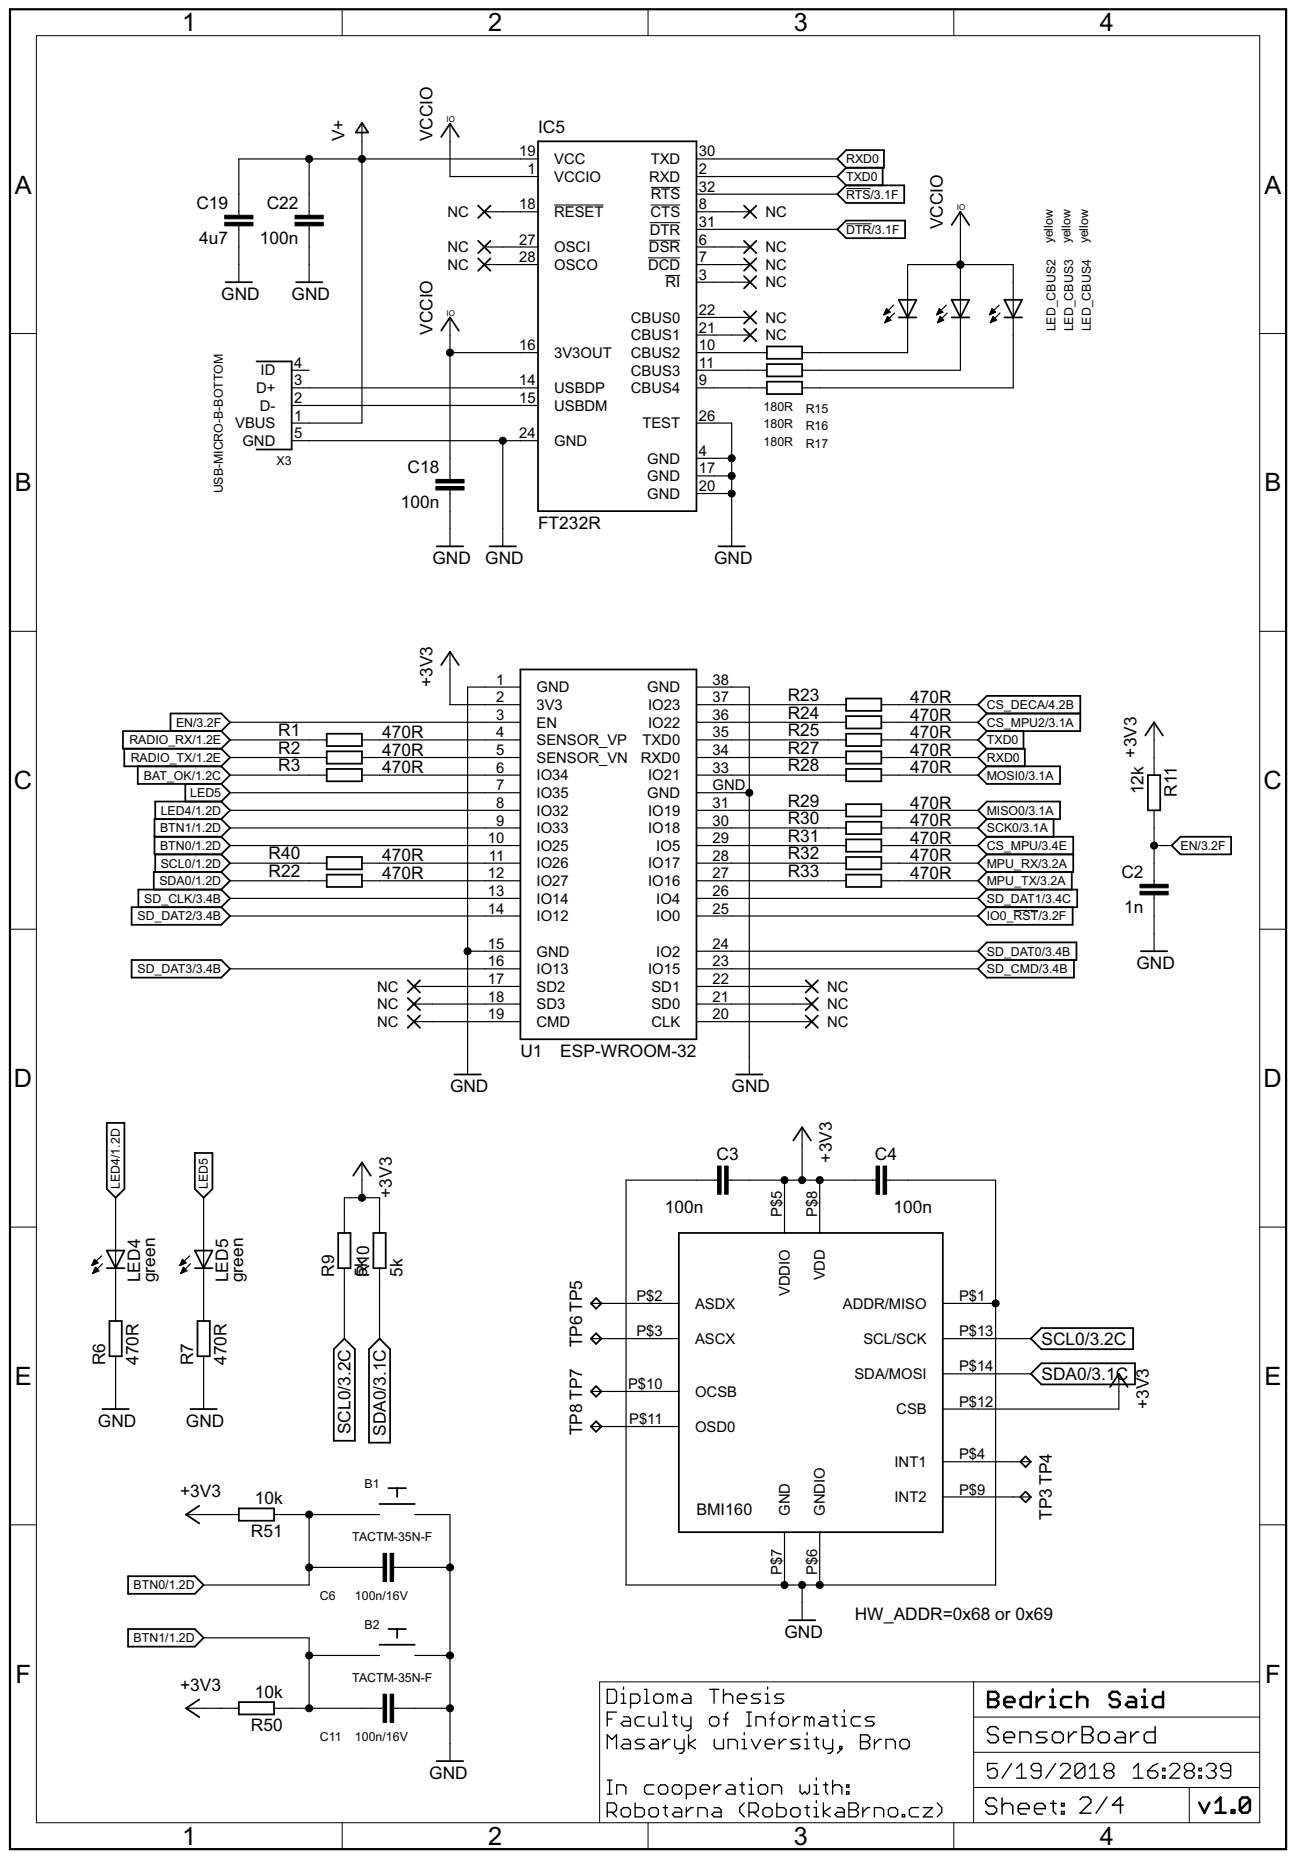
[picture p66: page 1]

12 | 27
13 14 15 | 26
