bsaid/SensorBoard/thesisCloneUIB/img/schB3.pdf

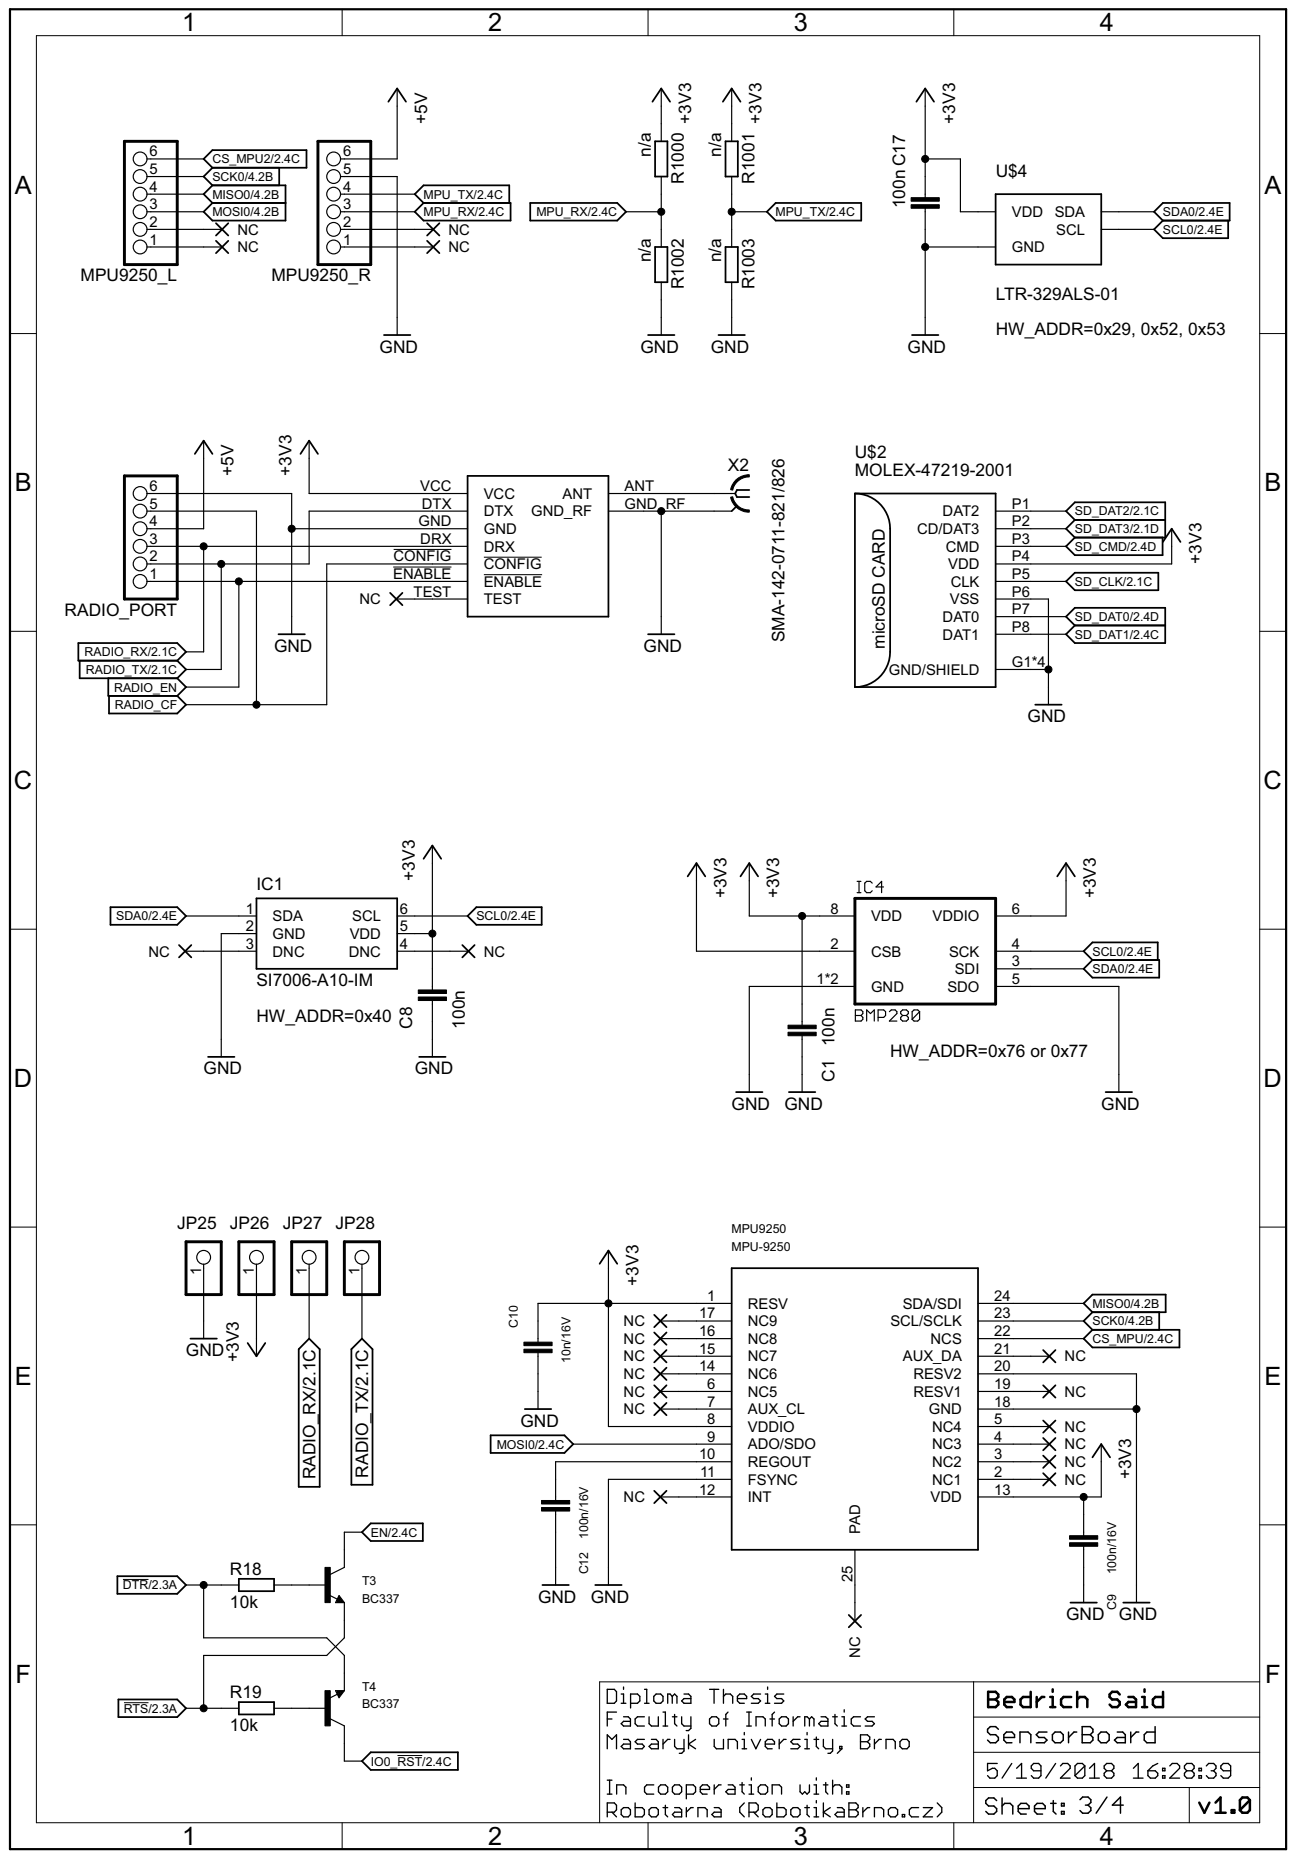
[picture p67: page 1]
