bsaid/SensorBoard/thesisCloneUIB/img/schB4.pdf

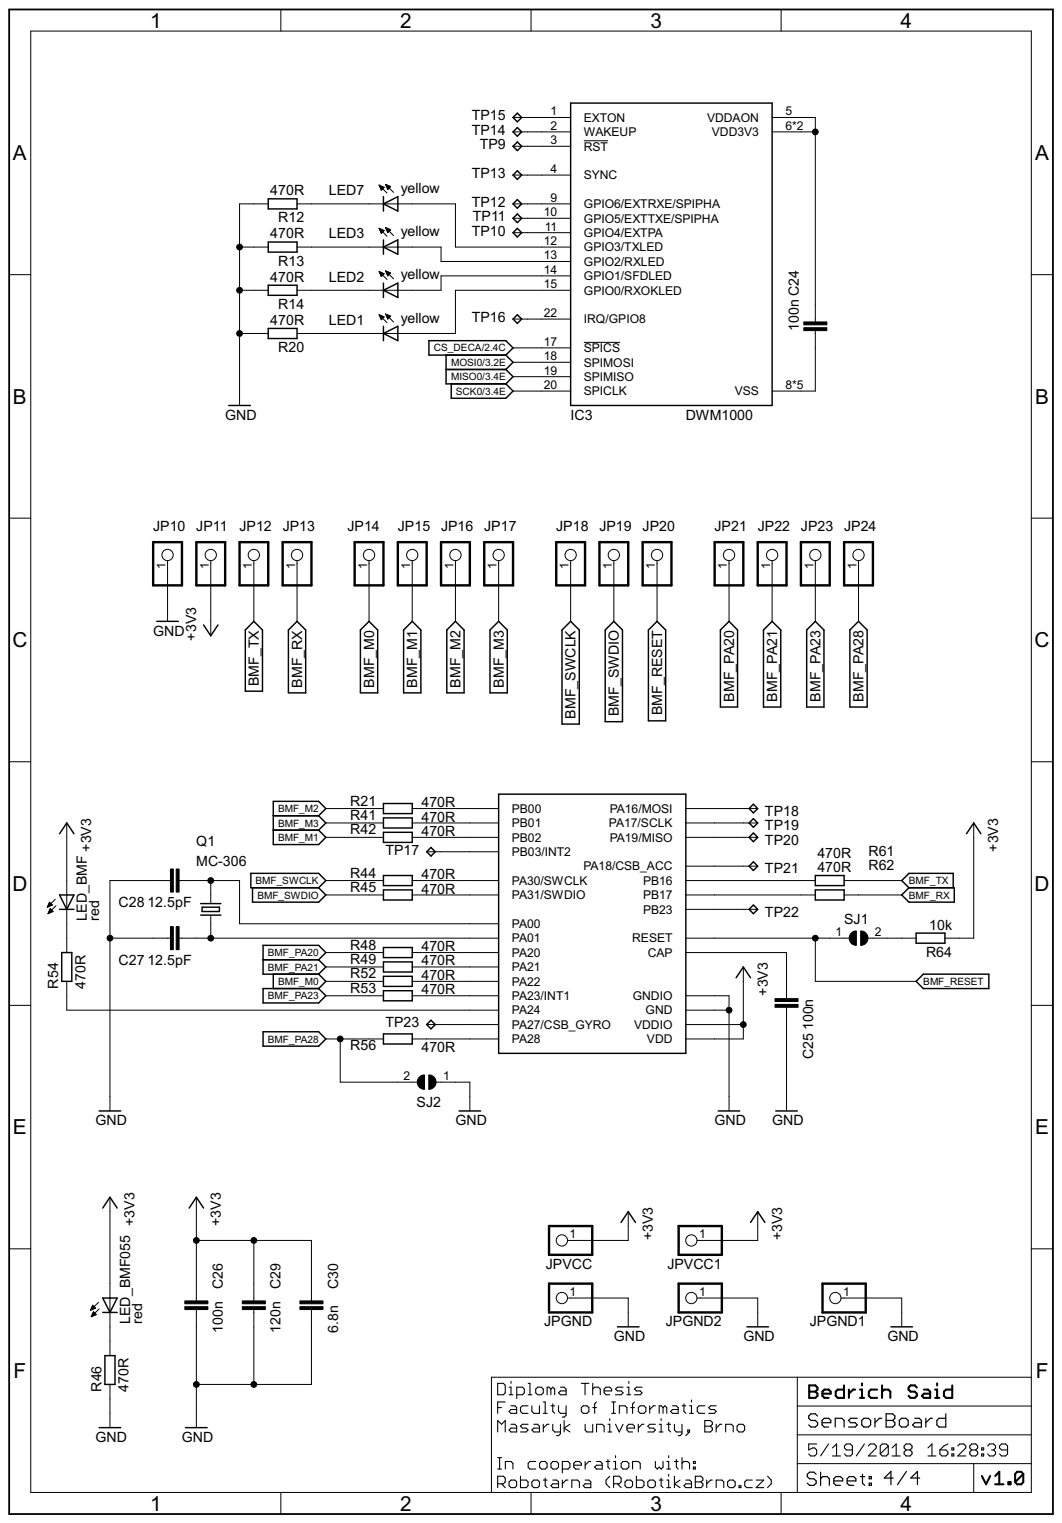
[picture p68: page 1]
