bsaid/SensorBoard/thesisCloneUIB/img/trysk.pdf

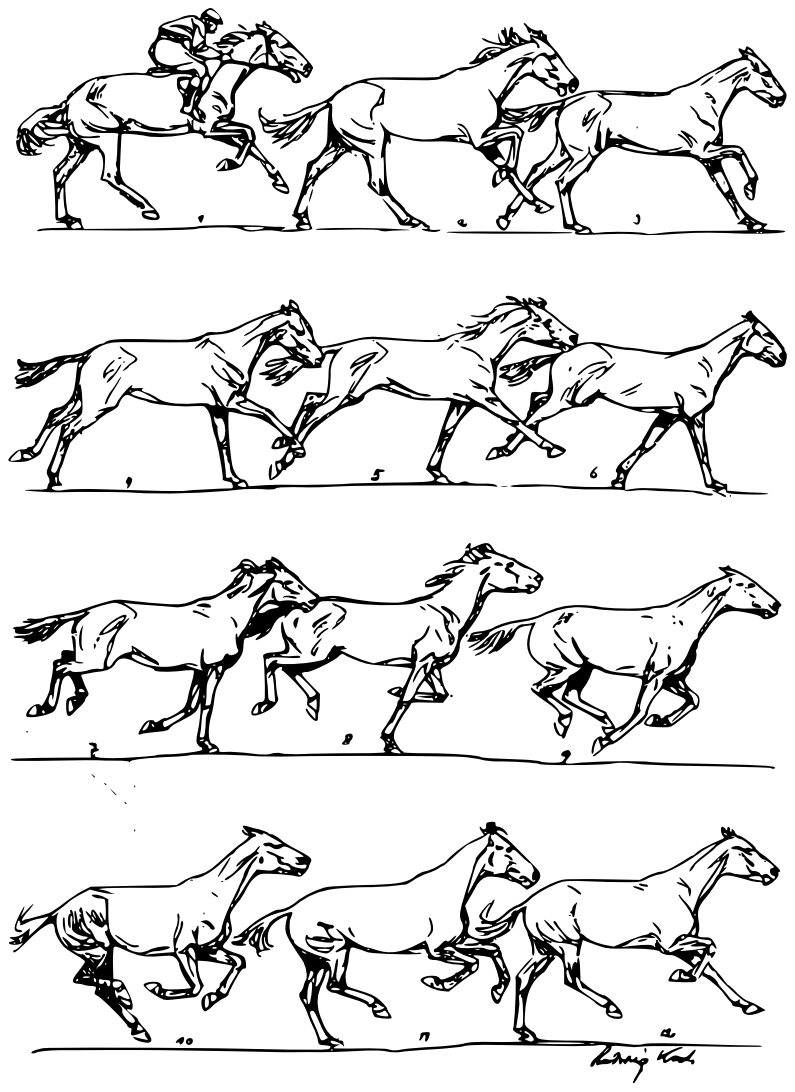
[picture p69: page 1]
