bsaid/SensorBoard/thesisCloneUIB/img/accToSound.pdf

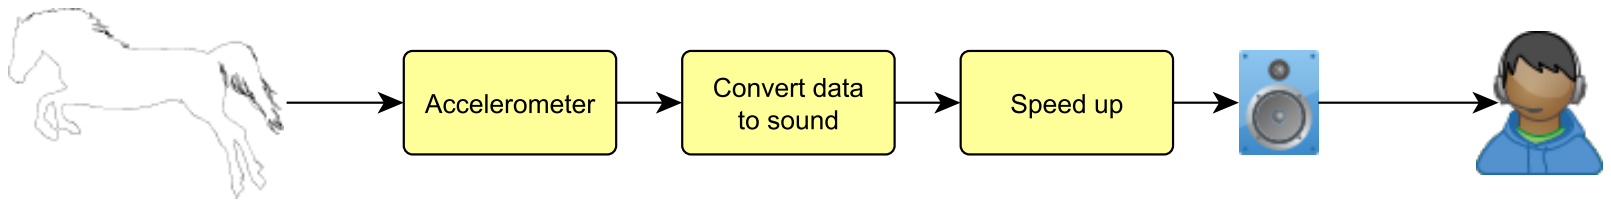
[picture p70: page 1]
