bsaid/SensorBoard/thesisCloneUIB/img/definitionTree.pdf

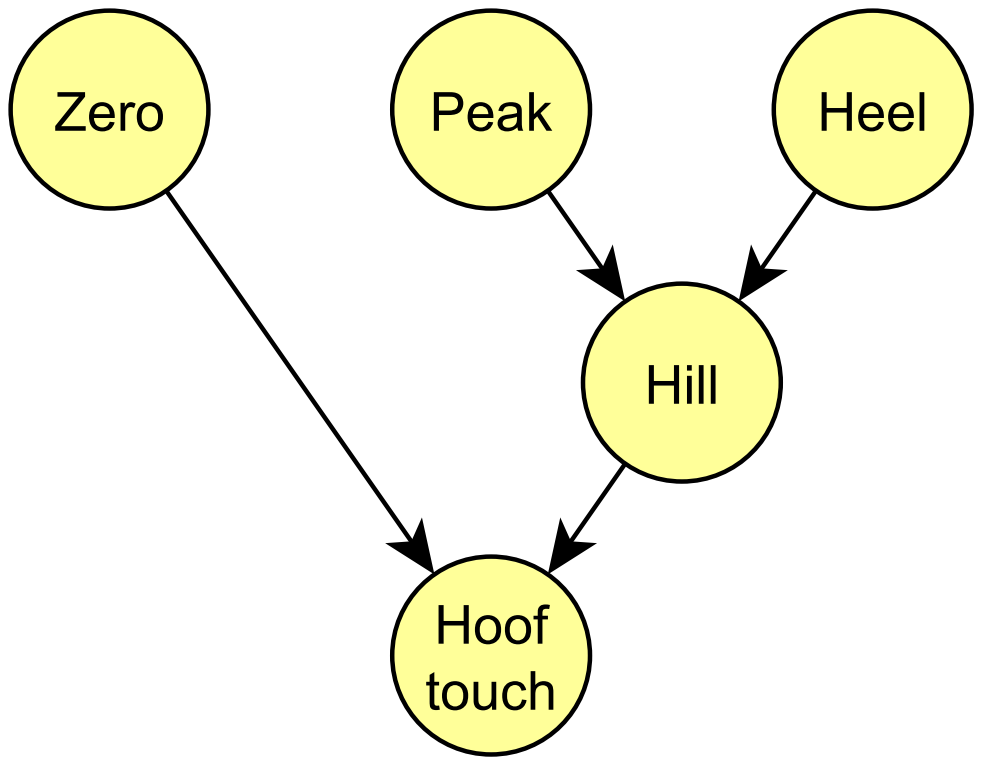
[picture p71: page 1]
