bsaid/SensorBoard/thesisCloneUIB/img/outputHorseAnalysis.pdf

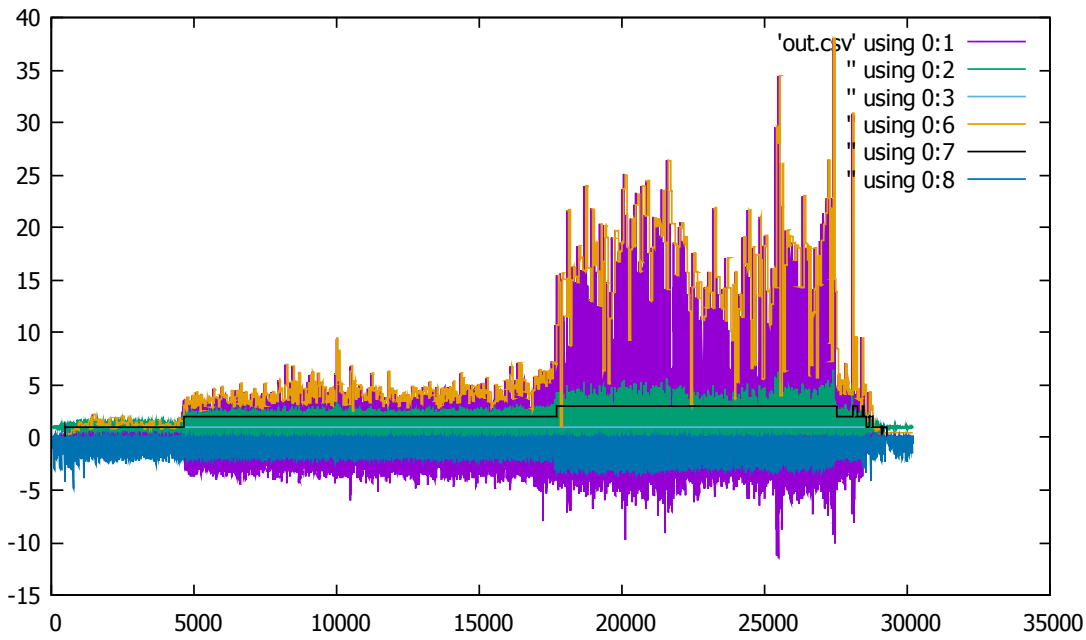
[picture p72: page 1]
'out.csv' using 0:1 '' using 0:2 '' using 0:3 '' using 0:6 '' using 0:7 '' using 0:8
