bsaid/SensorBoard/thesis/img/LEDmeanings.pdf

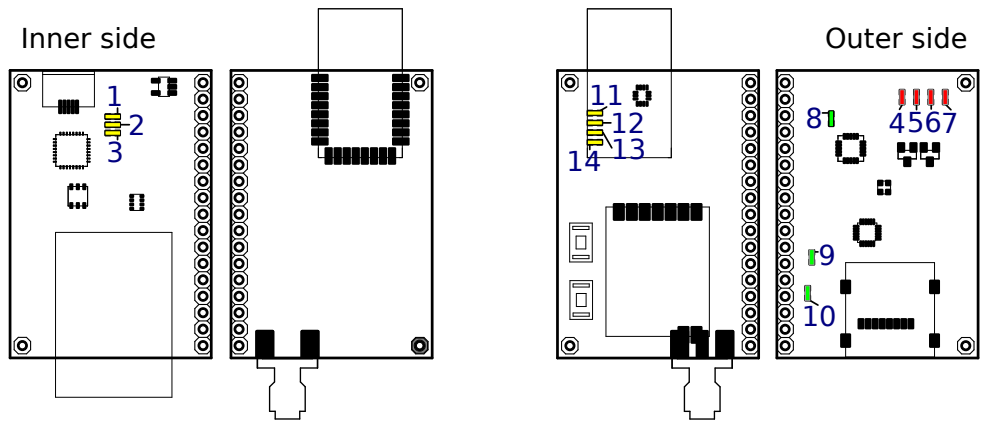
[picture p73: page 1]
Inner side; Outer side
