bsaid/SensorBoard/thesisCloneUIB/img/BATTconnector.pdf

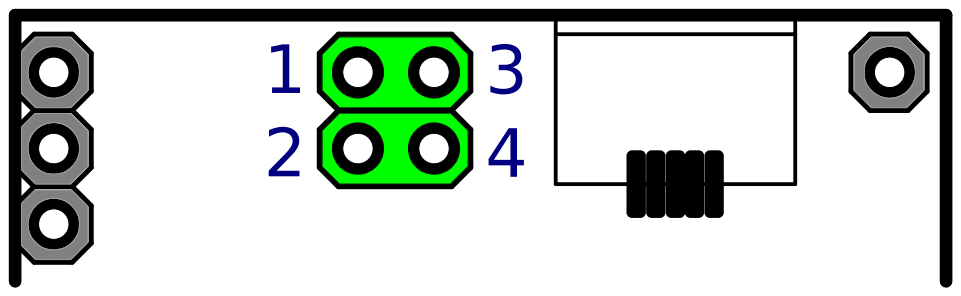
[picture p74: page 1]
