bsaid/SensorBoard/thesisCloneUIB/img/BMF055pinout.pdf

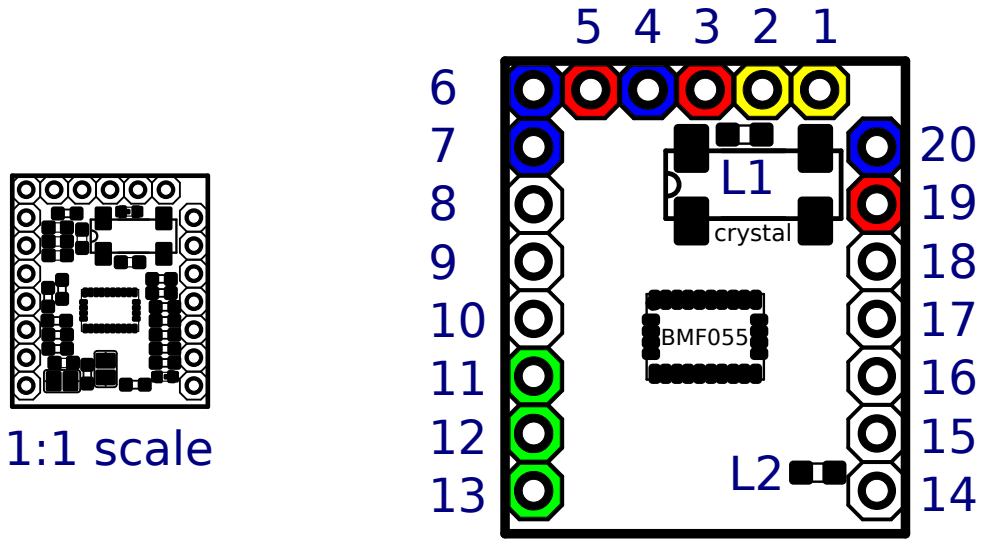
[picture p75: page 1]
1:1 scale; BMF055; crystal
