bsaid/SensorBoard/thesisCloneUIB/img/BMFconnector.pdf

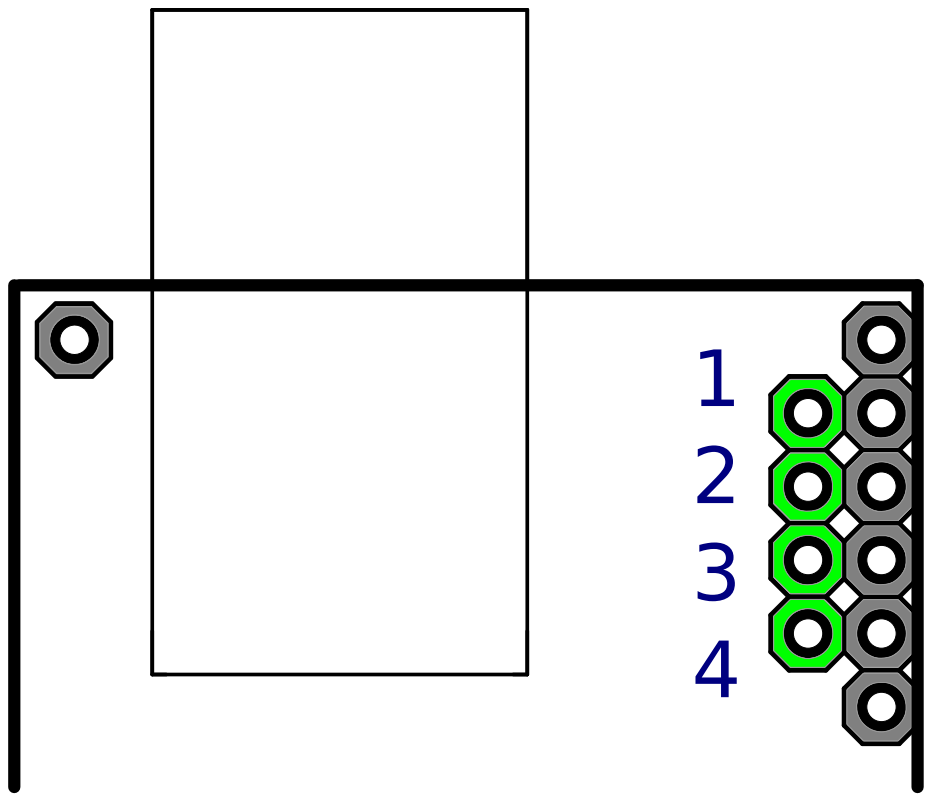
[picture p76: page 1]
