bsaid/SensorBoard/thesisCloneUIB/img/GY953connector.pdf

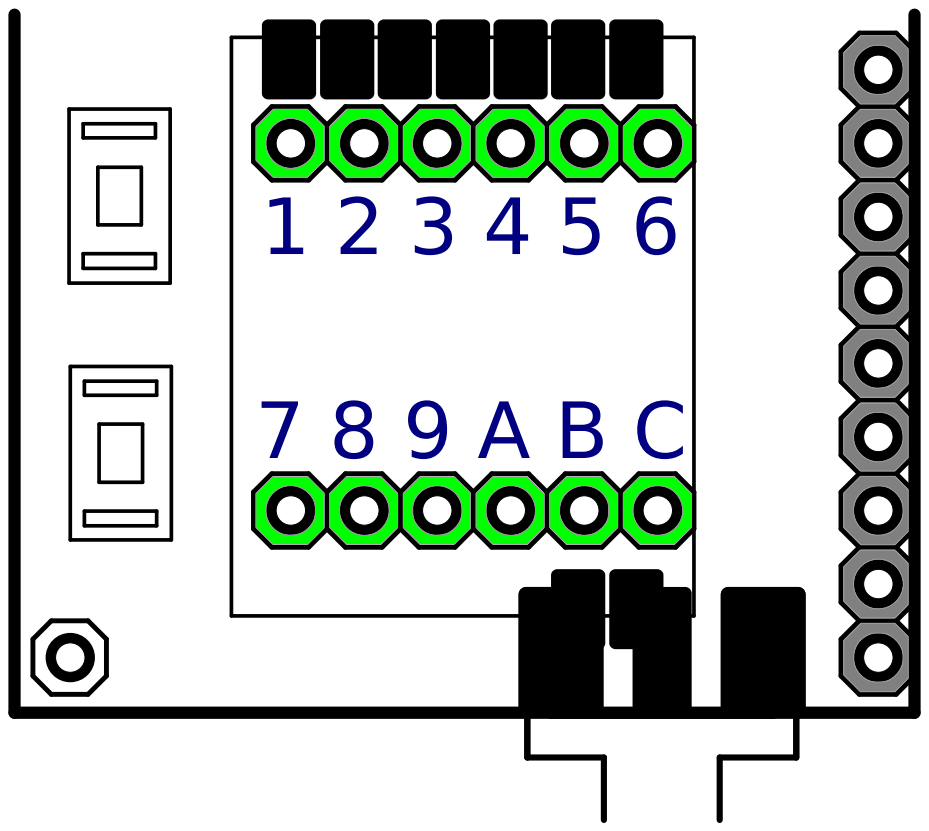
[picture p77: page 1]
