bsaid/SensorBoard/thesisCloneUIB/img/HMTRPconnector.pdf

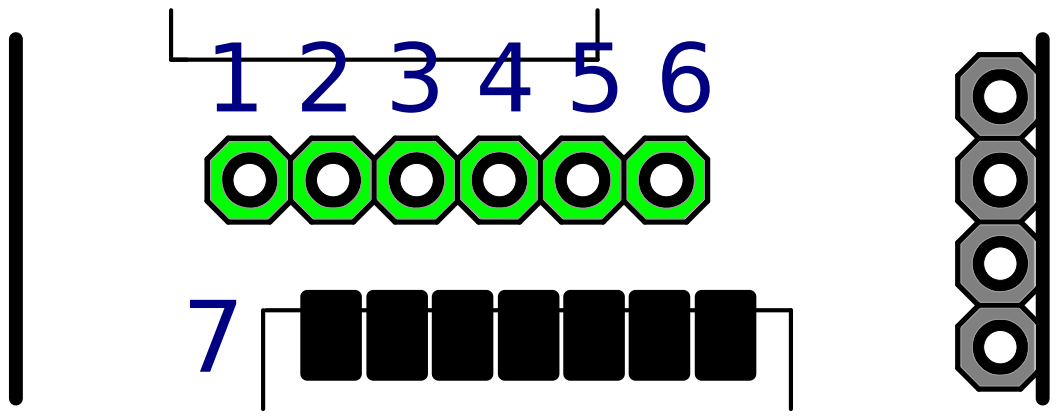
[picture p78: page 1]
