bsaid/SensorBoard/thesisCloneUIB/img/SchBoot.pdf

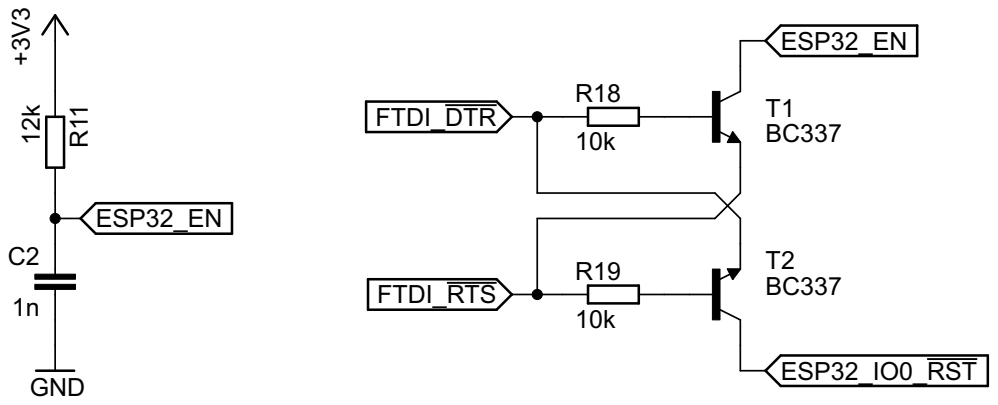
[picture p79: page 1]
