bsaid/SensorBoard/thesisCloneUIB/img/SchButtons.pdf

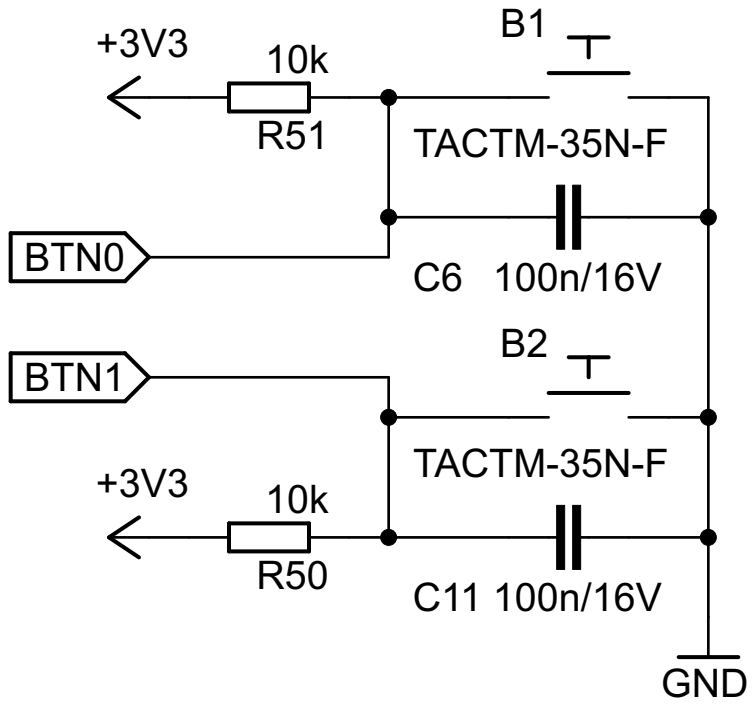
[picture p80: page 1]
