bsaid/SensorBoard/thesisCloneUIB/img/SchPinout.pdf

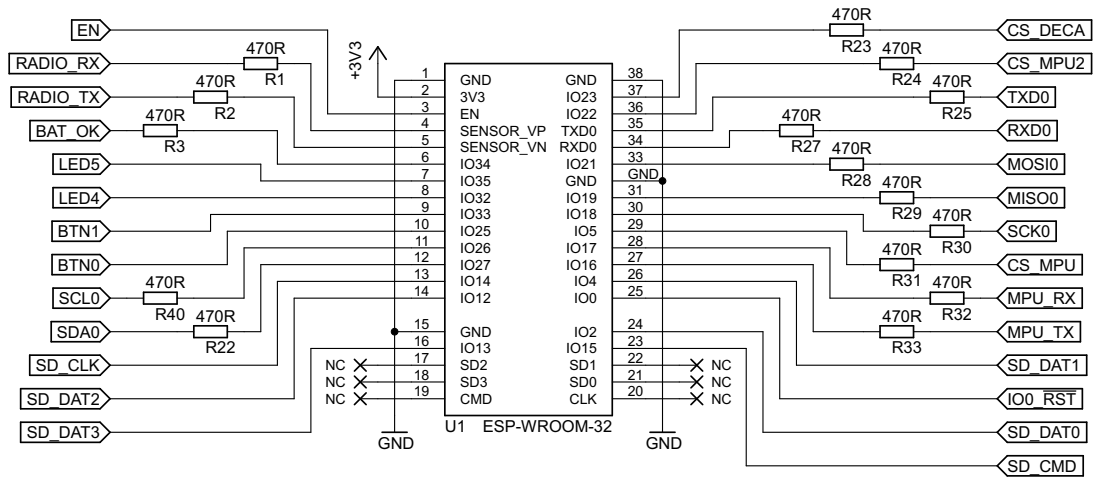
[picture p81: page 1]
