bsaid/SensorBoard/thesisCloneUIB/img/SensorBoardDrawing.pdf

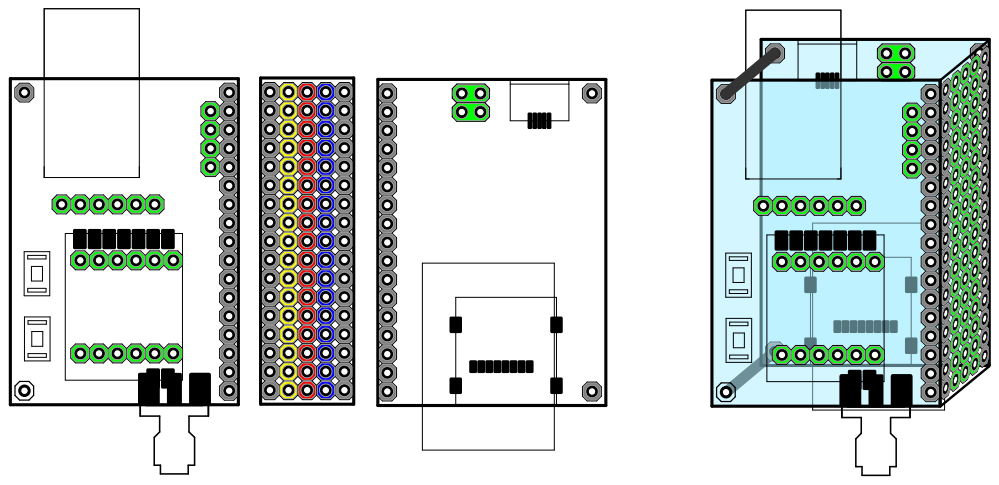
[picture p82: page 1]
