bsaid/SensorBoard/thesis/img/firmwareStateMachine.pdf

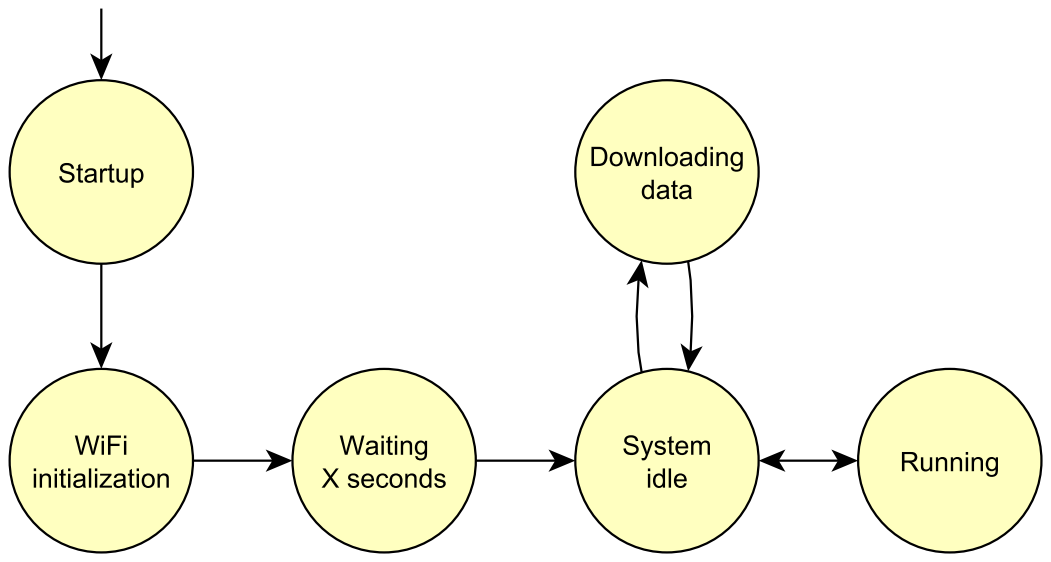
[picture p83: page 1]
