bsaid/SensorBoard/thesisCloneUIB/img/HWdimensions.pdf

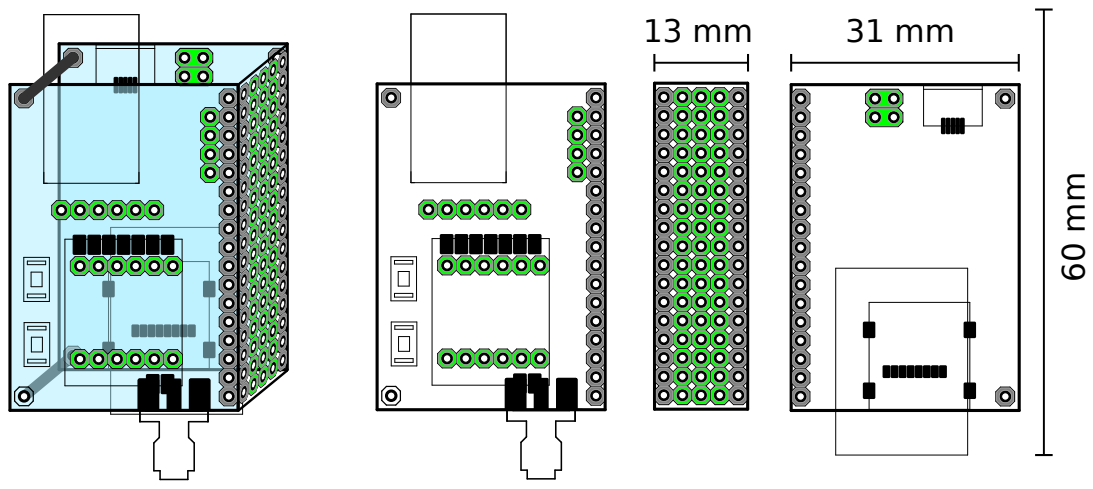
[picture p84: page 1]
