bsaid/SensorBoard/thesisCloneUIB/img/UsageExamplesAHRS.pdf

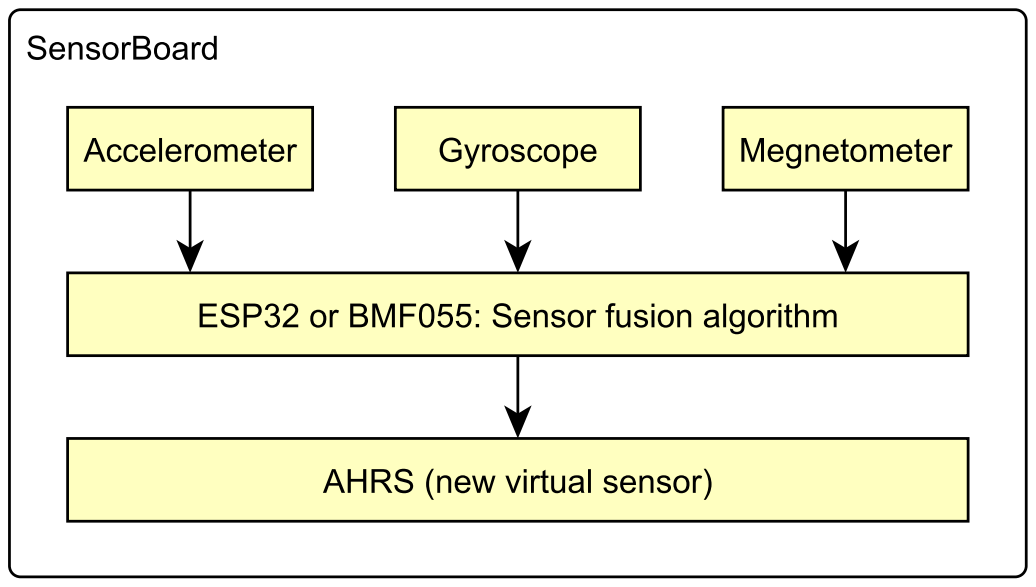
[picture p85: page 1]
