bsaid/SensorBoard/thesisCloneUIB/img/UsageExamplesAHRSBMF.pdf

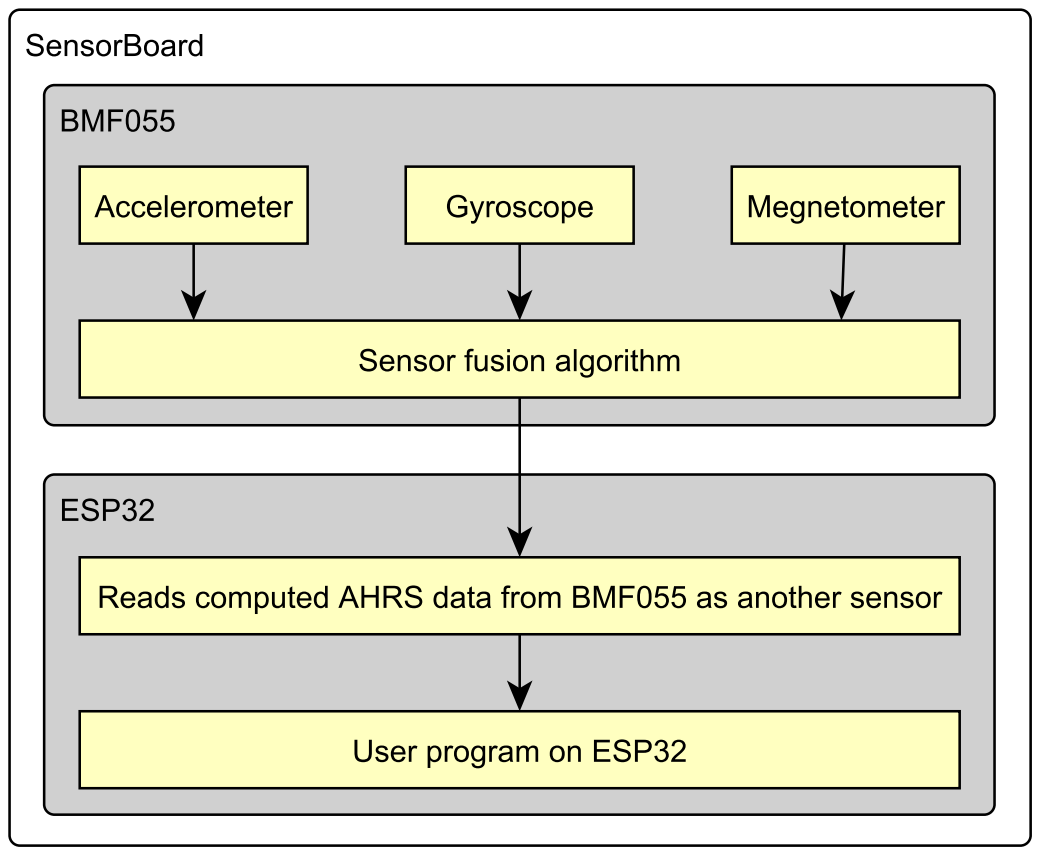
[picture p86: page 1]
