bsaid/SensorBoard/thesisCloneUIB/img/UsageExamplesFlightController.pdf

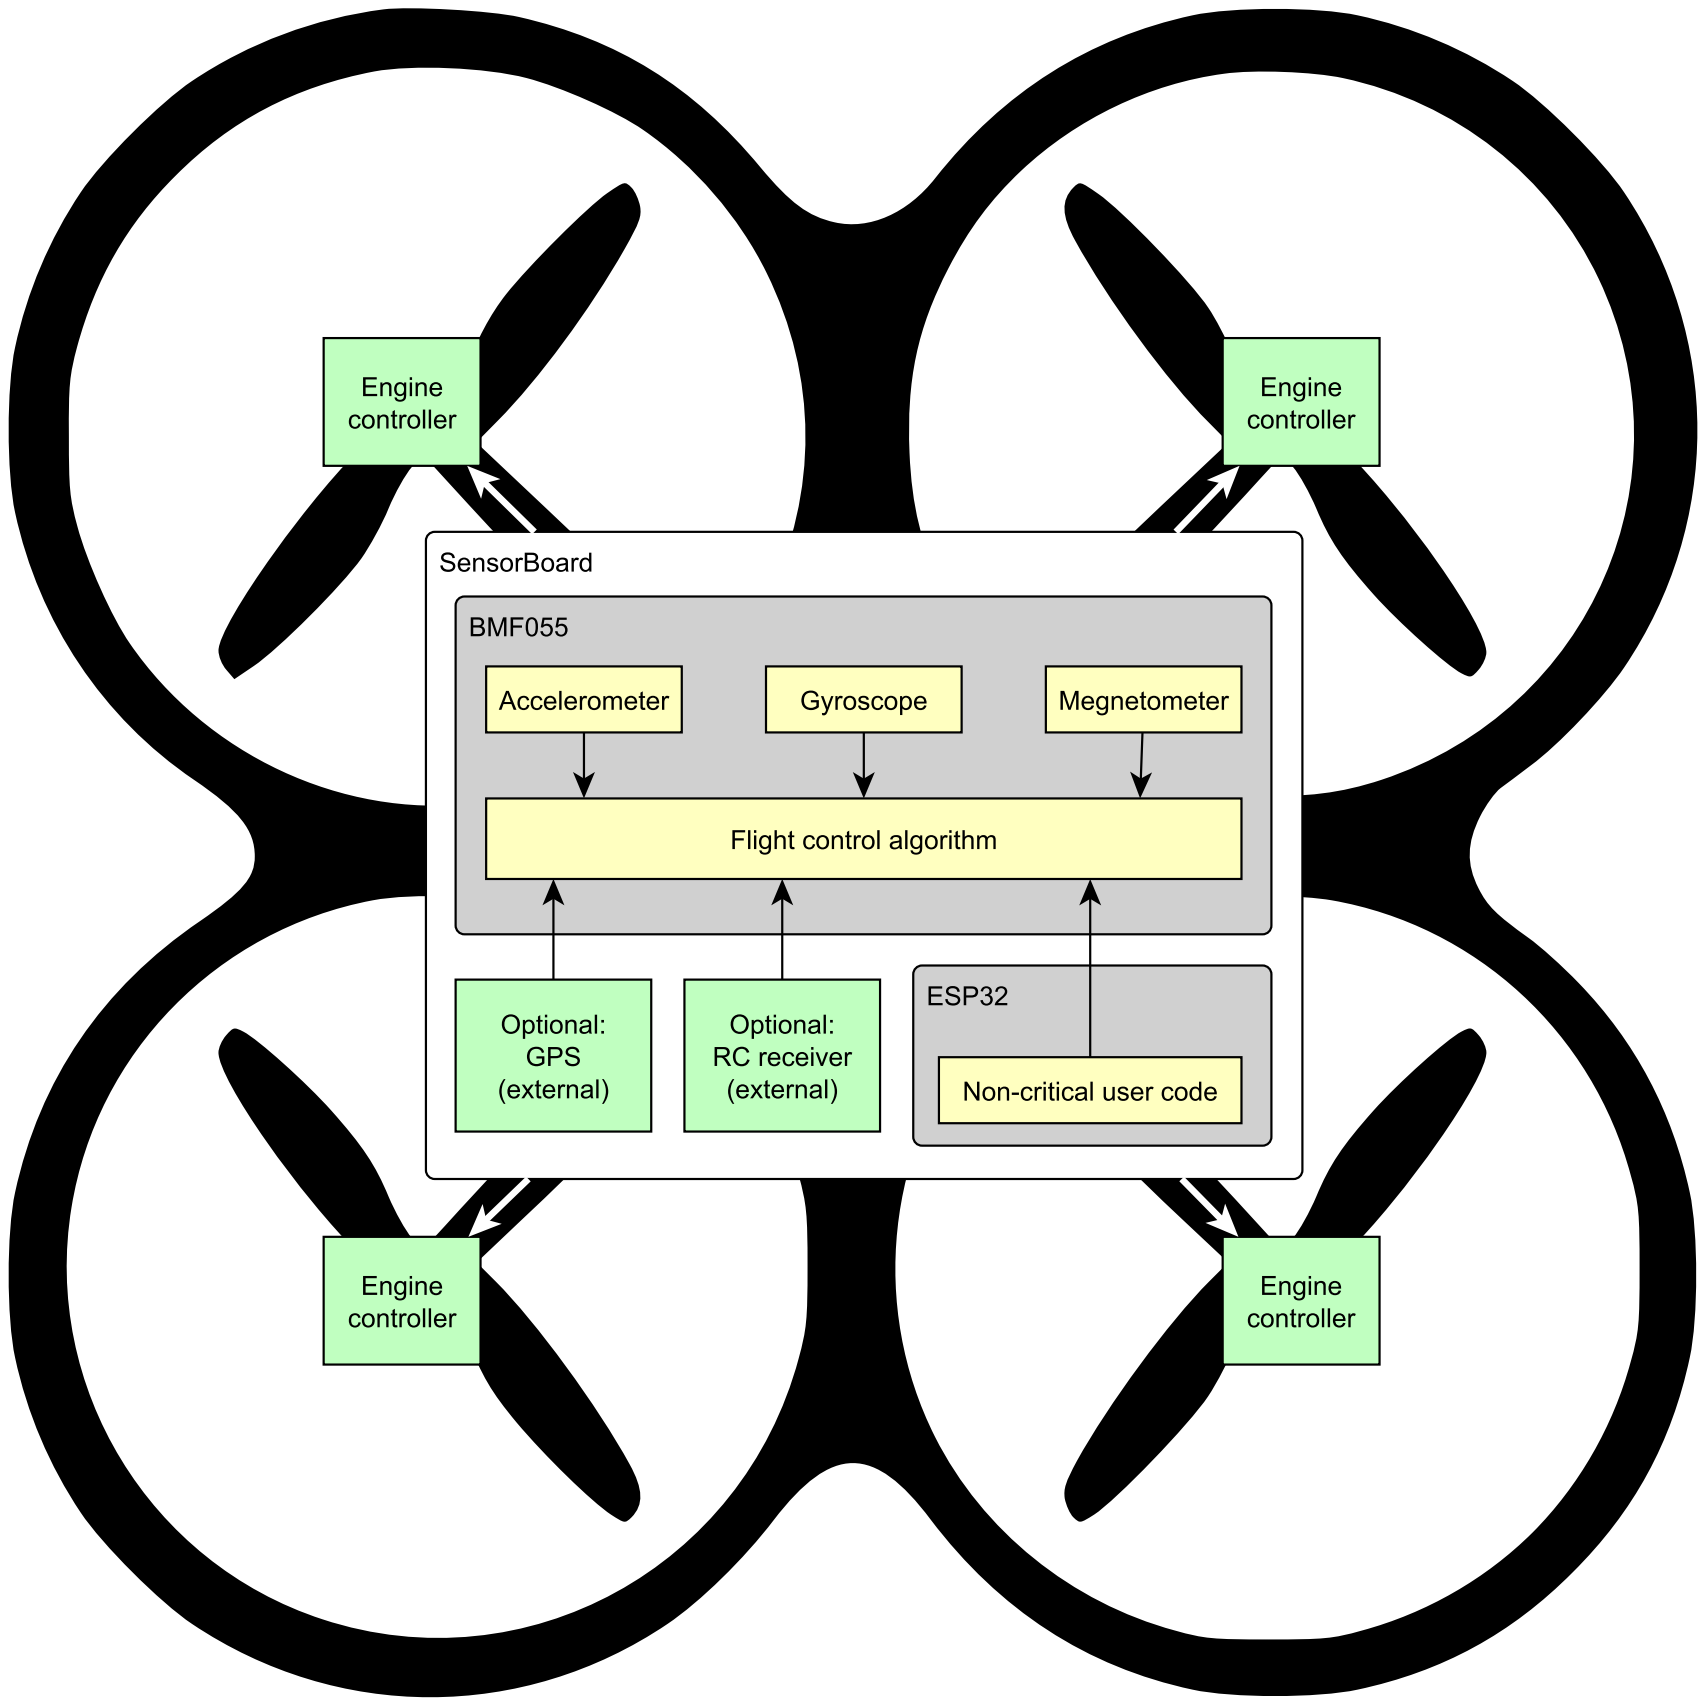
[picture p87: page 1]
