bsaid/SensorBoard/thesisCloneUIB/img/UsageExamplesGrid.pdf

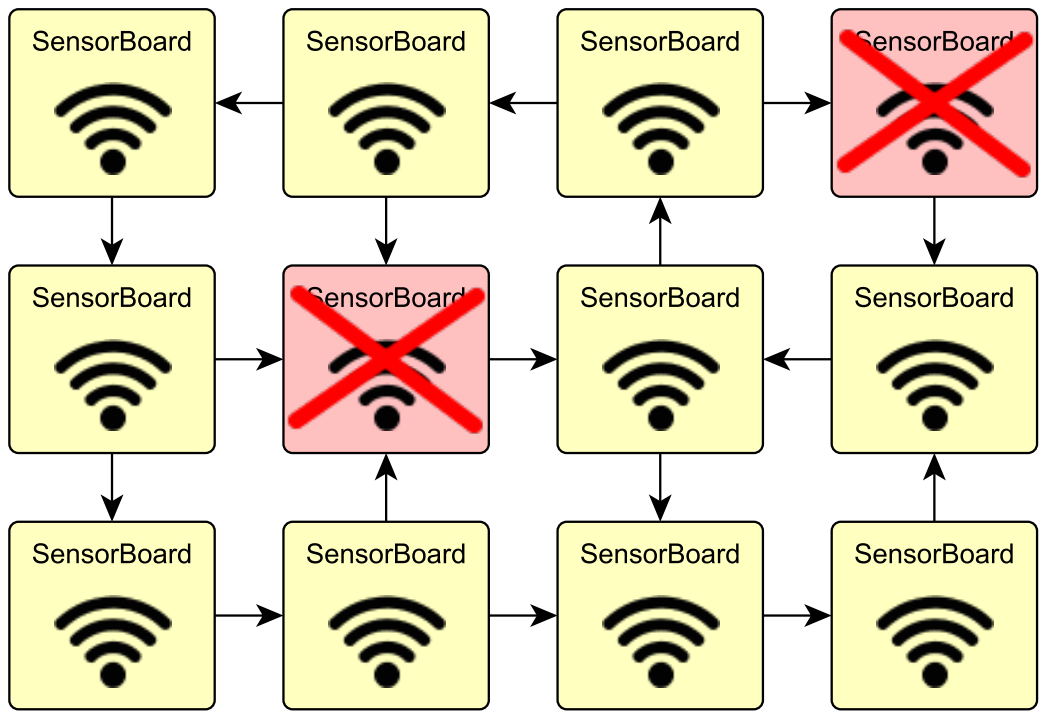
[picture p88: page 1]
