bsaid/SensorBoard/thesisCloneUIB/img/UsageExamplesIoT.pdf

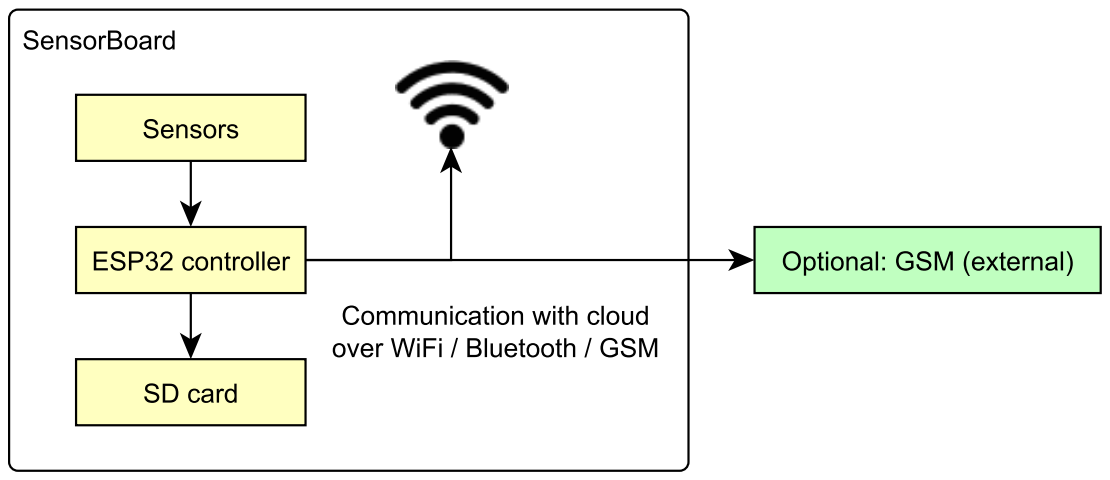
[picture p89: page 1]
