bsaid/SensorBoard/thesisCloneUIB/img/UsageExamplesLogger1.pdf

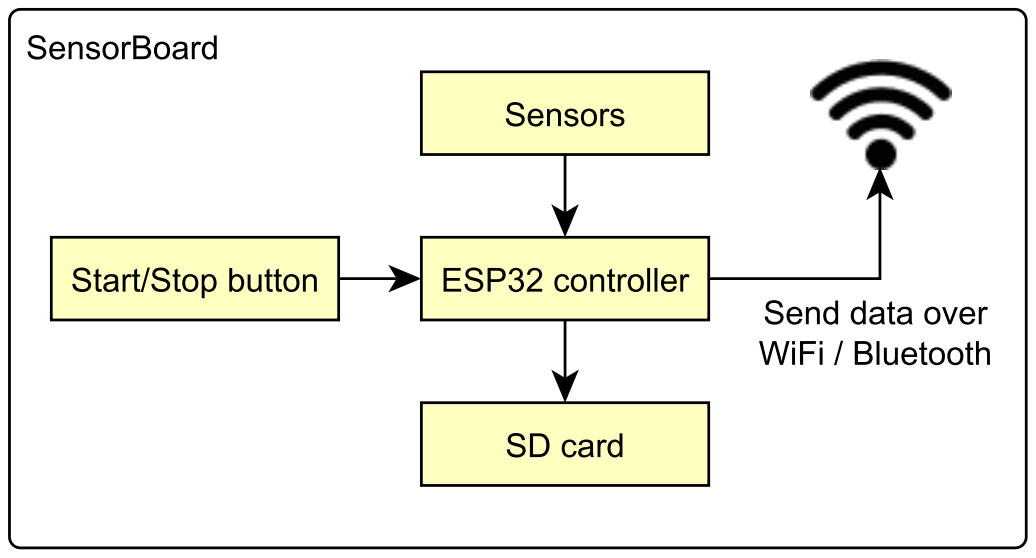
[picture p90: page 1]
