bsaid/SensorBoard/thesisCloneUIB/img/UsageExamplesLogger2.pdf

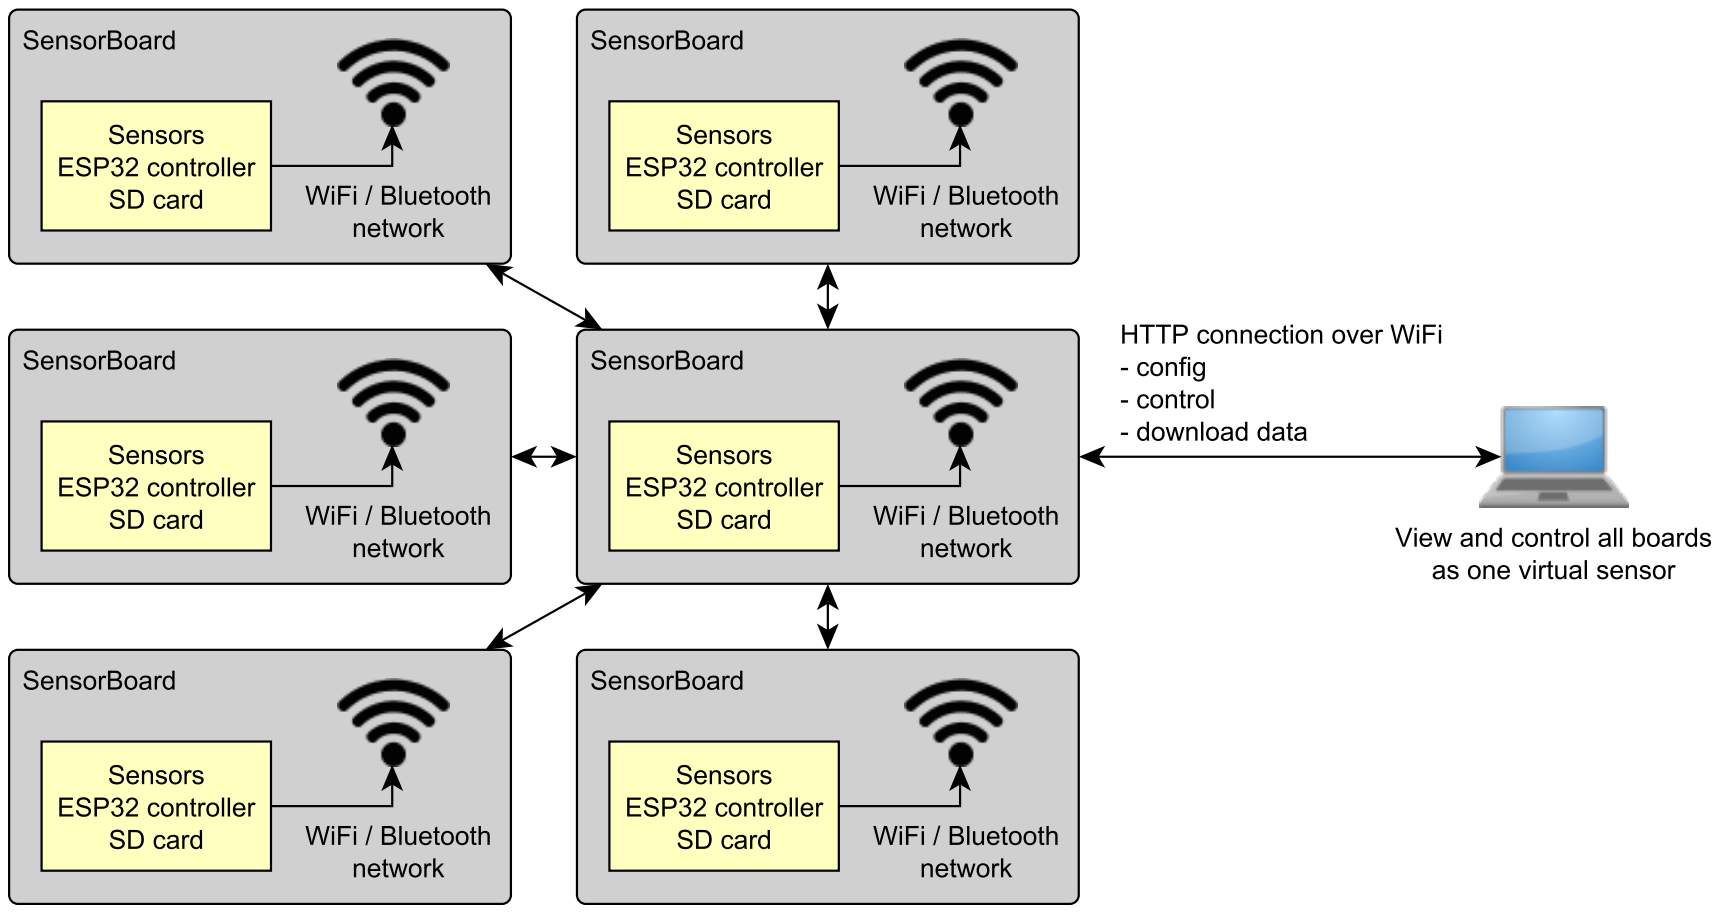
[picture p91: page 1]
