bsaid/SensorBoard/thesisCloneUIB/img/UsageExamplesLoggerHorse.pdf

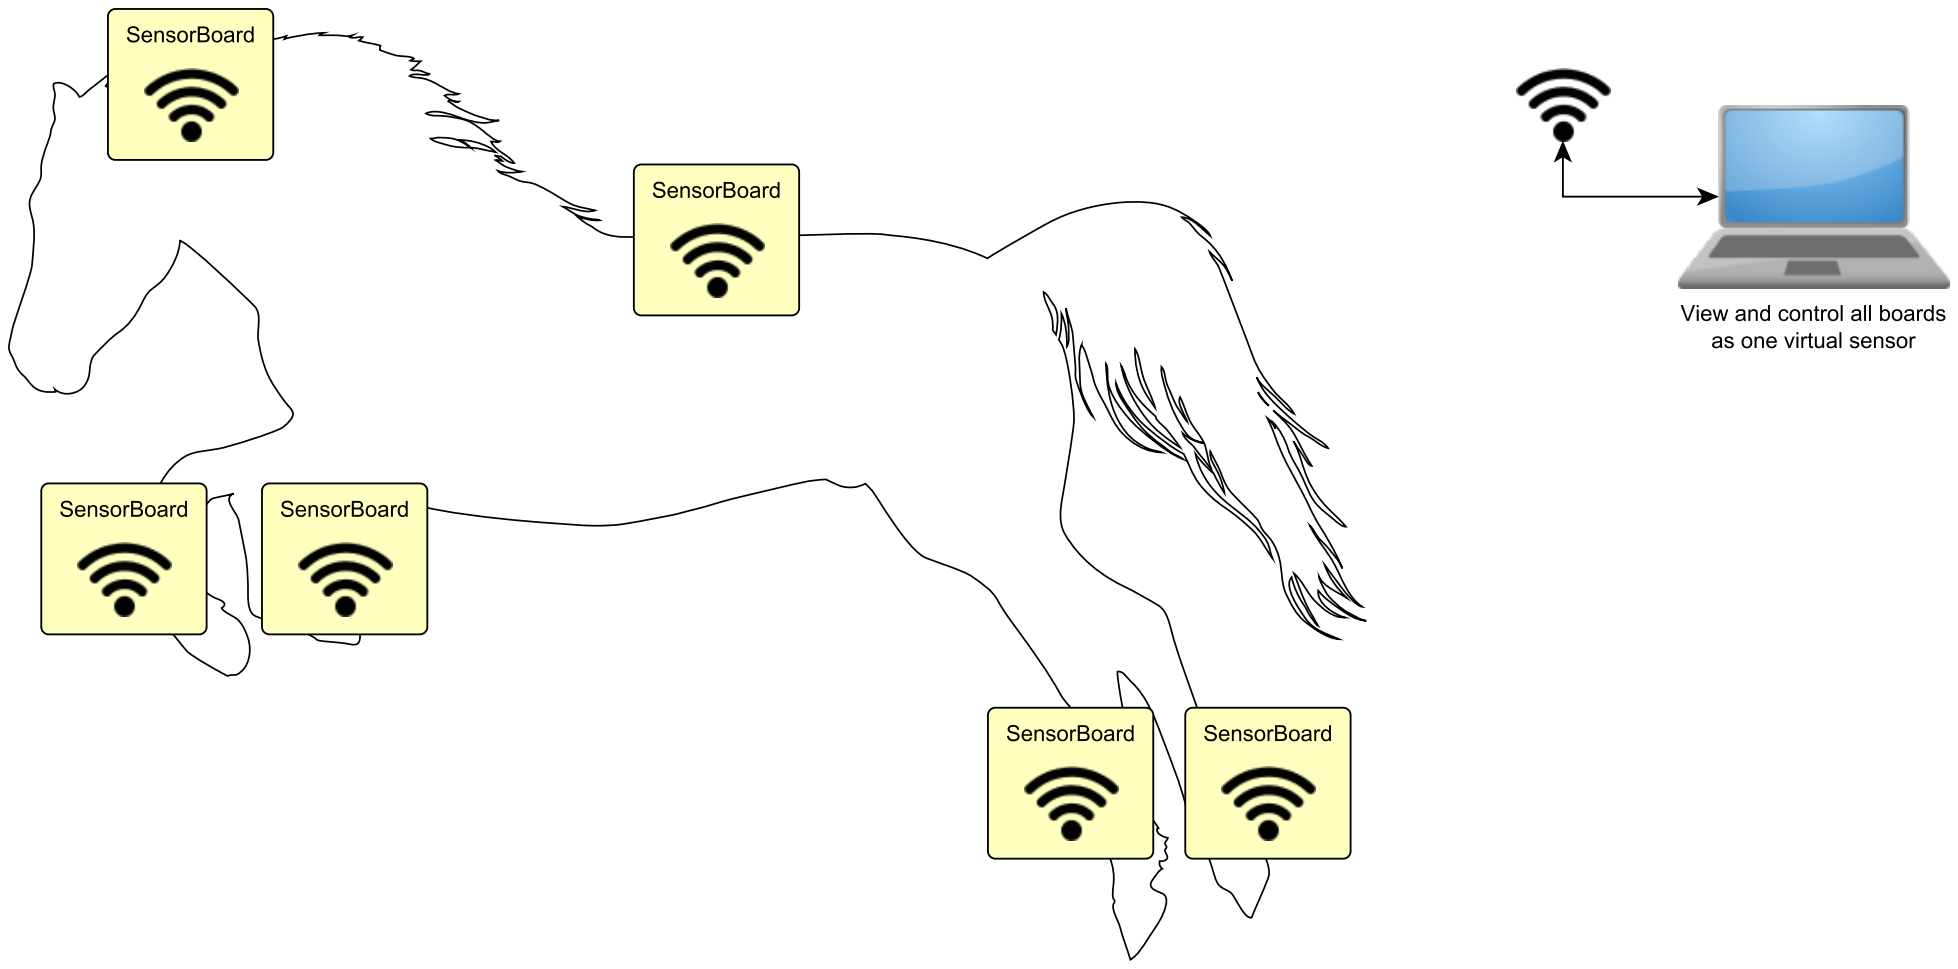
[picture p92: page 1]
