bsaid/SensorBoard/thesisCloneUIB/img/UsageExamplesPythonRobot.pdf

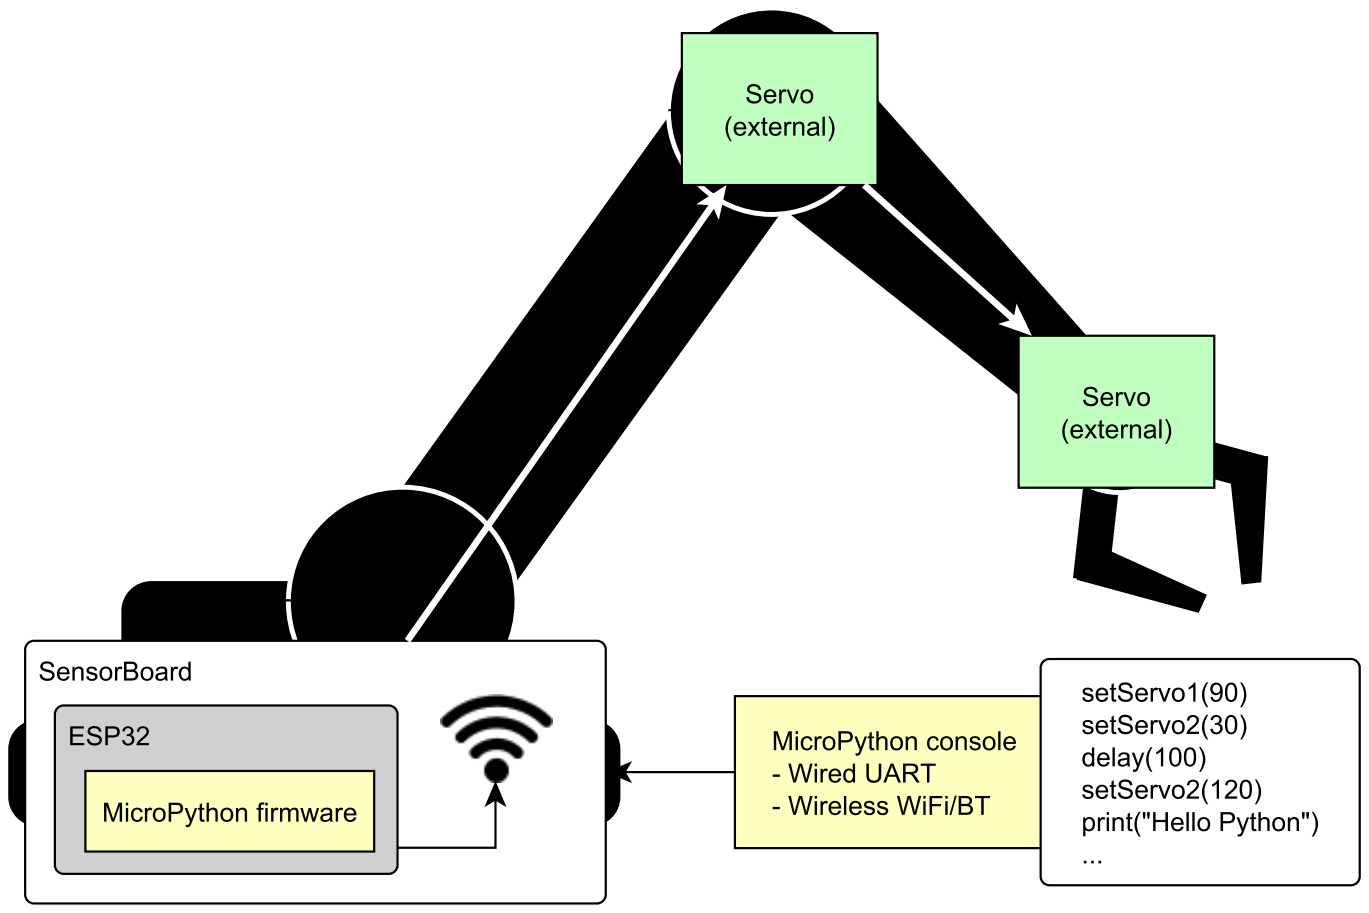
[picture p93: page 1]
