bsaid/SensorBoard/thesisCloneUIB/img/UsageExamplesRTOS.pdf

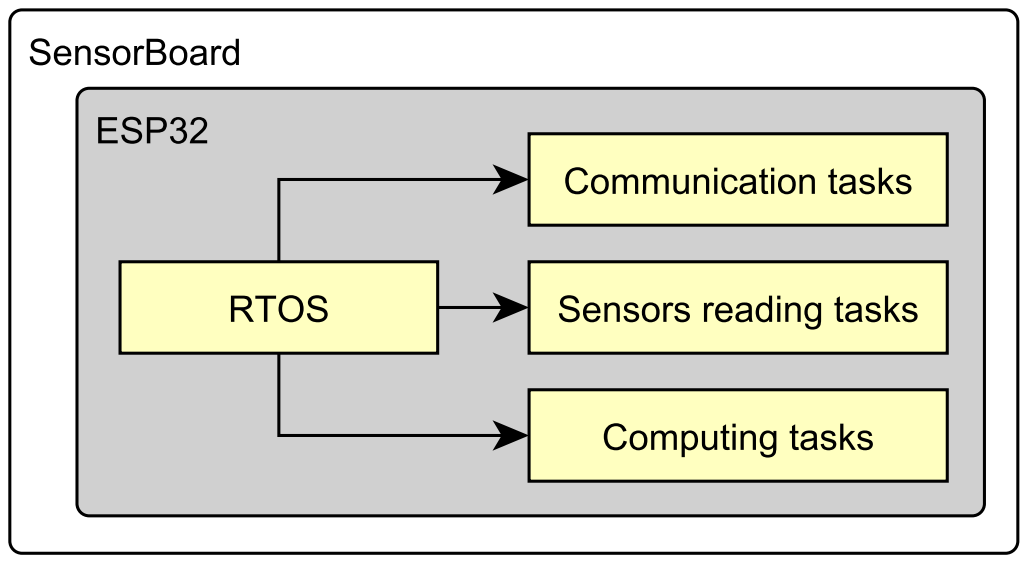
[picture p94: page 1]
