bsaid/SensorBoard/thesisCloneUIB/img/UsageExamplesServer.pdf

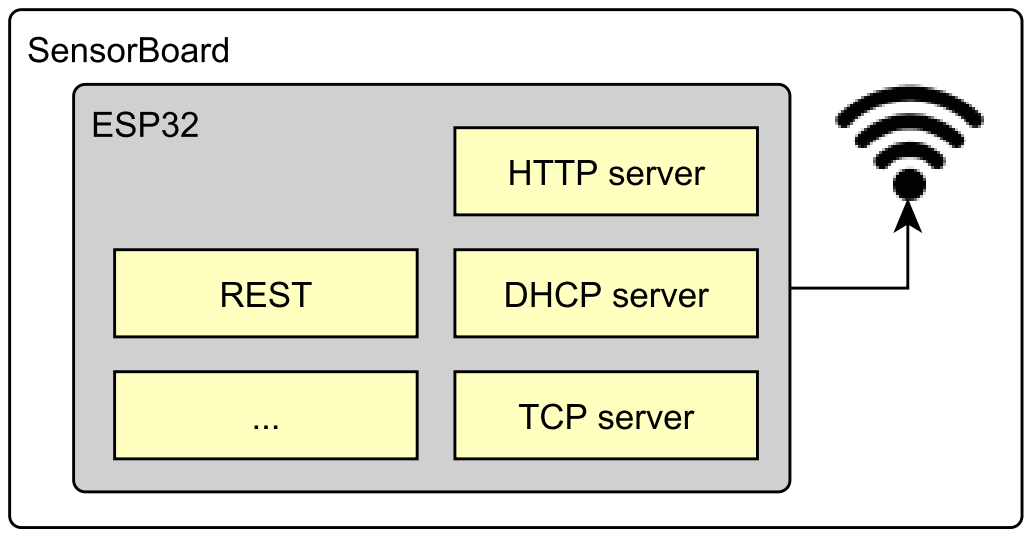
[picture p95: page 1]
