bsaid/SensorBoard/thesisCloneUIB/img/UsageExamplesTDOA.pdf

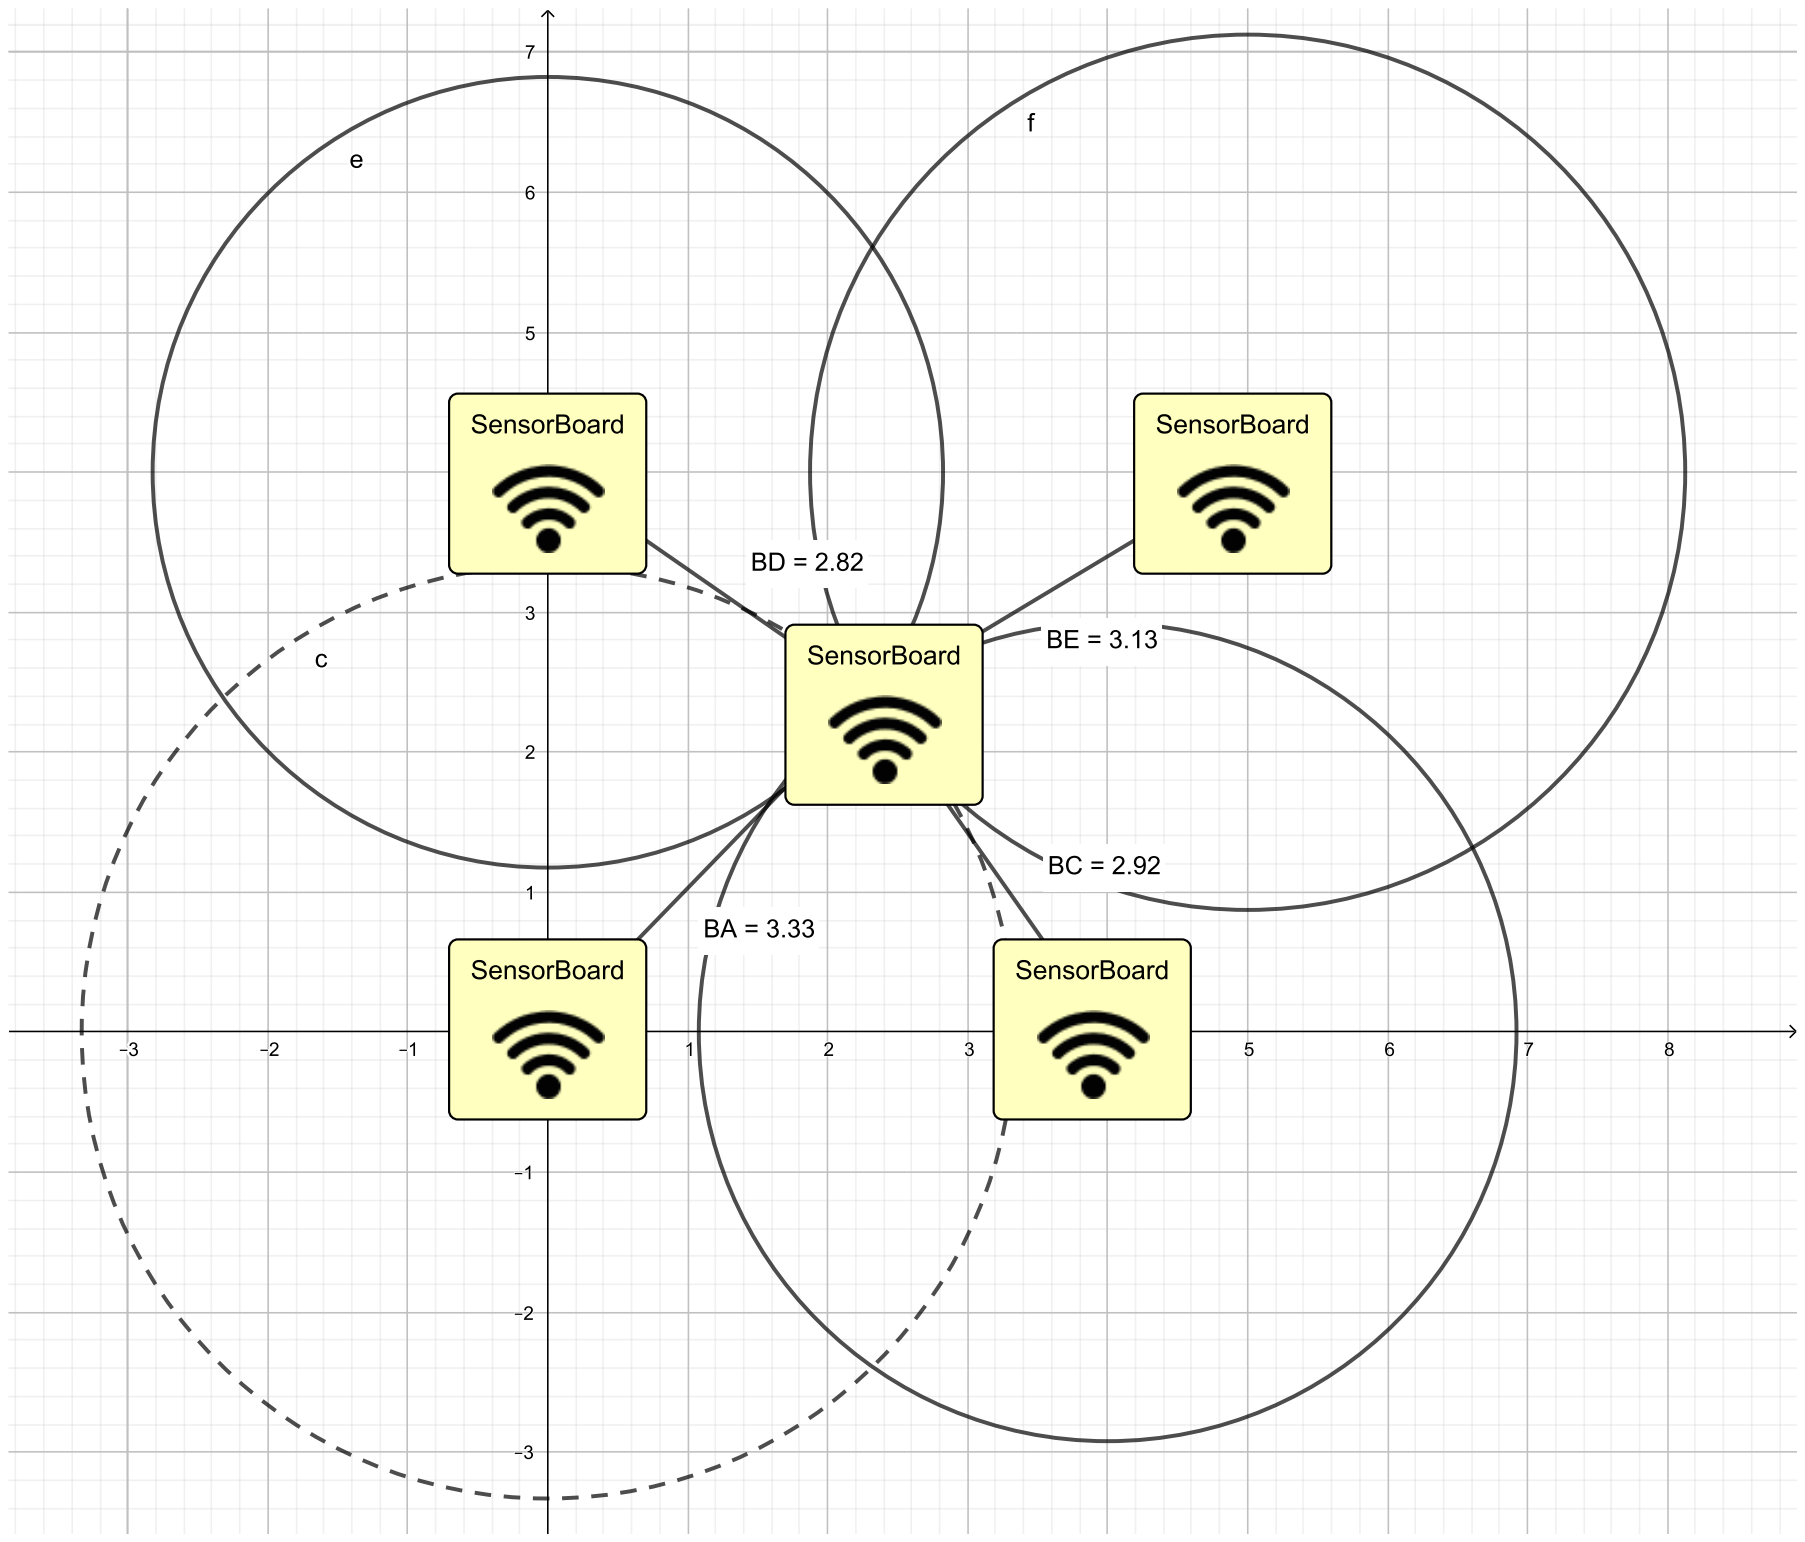
[picture p96: page 1]
