bsaid/SensorBoard/thesisCloneUIB/img/assemblingHW.pdf

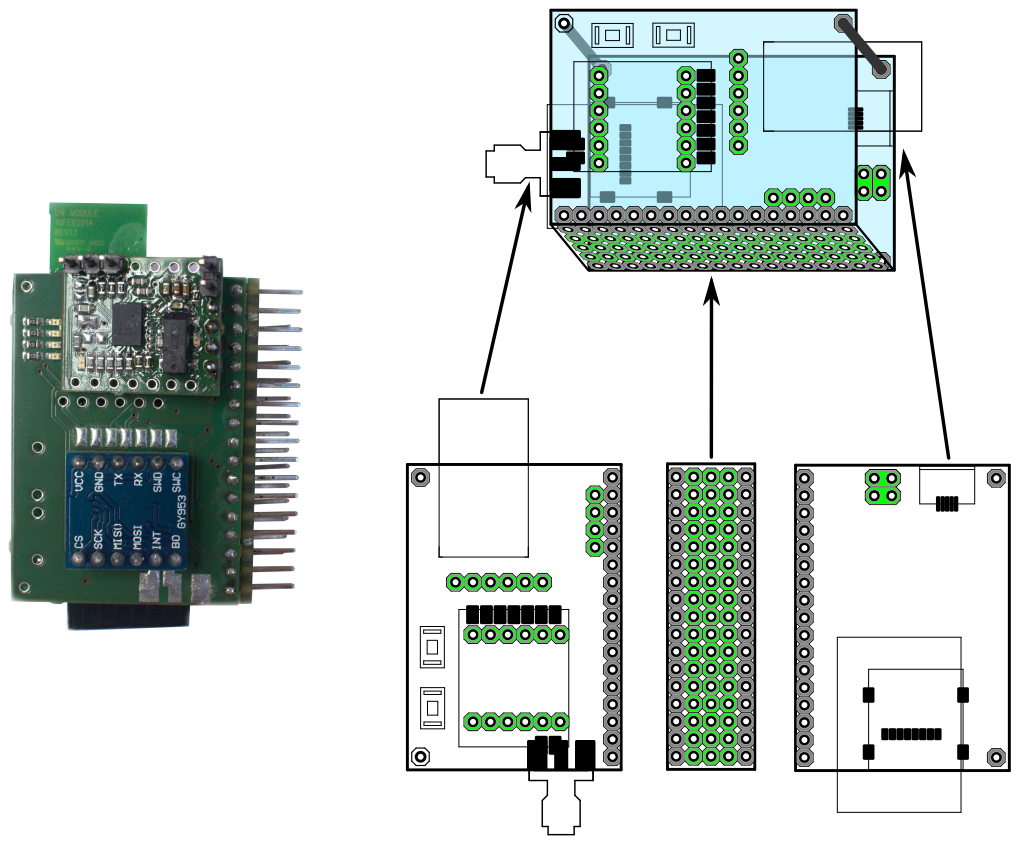
[picture p97: page 1]
