bsaid/SensorBoard/thesisCloneUIB/img/componentsDescription.pdf

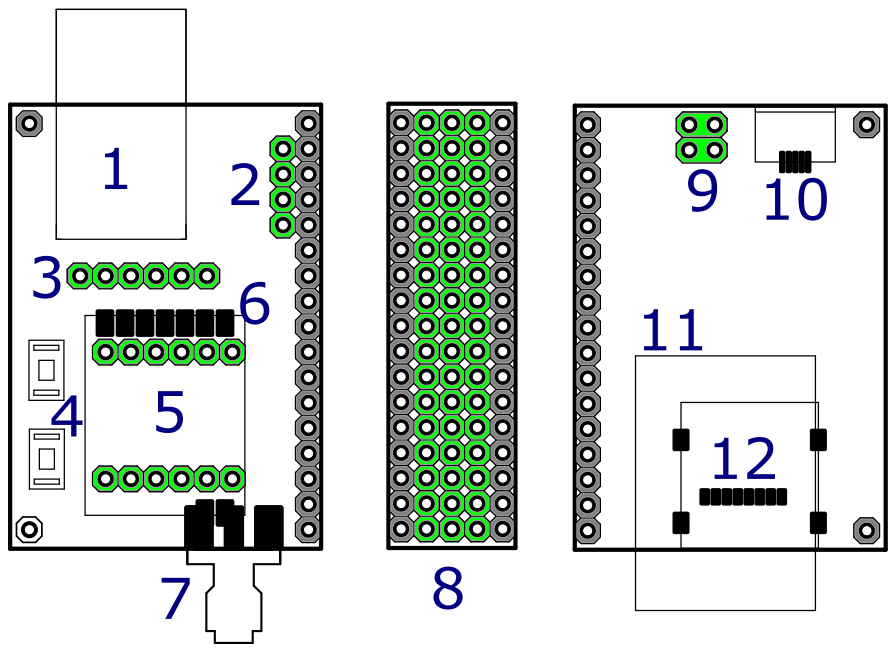
[picture p98: page 1]
