bsaid/SensorBoard/thesisCloneUIB/img/externalPins.pdf

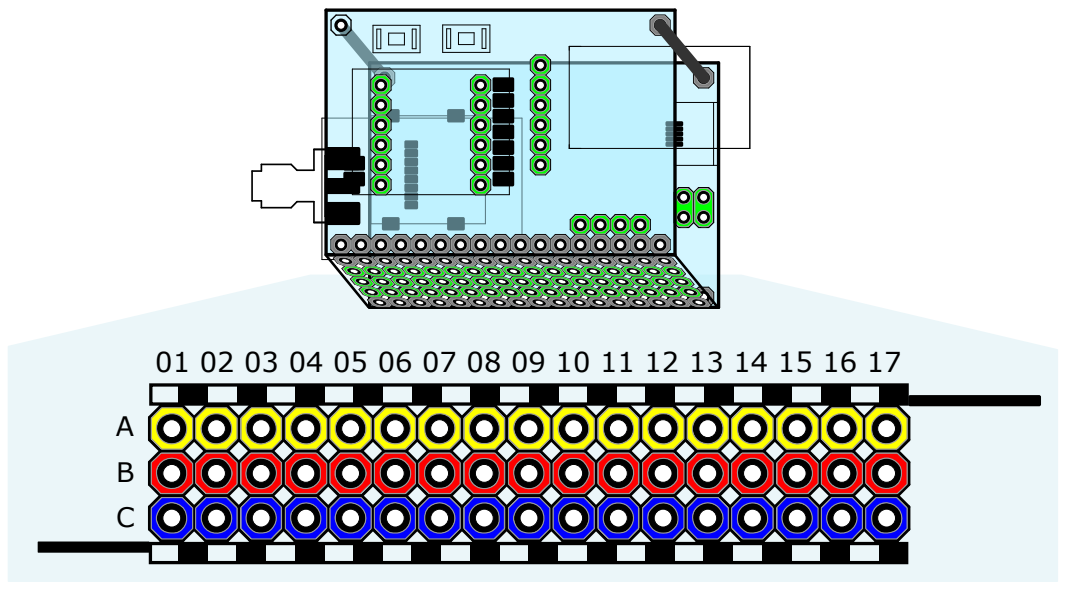
[picture p99: page 1]
