bsaid/SensorBoard/thesisCloneUIB/img/pinSections.pdf

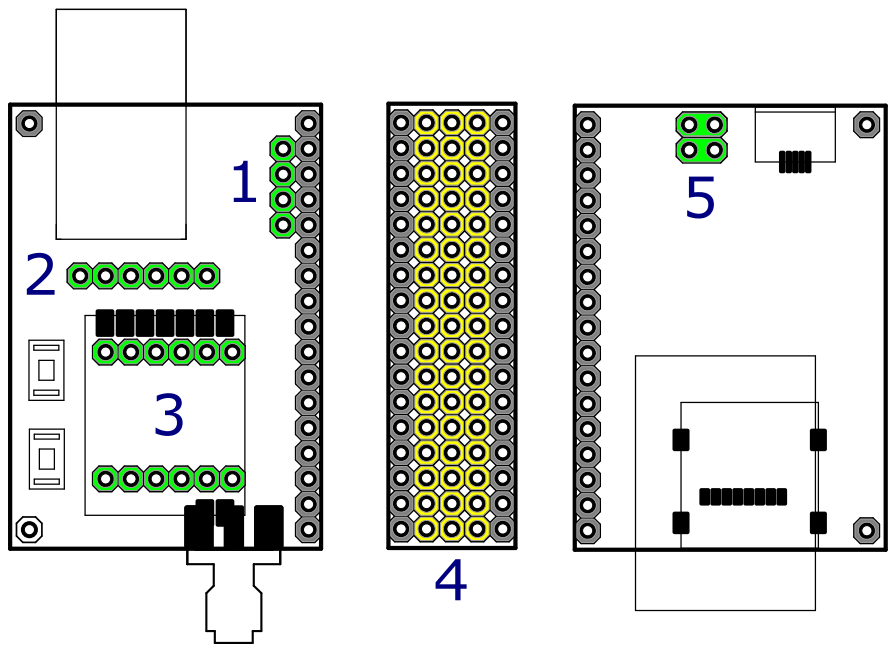
[picture p100: page 1]
