bsaid/SensorBoard/thesisCloneUIB/img/brd.pdf

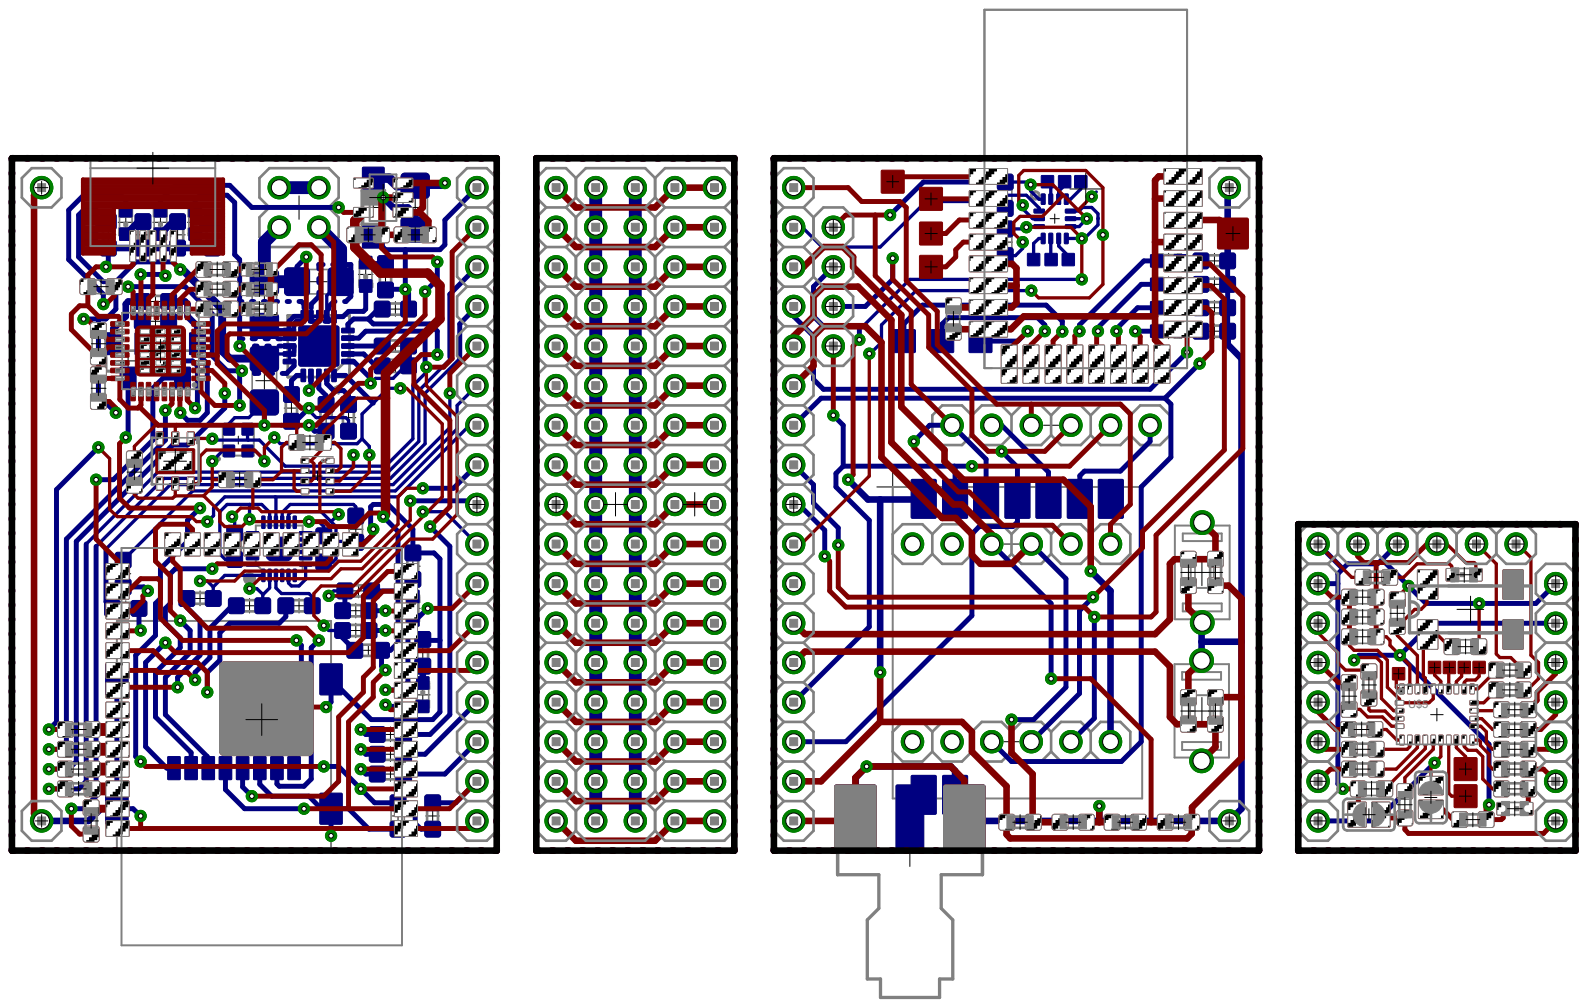
[picture p101: page 1]
