bsaid/SensorBoard/thesisCloneUIB/img/smtPasteTemplate.pdf

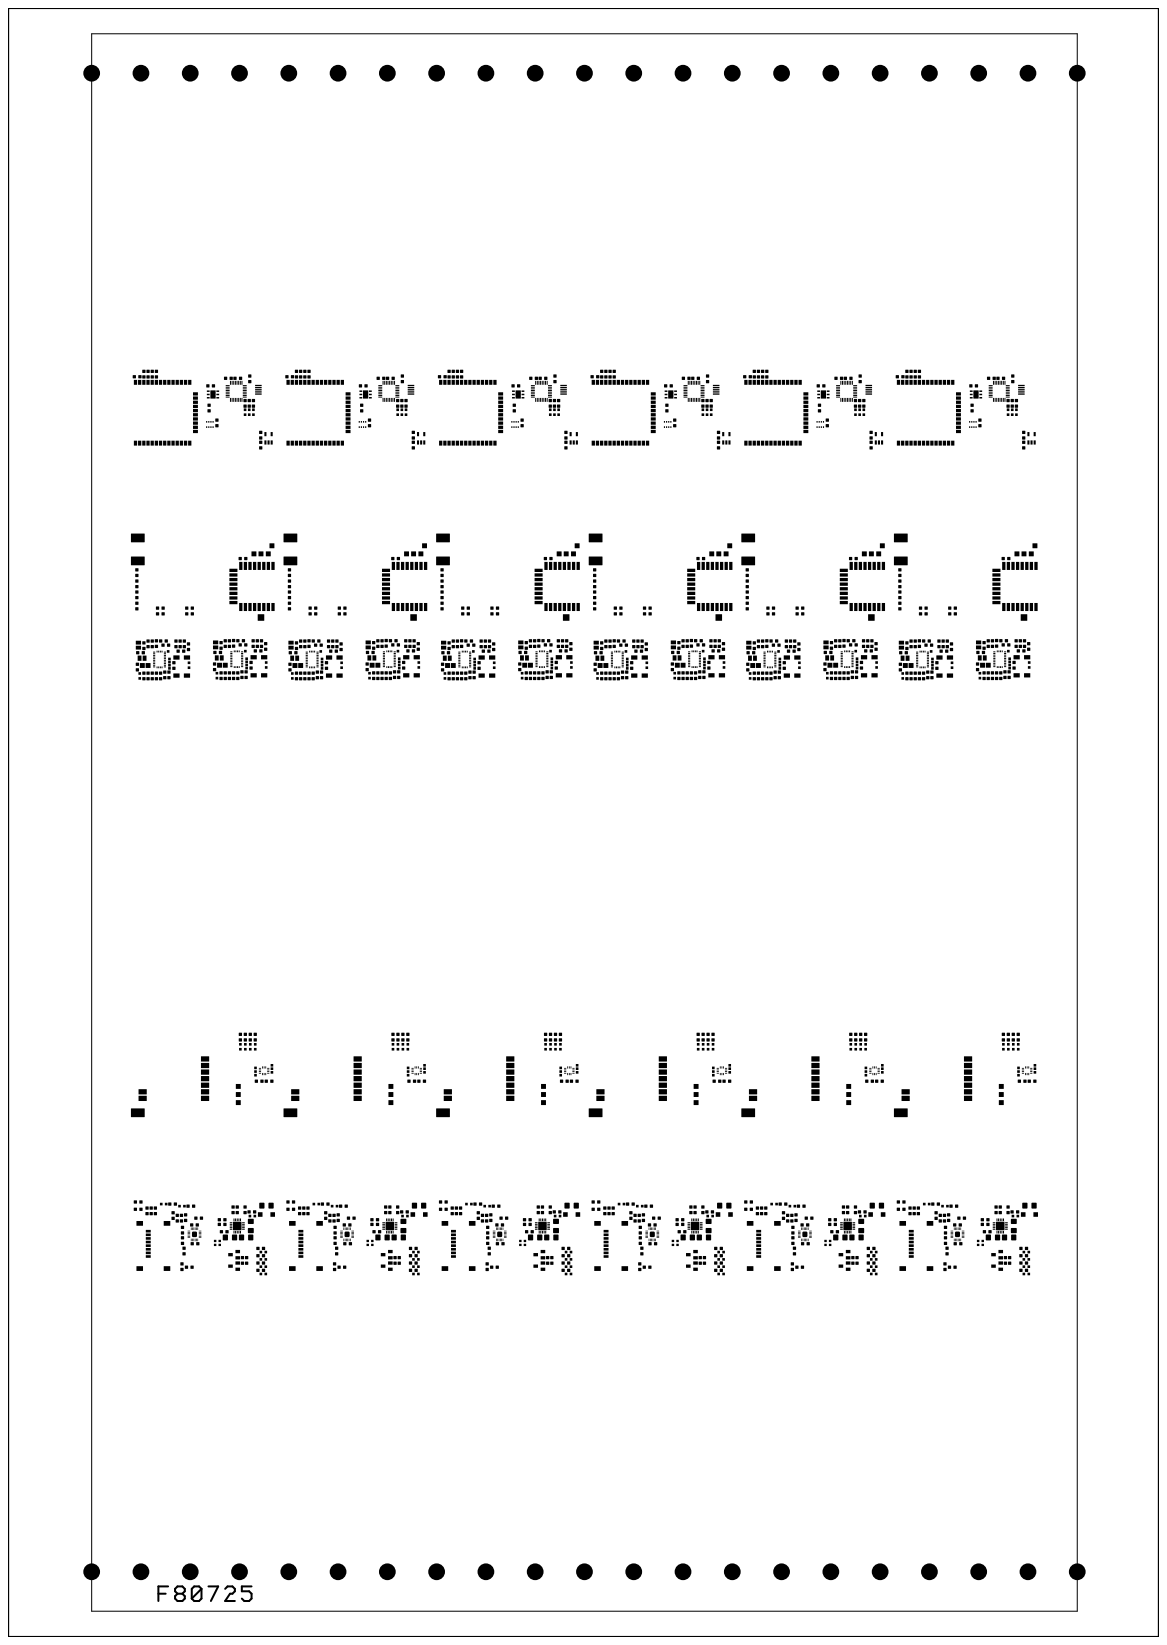
[picture p102: page 1]
