bsaid/SensorBoard/hardware/export/SensorBoardBrd.pdf

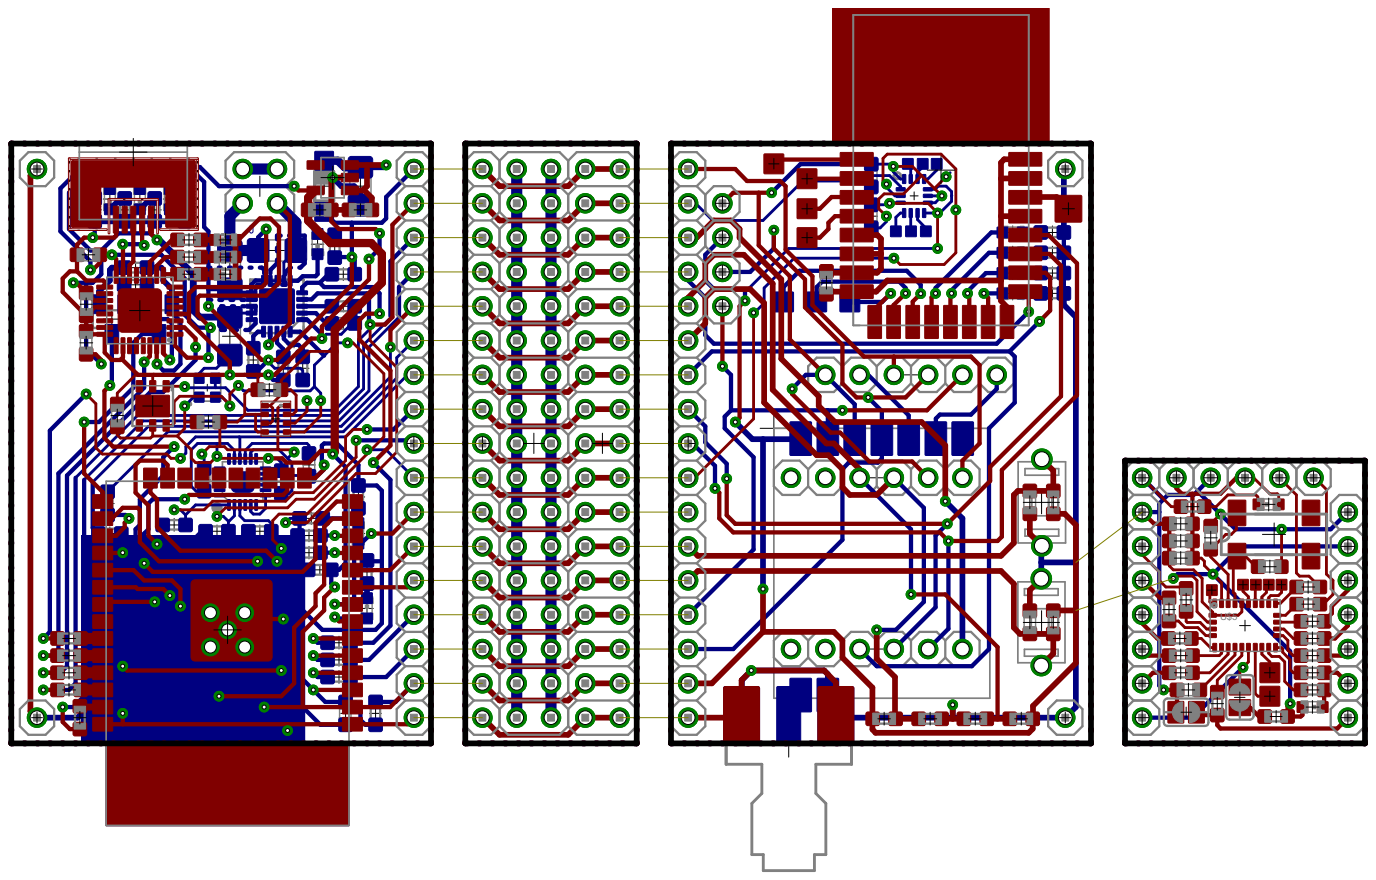
[picture p103: page 1]
