bsaid/SensorBoard/hardware/export/SensorBoardBrd2to1.pdf

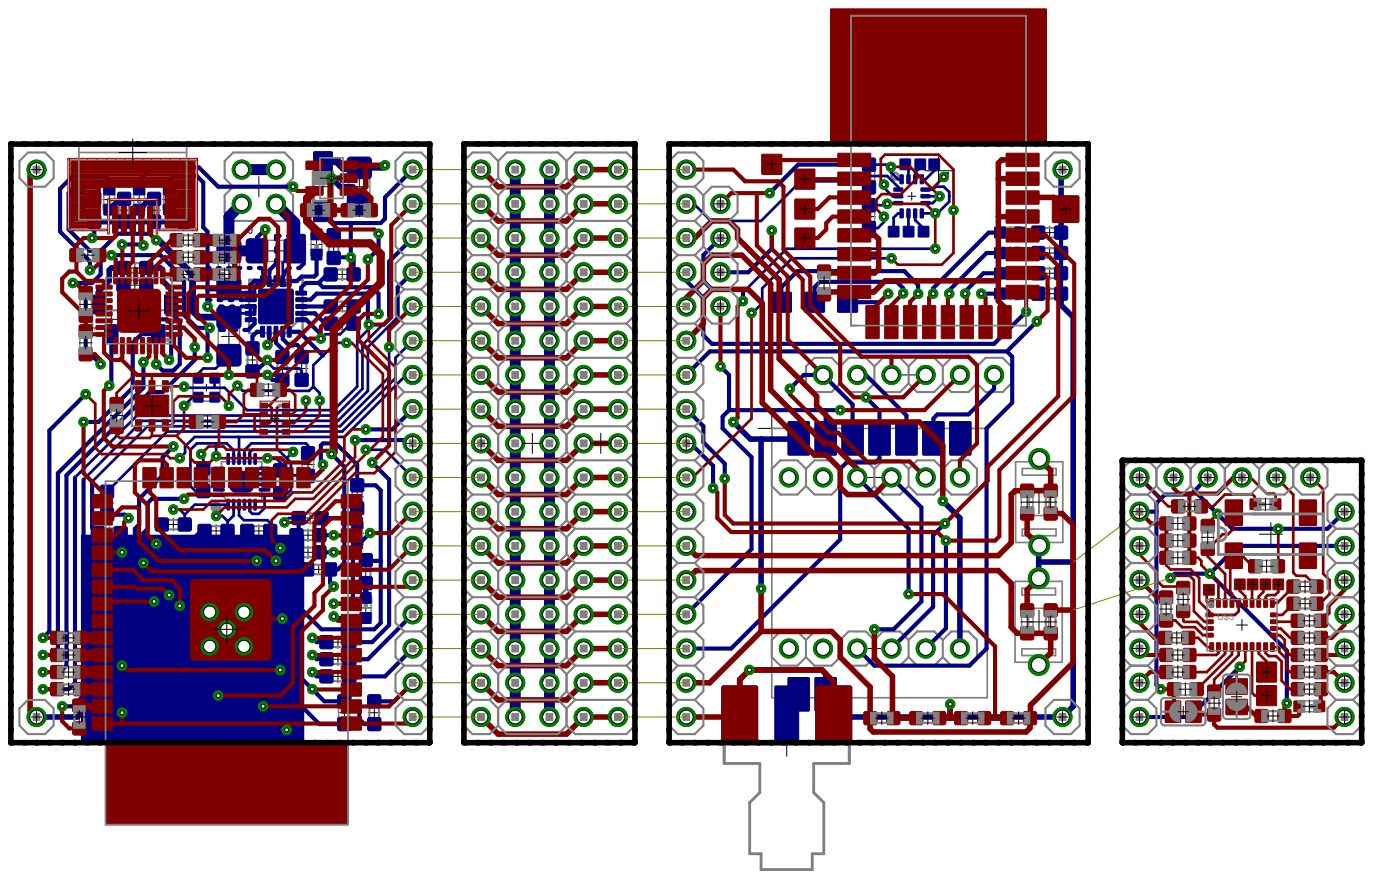
[picture p104: page 1]
