bsaid/SensorBoard/hardware/export/SensorBoardBrdBottom.pdf

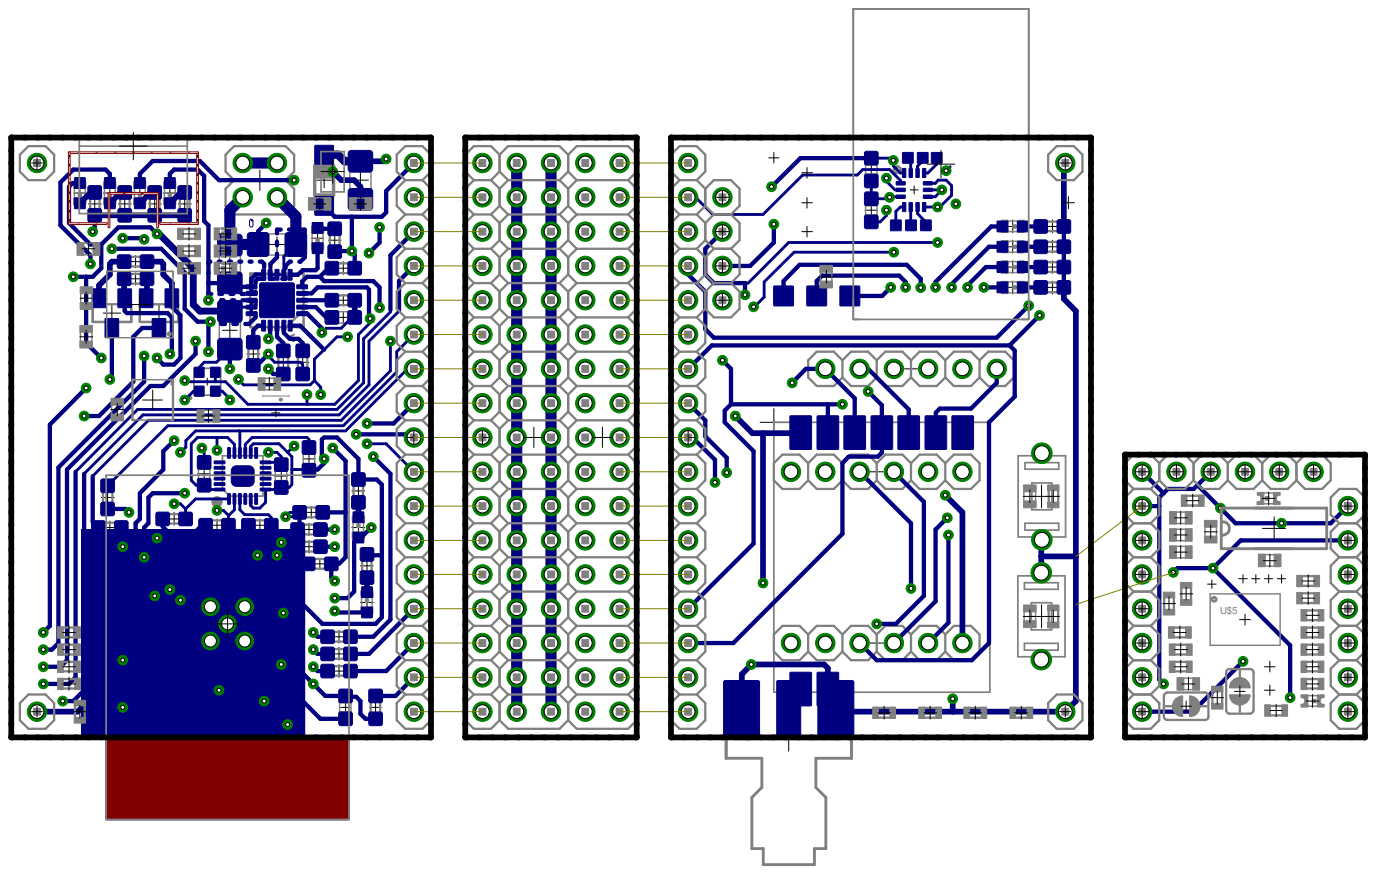
[picture p105: page 1]
