bsaid/SensorBoard/hardware/export/SensorBoardBrdTop.pdf

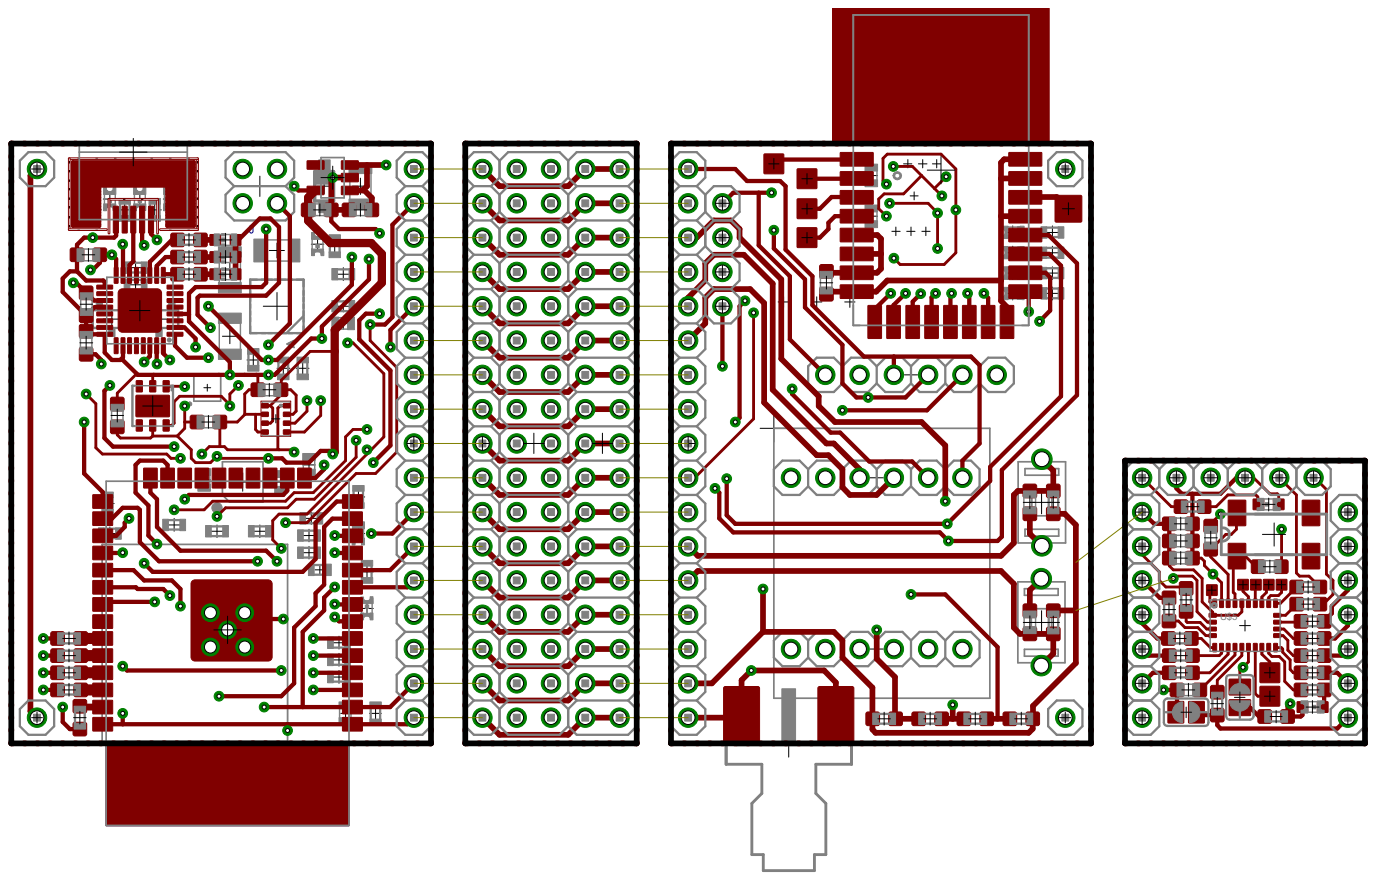
[picture p106: page 1]
