bsaid/SensorBoard/hardware/export/SensorBoardSchematics.pdf

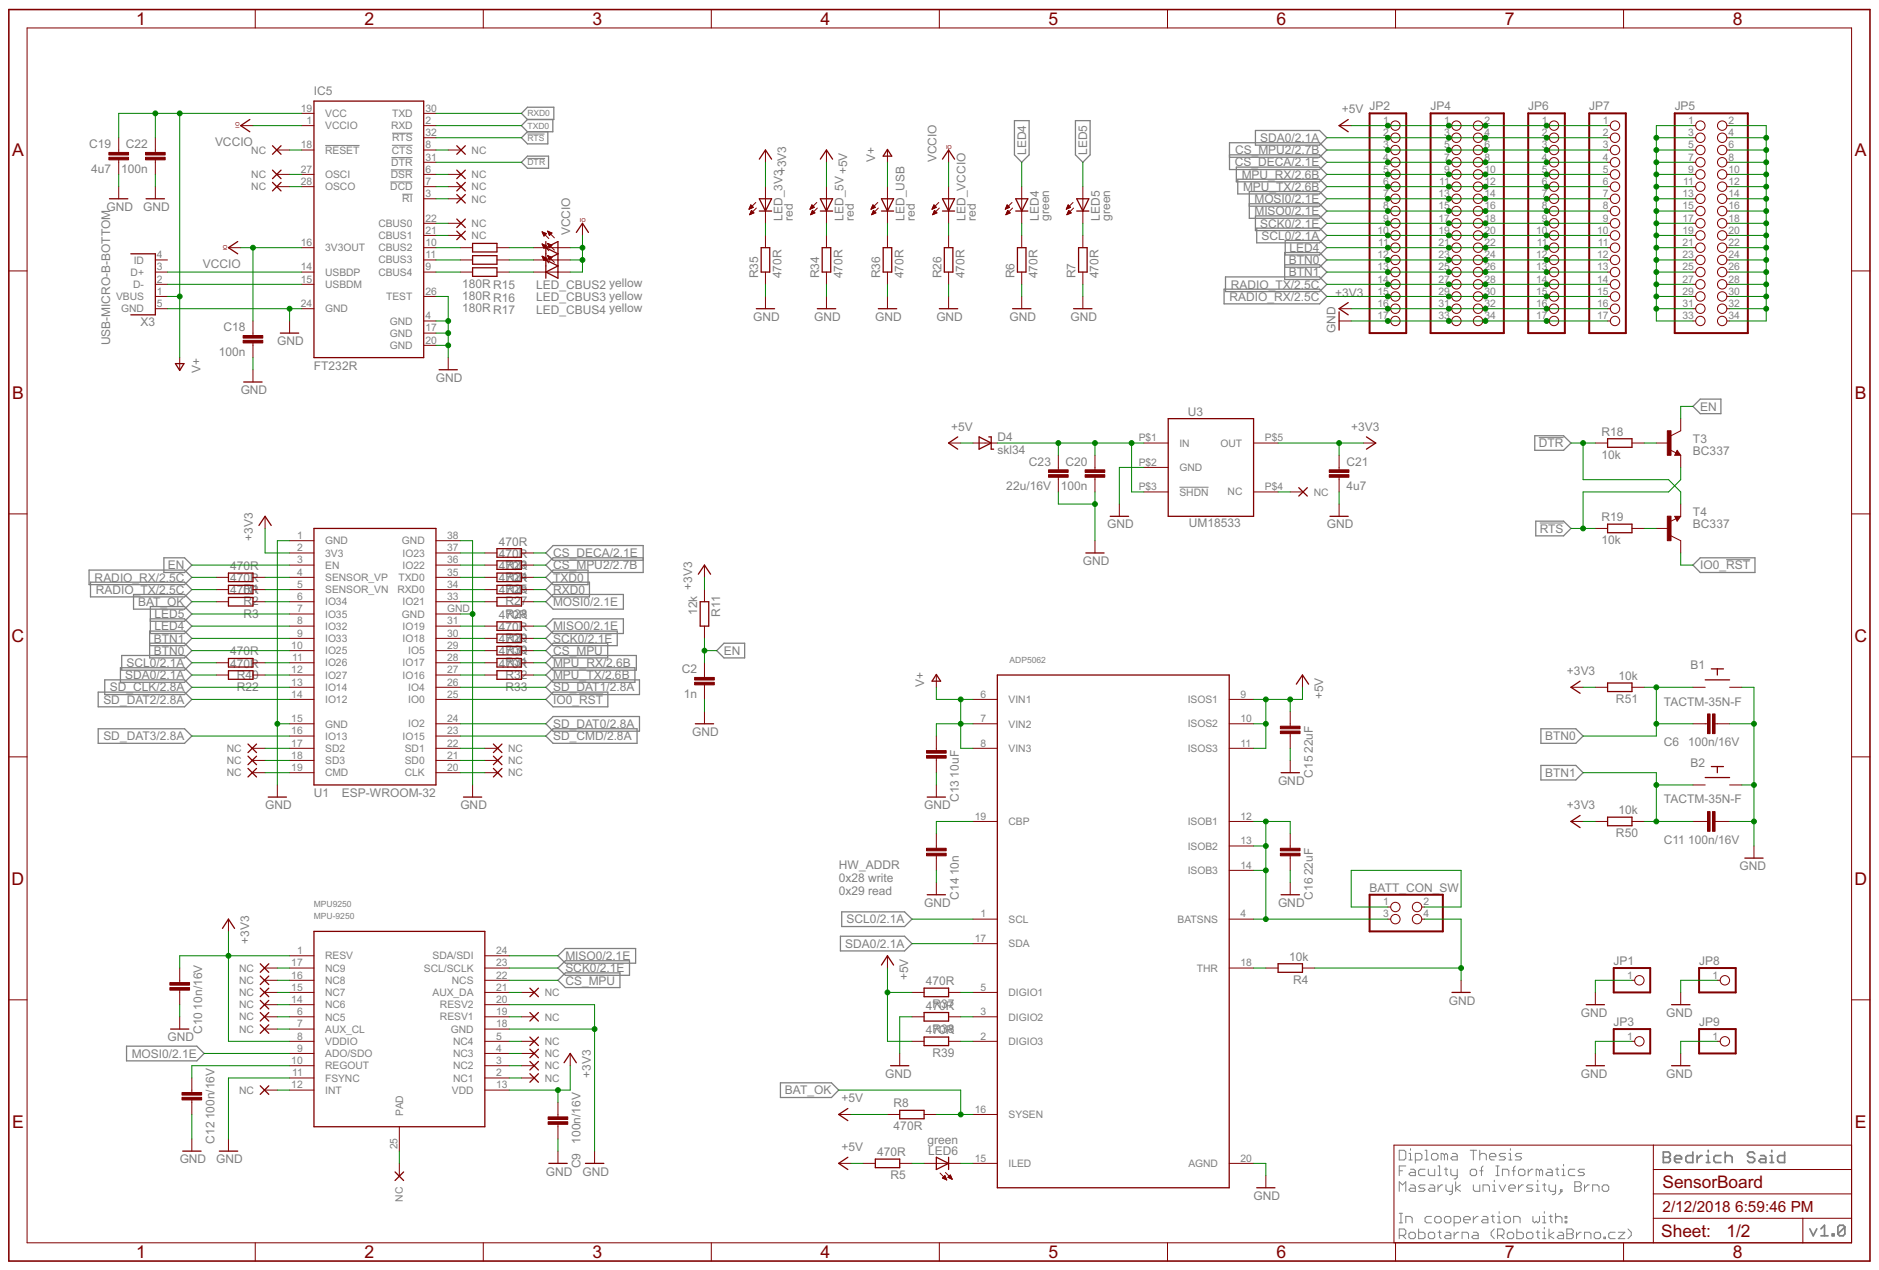
[picture p107: page 1]

11 12
13 14
15 16
17 18
19 20
21 22

BAT_OK | 7 | MOSI0/2.1E

SDA0/2.1A R40 | 13

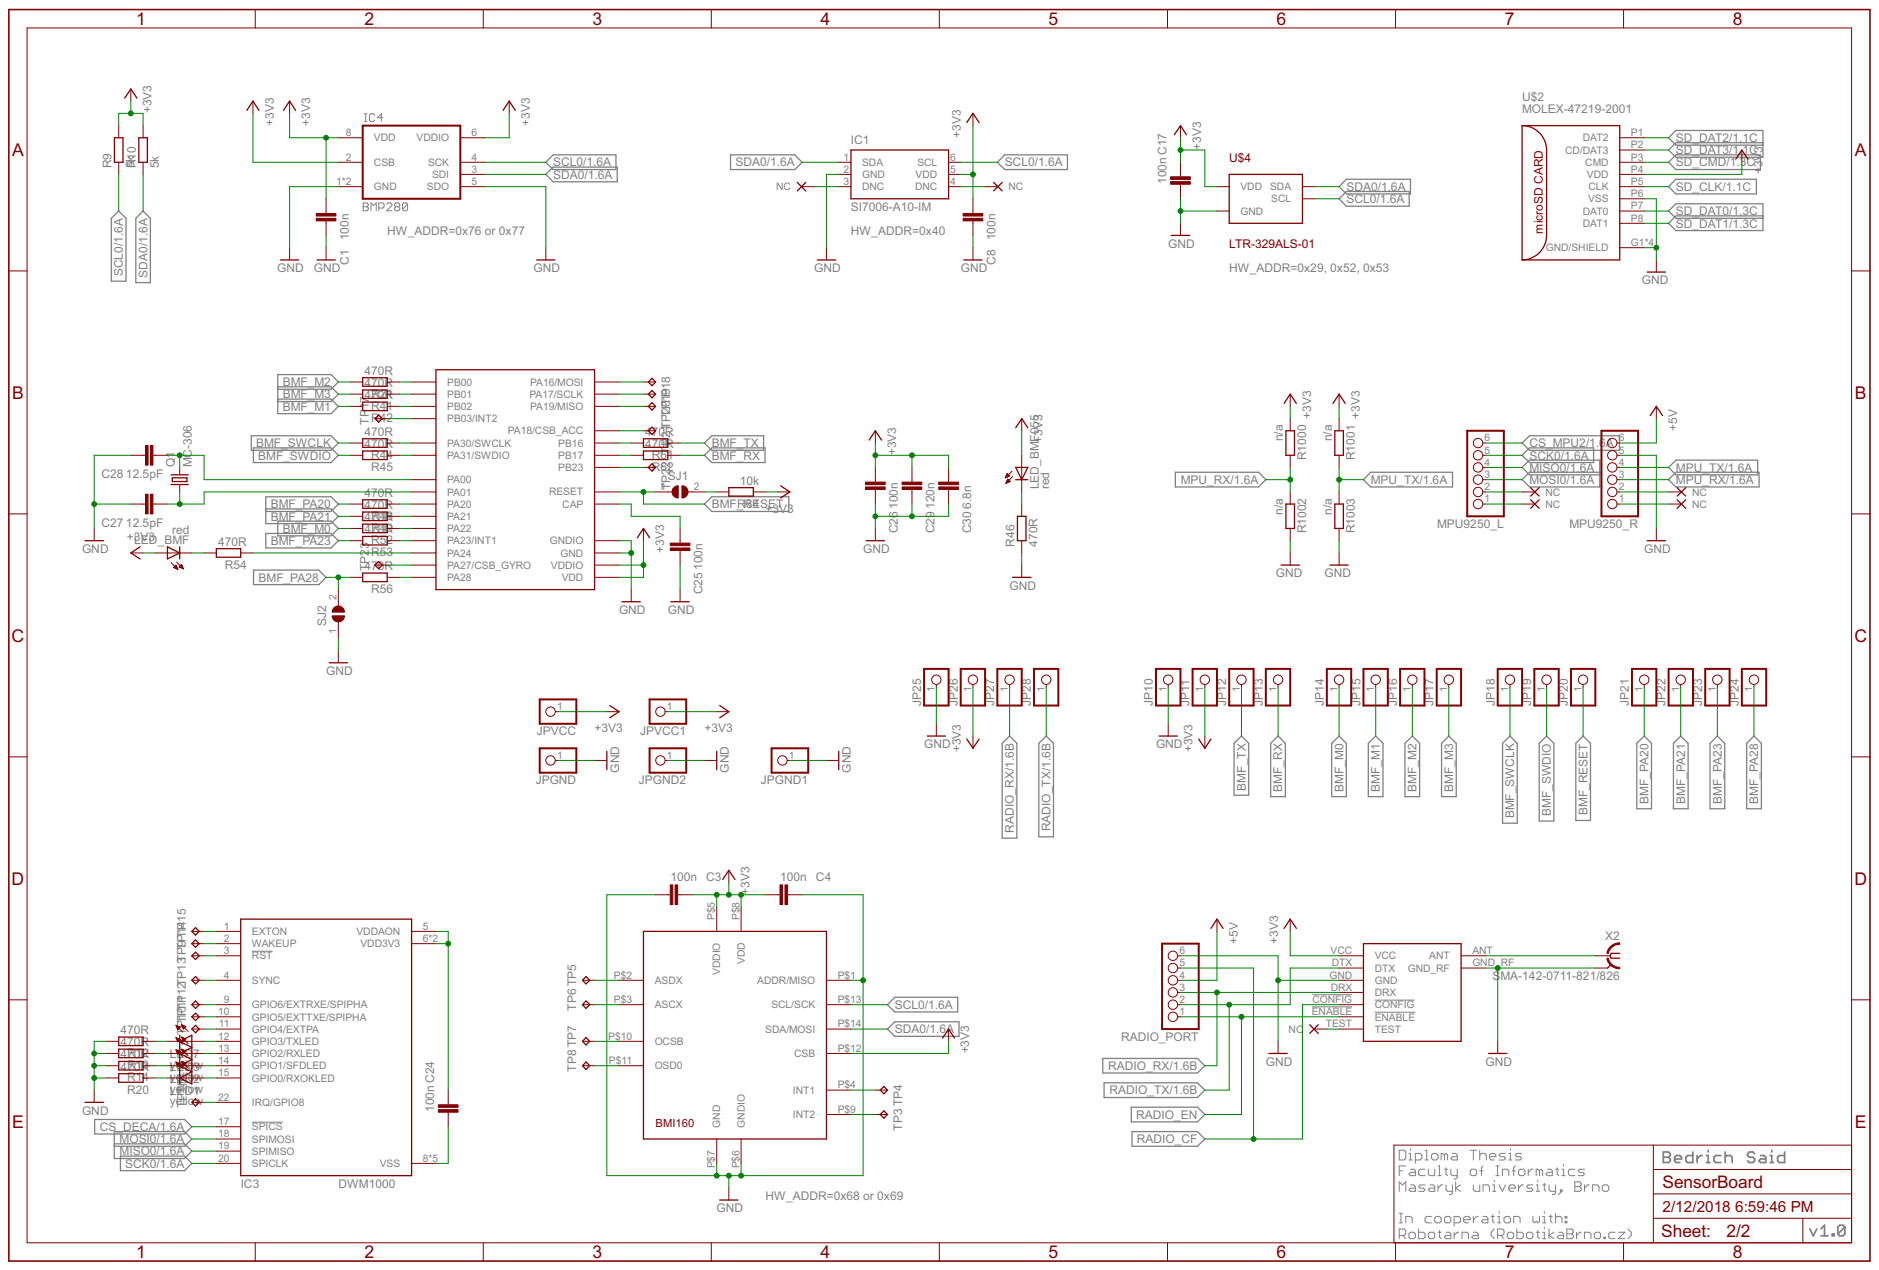
[picture p108: page 2]
