bsaid/SensorBoard/hardware/SensorBoard.brd

## EAGLE design hardware/SensorBoard.brd (2018-05-21)

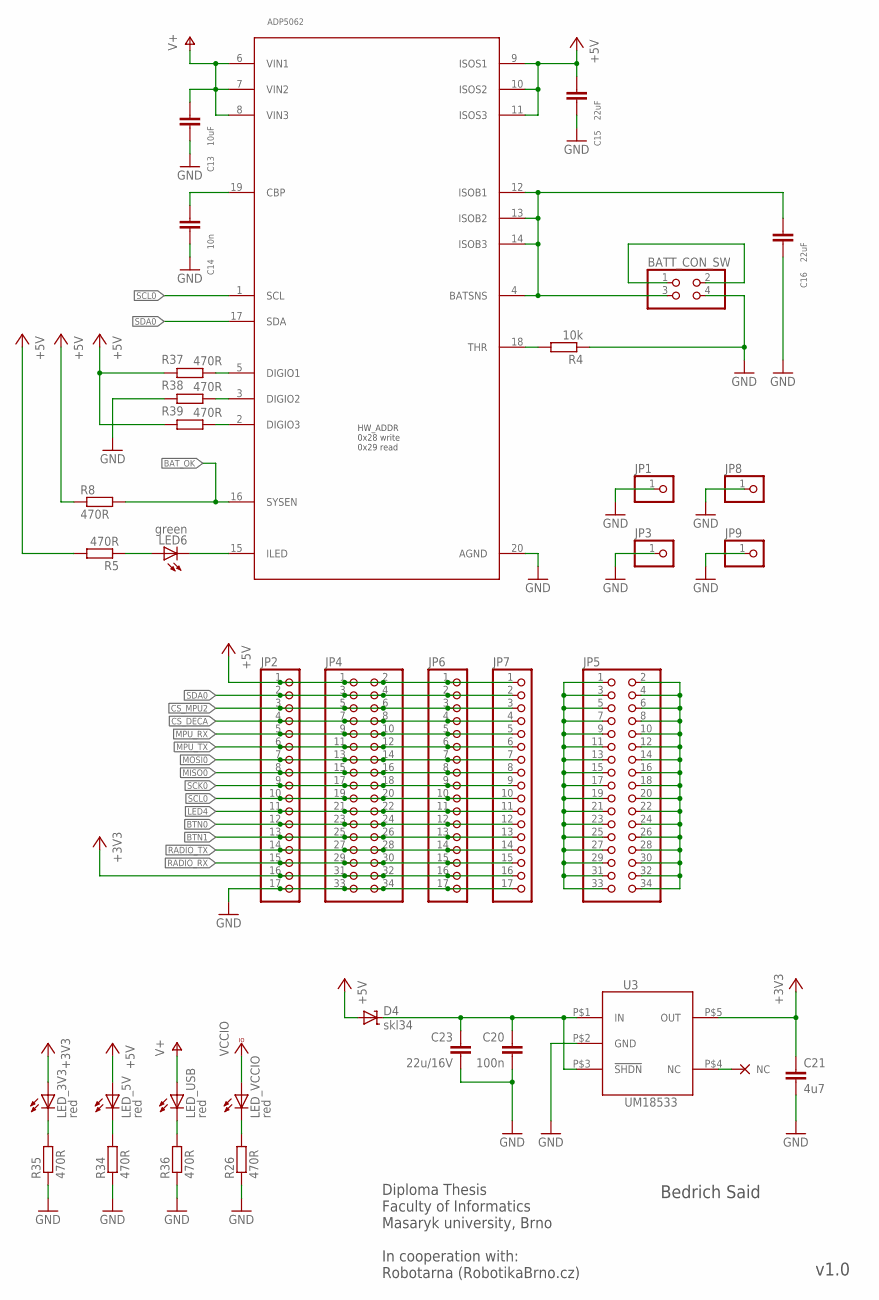
[picture p109: schematic SensorBoard.sch, sheet 1]

Parts:
BATT_CON_SW: PINHD-2X2; 2X02
C13: 10uF; C1206
C14: 10n; C0603
C15, C16: 22uF; C1206
C20: 100n; C0603
C21: 4u7; C0603
C23: 22u/16V; C1206
CHARGER: ADP5062; QFN50P400X400X80-21N
D4: skl34; SOD123
JP1, JP3, JP8, JP9: PINHD-1X1; 1X01
JP2, JP6, JP7: PINHD-1X17; 1X17
JP4, JP5: PINHD-2X17; 2X17
LED6: green; CHIPLED_0603
LED_3V3, LED_5V: red; CHIPLED_0603
LED_USB: red; CHIPLED_0603
LED_VCCIO: red; CHIPLED_0603
R4: 10k; R0603
R5, R8, R26, R34, R35, R36, R37, R38, R39: 470R; R0603
U3: UM18533; SOT23-5

Connections:
5V->3V3: C20.1, C23.1, D4.C, U3.P$1 (IN), U3.P$3 (!SHDN)
+3V3: C21.1, JP2.16, JP4.31, JP4.32, JP6.16, JP7.16, LED_3V3.A, U3.P$5 (OUT); also elsewhere on the board
+5V: C15.1, CHARGER.9 (ISOS1), CHARGER.10 (ISOS2), CHARGER.11 (ISOS3), D4.A, JP2.1, JP4.1, JP4.2, JP6.1, JP7.1, LED_5V.A, R5.2, R8.1, R37.2, R39.2; also elsewhere on the board
BAT_OK: CHARGER.16 (SYSEN), R8.2; also elsewhere on the board
BTN0: JP2.12, JP4.23, JP4.24, JP6.12, JP7.12; also elsewhere on the board
BTN1: JP2.13, JP4.25, JP4.26, JP6.13, JP7.13; also elsewhere on the board
CS_DECA: JP2.4, JP4.7, JP4.8, JP6.4, JP7.4; also elsewhere on the board
CS_MPU2: JP2.3, JP4.5, JP4.6, JP6.3, JP7.3; also elsewhere on the board
GND: BATT_CON_SW.4, C13.2, C14.2, C15.2, C16.2, C20.2, C21.2, C23.2, CHARGER.20 (AGND), JP1.1, JP2.17, JP3.1, JP4.33, JP4.34, JP6.17, JP7.17, JP8.1, JP9.1, R4.1, R26.1, R34.1, R35.1, R36.1, R38.2, U3.P$2 (GND); also elsewhere on the board
LED4: JP2.11, JP4.21, JP4.22, JP6.11, JP7.11; also elsewhere on the board
LED_3V3: LED_VCCIO.C, R26.2
LED_3V3_USB: LED_USB.C, R36.2
LED_3V3_USB1: LED_3V3.C, R35.2
LED_3V4: LED_5V.C, R34.2
MISO0: JP2.8, JP4.15, JP4.16, JP6.8, JP7.8; also elsewhere on the board
MOSI0: JP2.7, JP4.13, JP4.14, JP6.7, JP7.7; also elsewhere on the board
MPU_RX: JP2.5, JP4.9, JP4.10, JP6.5, JP7.5; also elsewhere on the board
MPU_TX: JP2.6, JP4.11, JP4.12, JP6.6, JP7.6; also elsewhere on the board
unnamed: JP5.1, JP5.3, JP5.5, JP5.7, JP5.9, JP5.11, JP5.13, JP5.15, JP5.17, JP5.19, JP5.21, JP5.23, JP5.25, JP5.27, JP5.29, JP5.31, JP5.33
unnamed: BATT_CON_SW.3, C16.1, CHARGER.4 (BATSNS), CHARGER.12 (ISOB1), CHARGER.13 (ISOB2), CHARGER.14 (ISOB3)
unnamed: BATT_CON_SW.1, BATT_CON_SW.2
unnamed: CHARGER.18 (THR), R4.2
unnamed: CHARGER.15 (ILED), LED6.C
unnamed: C14.1, CHARGER.19 (CBP)
unnamed: LED6.A, R5.1
unnamed: CHARGER.5 (DIGIO1), R37.1
unnamed: CHARGER.3 (DIGIO2), R38.1
unnamed: CHARGER.2 (DIGIO3), R39.1
unnamed: JP5.2, JP5.4, JP5.6, JP5.8, JP5.10, JP5.12, JP5.14, JP5.16, JP5.18, JP5.20, JP5.22, JP5.24, JP5.26, JP5.28, JP5.30, JP5.32, JP5.34
RADIO_RX: JP2.15, JP4.29, JP4.30, JP6.15, JP7.15; also elsewhere on the board
RADIO_TX: JP2.14, JP4.27, JP4.28, JP6.14, JP7.14; also elsewhere on the board
SCK0: JP2.9, JP4.17, JP4.18, JP6.9, JP7.9; also elsewhere on the board
SCL0: CHARGER.1 (SCL), JP2.10, JP4.19, JP4.20, JP6.10, JP7.10; also elsewhere on the board
SDA0: CHARGER.17 (SDA), JP2.2, JP4.3, JP4.4, JP6.2, JP7.2; also elsewhere on the board
U2_NC1: U3.P$4 (NC)
V+: C13.1, CHARGER.6 (VIN1), CHARGER.7 (VIN2), CHARGER.8 (VIN3), LED_USB.A; also elsewhere on the board
VCCIO: LED_VCCIO.A; also elsewhere on the board

Notes on the sheet:
Diploma Thesis Faculty of Informatics Masaryk university, Brno In cooperation with: Robotarna (RobotikaBrno.cz)
Bedrich Said
v1.0
HW_ADDR 0x28 write 0x29 read

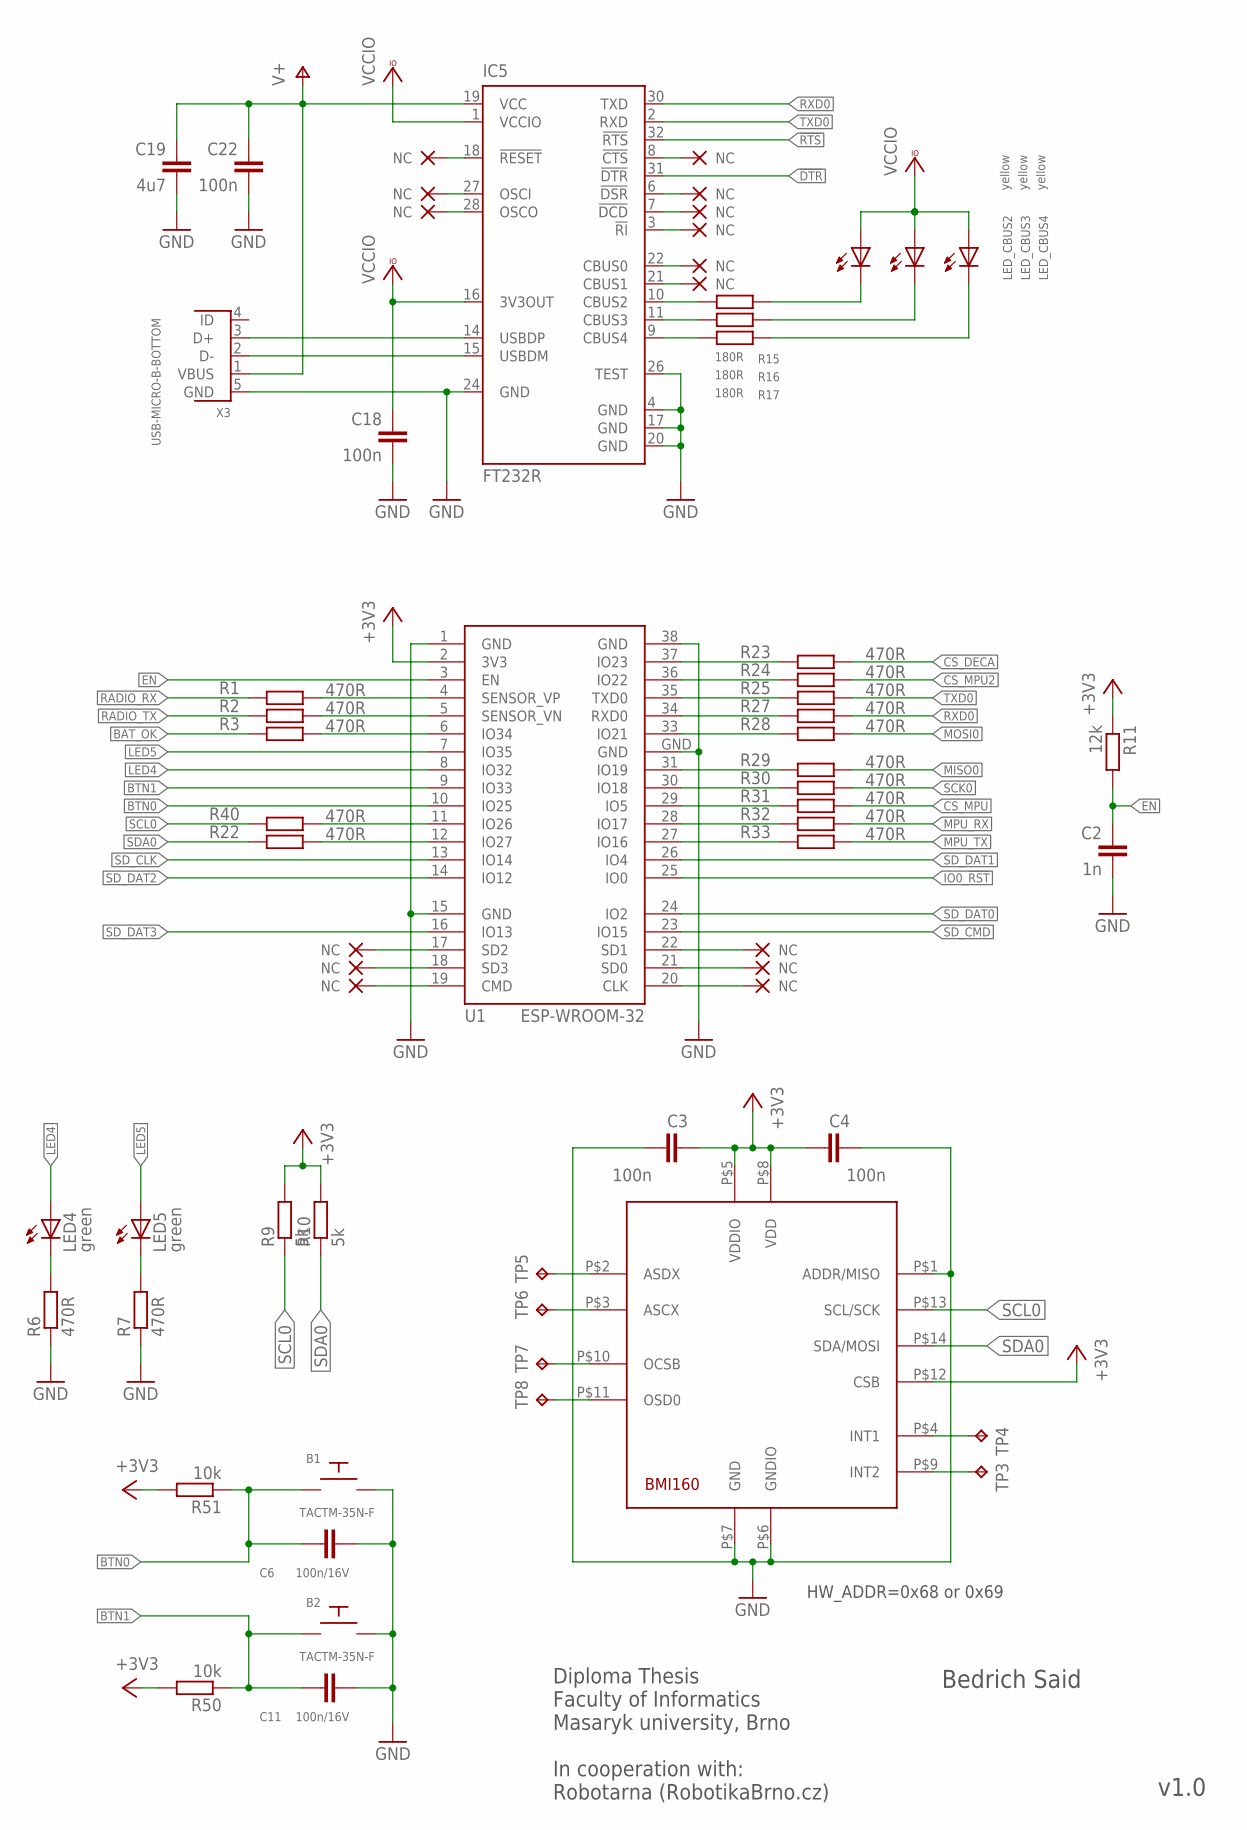
[picture p110: schematic SensorBoard.sch, sheet 2]

Parts:
B1, B2: TACTM-35N-F
C2: 1n; C0603
C3, C4, C18, C22: 100n; C0603
C6, C11: 100n/16V; C0603
C19: 4u7; C0603
IC5: FT232R; QFN32_LONG_PADS
LED4, LED5: green; CHIPLED_0603
LED_CBUS2, LED_CBUS3, LED_CBUS4: yellow; CHIP-LED0603
R1, R2, R3, R6, R7, R22, R23, R24, R25, R27, R28, R29, R30, R31, R32, R33, R40: 470R; R0603
R9, R10: 5k; R0603
R11: 12k; R0603
R15, R16, R17: 180R; R0603
R50, R51: 10k; R0603
TP3, TP4, TP5, TP6, TP7, TP8: TPTP08SQ; TP08SQ
U1: ESP-WROOM-32
U$3: BMI160LGA14; LGA14-BMI160
X3: USB-MICRO-B-BOTTOM; USB-MICRO-B-BOTTOM-MOLEX

Connections:
!DTR: IC5.31 (!DTR); also elsewhere on the board
!RTS: IC5.32 (!RTS); also elsewhere on the board
+3V3: C3.2, C4.1, R9.2, R10.2, R11.1, R50.2, R51.2, U1.2 (3V3), U$3.P$5 (VDDIO), U$3.P$8 (VDD), U$3.P$12 (CSB); also elsewhere on the board
BAT_OK: R3.2; also elsewhere on the board
BTN0: B1.P$4, C6.2, R51.1, U1.10 (IO25); also elsewhere on the board
BTN1: B2.P$4, C11.2, R50.1, U1.9 (IO33); also elsewhere on the board
CBUS2: IC5.10 (CBUS2), R15.2
CBUS2_LED: LED_CBUS2.C, R15.1
CBUS3: IC5.11 (CBUS3), R16.2
CBUS3_LED: LED_CBUS3.C, R16.1
CBUS4: IC5.9 (CBUS4), R17.2
CBUS4_LED: LED_CBUS4.C, R17.1
CS_DECA: R23.1; also elsewhere on the board
CS_MPU: R31.1; also elsewhere on the board
CS_MPU2: R24.1; also elsewhere on the board
EN: C2.1, R11.2, U1.3 (EN); also elsewhere on the board
GND: B1.P$2, B2.P$2, C2.2, C3.1, C4.2, C6.1, C11.1, C18.2, C19.2, C22.2, IC5.4 (GND), IC5.17 (GND), IC5.20 (GND), IC5.24 (GND), IC5.26 (TEST), R6.1, R7.1, U1.1 (GND), U1.15 (GND), U1.38 (GND), U1.GND, U$3.P$1 (ADDR/MISO), U$3.P$6 (GNDIO), U$3.P$7 (GND), X3.5 (GND); also elsewhere on the board
IO0_!RST: U1.25 (IO0); also elsewhere on the board
IO5: R31.2, U1.29 (IO5)
IO16: R33.2, U1.27 (IO16)
IO17: R32.2, U1.28 (IO17)
IO18: R30.2, U1.30 (IO18)
IO19: R29.2, U1.31 (IO19)
IO21: R28.2, U1.33 (IO21)
IO22: R24.2, U1.36 (IO22)
IO23: R23.2, U1.37 (IO23)
IO26: R40.1, U1.11 (IO26)
IO27: R22.1, U1.12 (IO27)
IO34: R3.1, U1.6 (IO34)
LED4: LED4.A, U1.8 (IO32); also elsewhere on the board
LED5: LED5.A, U1.7 (IO35)
LED_3V1: LED4.C, R6.2
LED_3V2: LED5.C, R7.2
MISO0: R29.1; also elsewhere on the board
MOSI0: R28.1; also elsewhere on the board
MPU_RX: R32.1; also elsewhere on the board
MPU_TX: R33.1; also elsewhere on the board
unnamed: TP5.TP, U$3.P$2 (ASDX)
unnamed: TP6.TP, U$3.P$3 (ASCX)
unnamed: TP7.TP, U$3.P$10 (OCSB)
unnamed: TP8.TP, U$3.P$11 (OSD0)
unnamed: TP4.TP, U$3.P$4 (INT1)
unnamed: TP3.TP, U$3.P$9 (INT2)
RADIO_RX: R1.2; also elsewhere on the board
RADIO_TX: R2.2; also elsewhere on the board
RXD0: IC5.30 (TXD), R27.1
RXD0_: R27.2, U1.34 (RXD0)
SCK0: R30.1; also elsewhere on the board
SCL0: R9.1, R40.2, U$3.P$13 (SCL/SCK); also elsewhere on the board
SDA0: R10.1, R22.2, U$3.P$14 (SDA/MOSI); also elsewhere on the board
SD_CLK: U1.13 (IO14); also elsewhere on the board
SD_CMD: U1.23 (IO15); also elsewhere on the board
SD_DAT0: U1.24 (IO2); also elsewhere on the board
SD_DAT1: U1.26 (IO4); also elsewhere on the board
SD_DAT2: U1.14 (IO12); also elsewhere on the board
SD_DAT3: U1.16 (IO13); also elsewhere on the board
SENSOR_VN_: R2.1, U1.5 (SENSOR_VN)
SENSOR_VP_: R1.1, U1.4 (SENSOR_VP)
TXD0: IC5.2 (RXD), R25.1
TXD0_: R25.2, U1.35 (TXD0)
USBDM: IC5.15 (USBDM), X3.2 (D-)
USBDP: IC5.14 (USBDP), X3.3 (D+)
V+: C19.1, C22.1, IC5.19 (VCC), X3.1 (VBUS); also elsewhere on the board
VCCIO: C18.1, IC5.1 (VCCIO), IC5.16 (3V3OUT), LED_CBUS2.A, LED_CBUS3.A, LED_CBUS4.A; also elsewhere on the board

Notes on the sheet:
Diploma Thesis Faculty of Informatics Masaryk university, Brno In cooperation with: Robotarna (RobotikaBrno.cz)
Bedrich Said
v1.0
HW_ADDR=0x68 or 0x69

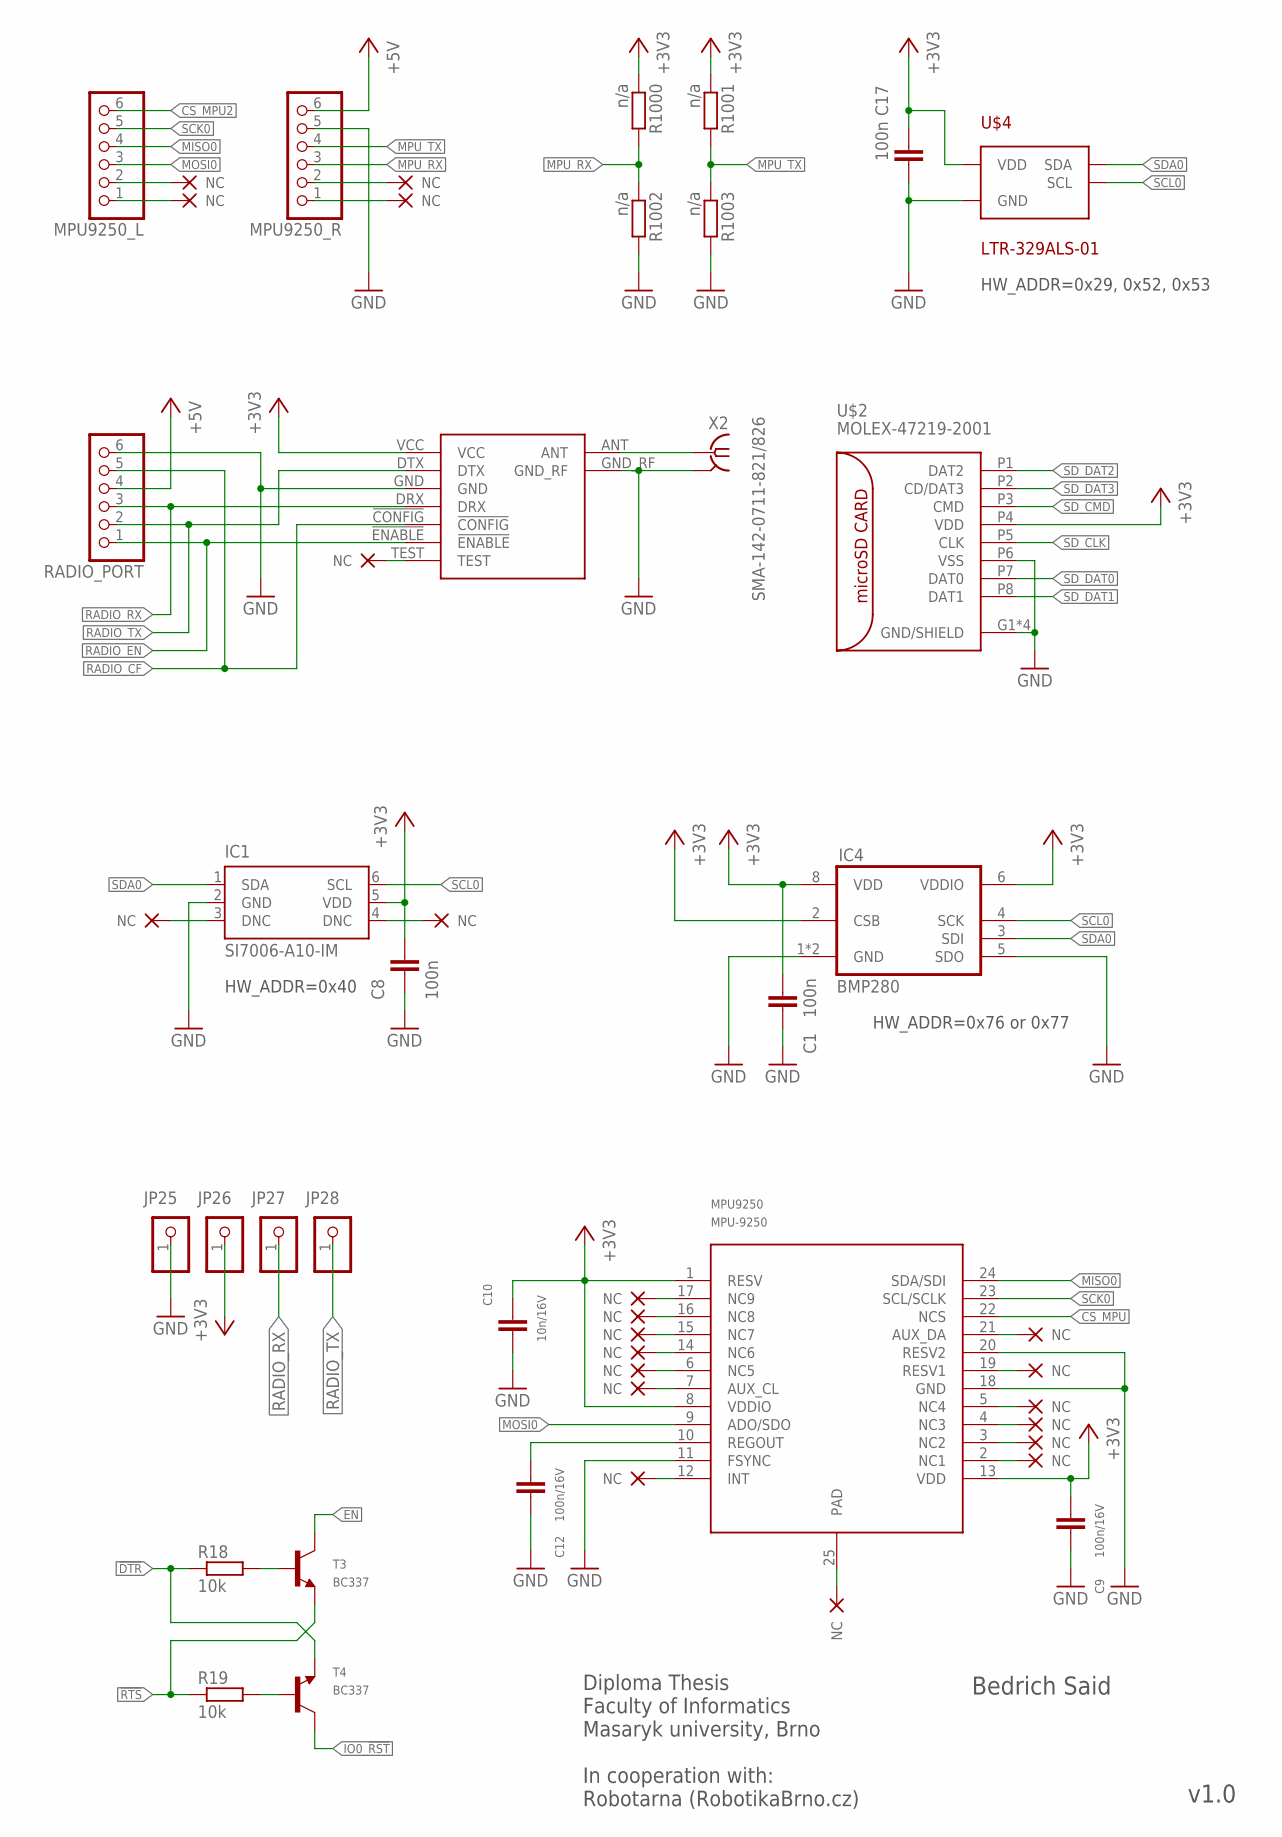
[picture p111: schematic SensorBoard.sch, sheet 3]

Parts:
C1, C8, C17: 100n; C0603
C9, C12: 100n/16V; C0603
C10: 10n/16V; C0603
IC1: SI7006-A10-IM; DFN6-3X3
IC4: BMP280
JP25, JP26, JP27, JP28: PINHD-1X1; 1X01
MPU9250: MPU-9250; LEAD-QFN24
MPU9250_L, MPU9250_R: PINHD-1X6; 1X06
R18, R19: 10k; R0603
R1000, R1001, R1002, R1003: n/a; R0603
RADIO_PORT: PINHD-1X6; 1X06
T3, T4: BC337; SOT23
U$1: HM-TRP
U$2: MOLEX-47219-2001; MOLEX:47219-2001
U$4: LTR-329ALS-01; CHIPLED-4
X2: SMA-142-0711-821/826; J502-ND-142-0711-821/826

Connections:
!DTR: R18.1, T4.2 (E); also elsewhere on the board
!DTR_B: R18.2, T3.1 (B)
!RTS: R19.1, T3.2 (E); also elsewhere on the board
!RTS_B: R19.2, T4.1 (B)
+3V3: C1.1, C8.1, C9.1, C10.1, C17.2, IC1.5 (VDD), IC4.2 (CSB), IC4.6 (VDDIO), IC4.8 (VDD), JP26.1, MPU9250.1 (RESV), MPU9250.8 (VDDIO), MPU9250.13 (VDD), R1000.1, R1001.1, U$1.VCC, U$2.P4 (VDD), U$4.1 (VDD); also elsewhere on the board
+5V: MPU9250_R.6, RADIO_PORT.4; also elsewhere on the board
CS_MPU: MPU9250.22 (NCS); also elsewhere on the board
CS_MPU2: MPU9250_L.6; also elsewhere on the board
EN: T3.3 (C); also elsewhere on the board
GND: C1.2, C8.2, C9.2, C10.2, C12.2, C17.1, IC1.2 (GND), IC4.1 (GND), IC4.5 (SDO), IC4.7 (GND), JP25.1, MPU9250.11 (FSYNC), MPU9250.18 (GND), MPU9250.20 (RESV2), MPU9250_R.5, R1002.2, R1003.2, RADIO_PORT.6, U$1.GND, U$1.GND_RF, U$2.G1 (GND/SHIELD), U$2.G2 (GND/SHIELD), U$2.G3 (GND/SHIELD), U$2.G4 (GND/SHIELD), U$2.P6 (VSS), U$4.2 (GND), X2.G@1 (2), X2.G@2 (2), X2.G@3 (2), X2.G@4 (2); also elsewhere on the board
IO0_!RST: T4.3 (C); also elsewhere on the board
MISO0: MPU9250.24 (SDA/SDI), MPU9250_L.4; also elsewhere on the board
MOSI0: MPU9250.9 (ADO/SDO), MPU9250_L.3; also elsewhere on the board
MPU_RX: MPU9250_R.3, R1000.2, R1002.1; also elsewhere on the board
MPU_TX: MPU9250_R.4, R1001.2, R1003.1; also elsewhere on the board
unnamed: C12.1, MPU9250.10 (REGOUT)
unnamed: U$1.ANT, X2.1
RADIO_CF: RADIO_PORT.5, U$1.!CONFIG
RADIO_EN: RADIO_PORT.1, U$1.!ENABLE
RADIO_RX: JP27.1, RADIO_PORT.3, U$1.DRX; also elsewhere on the board
RADIO_TX: JP28.1, RADIO_PORT.2, U$1.DTX; also elsewhere on the board
SCK0: MPU9250.23 (SCL/SCLK), MPU9250_L.5; also elsewhere on the board
SCL0: IC1.6 (SCL), IC4.4 (SCK), U$4.4 (SCL); also elsewhere on the board
SDA0: IC1.1 (SDA), IC4.3 (SDI), U$4.3 (SDA); also elsewhere on the board
SD_CLK: U$2.P5 (CLK); also elsewhere on the board
SD_CMD: U$2.P3 (CMD); also elsewhere on the board
SD_DAT0: U$2.P7 (DAT0); also elsewhere on the board
SD_DAT1: U$2.P8 (DAT1); also elsewhere on the board
SD_DAT2: U$2.P1 (DAT2); also elsewhere on the board
SD_DAT3: U$2.P2 (CD/DAT3); also elsewhere on the board

Notes on the sheet:
HW_ADDR=0x40
HW_ADDR=0x76 or 0x77
HW_ADDR=0x29, 0x52, 0x53
Diploma Thesis Faculty of Informatics Masaryk university, Brno In cooperation with: Robotarna (RobotikaBrno.cz)
Bedrich Said
v1.0

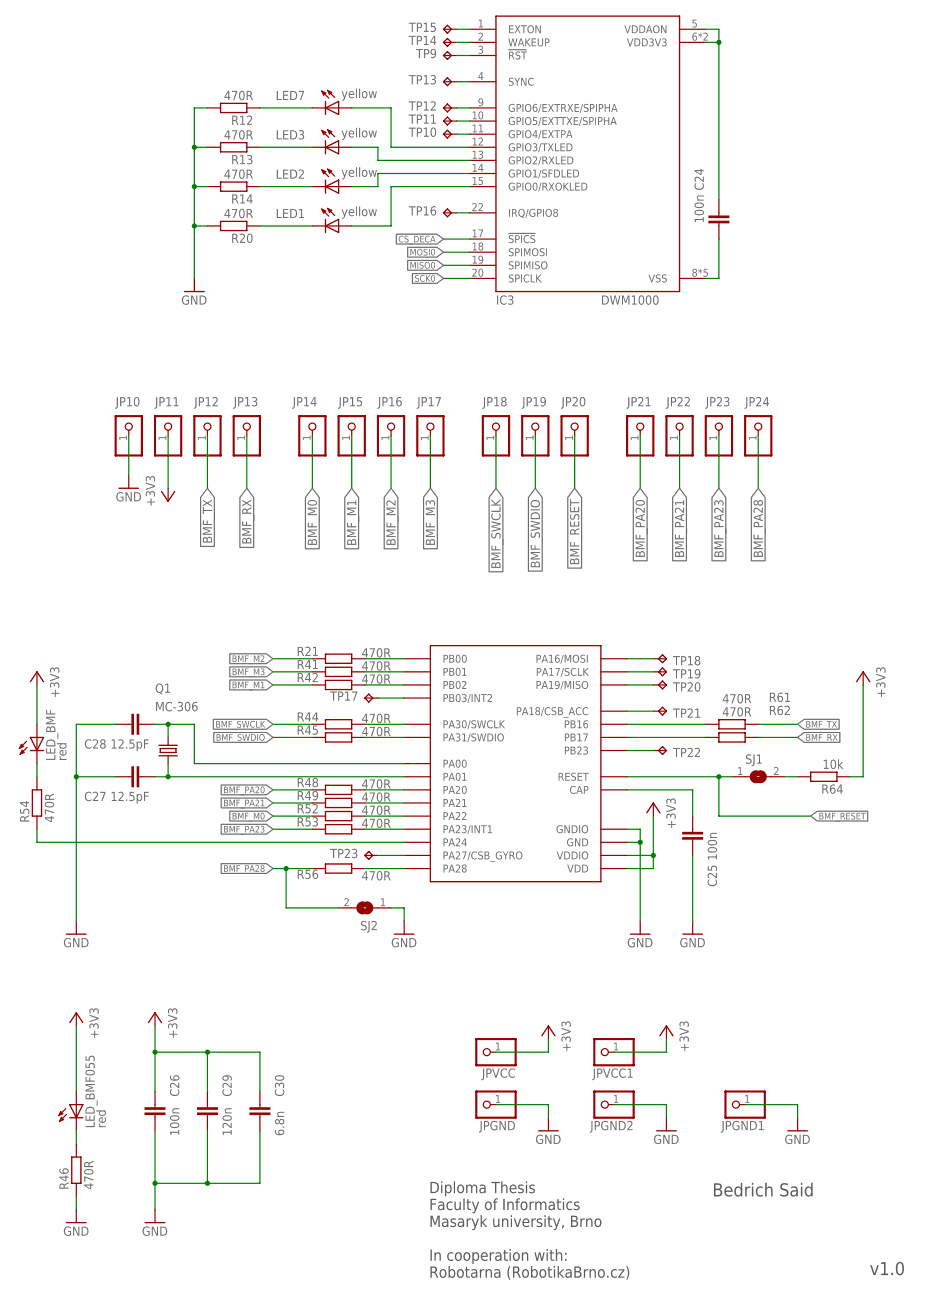
[picture p112: schematic SensorBoard.sch, sheet 4]

Parts:
C24, C25, C26: 100n; C0603
C27, C28: 12.5pF; C0603
C29: 120n; C0603
C30: 6.8n; C0603
IC3: DWM1000
JP10, JP11, JP12, JP13, JP14, JP15, JP16, JP17, JP18, JP19, JP20, JP21, JP22, JP23, JP24: PINHD-1X1; 1X01
JPGND, JPGND1, JPGND2: PINHD-1X1; 1X01
JPVCC, JPVCC1: PINHD-1X1; 1X01
LED1, LED2, LED3, LED7: yellow; CHIPLED_0603
LED_BMF, LED_BMF055: red; CHIPLED_0603
Q1: MC-306
R12, R13, R14, R20, R21, R41, R42, R44, R45, R46, R48, R49, R52, R53, R54, R56, R61, R62: 470R; R0603
R64: 10k; R0603
SJ1, SJ2: SJ
TP9, TP10, TP11, TP12, TP13, TP14, TP15, TP22, TP23: TPTP15SQ; TP15SQ
TP16: TPTP20SQ; TP20SQ
TP17, TP18, TP19, TP20, TP21: TPTP08SQ; TP08SQ
U$5: BMF055; LGA-28

Connections:
+3V3: C26.1, C29.1, C30.1, JP11.1, JPVCC.1, JPVCC1.1, LED_BMF.A, LED_BMF055.A, R64.1, U$5.P$3 (VDD), U$5.P$28 (VDDIO); also elsewhere on the board
BMF_M0: JP14.1, R52.2
BMF_M1: JP15.1, R42.2
BMF_M2: JP16.1, R21.2
BMF_M3: JP17.1, R41.2
BMF_PA20: JP21.1, R48.2
BMF_PA21: JP22.1, R49.2
BMF_PA23: JP23.1, R53.2
BMF_PA28: JP24.1, R56.2, SJ2.2
BMF_RESET: JP20.1, SJ1.1, U$5.P$11 (RESET)
BMF_RX: JP13.1, R62.1
BMF_SWCLK: JP18.1, R44.2
BMF_SWDIO: JP19.1, R45.2
BMF_TX: JP12.1, R61.1
CS_DECA: IC3.17 (!SPICS); also elsewhere on the board
GND: C25.2, C26.2, C27.2, C28.2, C29.2, C30.2, JP10.1, JPGND.1, JPGND1.1, JPGND2.1, R12.2, R13.2, R14.2, R20.2, R46.1, SJ2.1, U$5.P$2 (GND), U$5.P$25 (GNDIO); also elsewhere on the board
LED_3V3_USB2: LED_BMF055.C, R46.2
MISO0: IC3.19 (SPIMISO); also elsewhere on the board
MOSI0: IC3.18 (SPIMOSI); also elsewhere on the board
unnamed: R21.1, U$5.P$6 (PB00)
unnamed: LED1.C, R20.1
unnamed: LED2.C, R14.1
unnamed: LED3.C, R13.1
unnamed: IC3.22 (IRQ/GPIO8), TP16.TP
unnamed: R41.1, U$5.P$5 (PB01)
unnamed: C24.1, IC3.8 (VSS), IC3.16 (VSS), IC3.21 (VSS), IC3.23 (VSS), IC3.24 (VSS)
unnamed: C24.2, IC3.5 (VDDAON), IC3.6 (VDD3V3), IC3.7 (VDD3V3)
unnamed: R42.1, U$5.P$4 (PB02)
unnamed: LED7.C, R12.1
unnamed: IC3.12 (GPIO3/TXLED), LED7.A
unnamed: IC3.13 (GPIO2/RXLED), LED3.A
unnamed: IC3.14 (GPIO1/SFDLED), LED2.A
unnamed: IC3.15 (GPIO0/RXOKLED), LED1.A
unnamed: IC3.11 (GPIO4/EXTPA), TP10.TP
unnamed: IC3.3 (!RST), TP9.TP
unnamed: IC3.10 (GPIO5/EXTTXE/SPIPHA), TP11.TP
unnamed: IC3.9 (GPIO6/EXTRXE/SPIPHA), TP12.TP
unnamed: IC3.4 (SYNC), TP13.TP
unnamed: IC3.2 (WAKEUP), TP14.TP
unnamed: IC3.1 (EXTON), TP15.TP
unnamed: TP17.TP, U$5.P$1 (PB03/INT2)
unnamed: R44.1, U$5.P$8 (PA30/SWCLK)
unnamed: R45.1, U$5.P$7 (PA31/SWDIO)
unnamed: C28.1, Q1.4 (2), U$5.P$27 (PA00)
unnamed: C27.1, Q1.1, U$5.P$26 (PA01)
unnamed: R48.1, U$5.P$18 (PA20)
unnamed: R49.1, U$5.P$17 (PA21)
unnamed: R52.1, U$5.P$16 (PA22)
unnamed: R53.1, U$5.P$15 (PA23/INT1)
unnamed: R54.1, U$5.P$14 (PA24)
unnamed: TP23.TP, U$5.P$12 (PA27/CSB_GYRO)
unnamed: R56.1, U$5.P$10 (PA28)
unnamed: TP18.TP, U$5.P$24 (PA16/MOSI)
unnamed: TP19.TP, U$5.P$23 (PA17/SCLK)
unnamed: TP20.TP, U$5.P$21 (PA19/MISO)
unnamed: TP21.TP, U$5.P$22 (PA18/CSB_ACC)
unnamed: R61.2, U$5.P$20 (PB16)
unnamed: R62.2, U$5.P$19 (PB17)
unnamed: TP22.TP, U$5.P$13 (PB23)
unnamed: LED_BMF.C, R54.2
unnamed: C25.1, U$5.P$9 (CAP)
unnamed: R64.2, SJ1.2
SCK0: IC3.20 (SPICLK); also elsewhere on the board

Notes on the sheet:
Diploma Thesis Faculty of Informatics Masaryk university, Brno In cooperation with: Robotarna (RobotikaBrno.cz)
Bedrich Said
v1.0

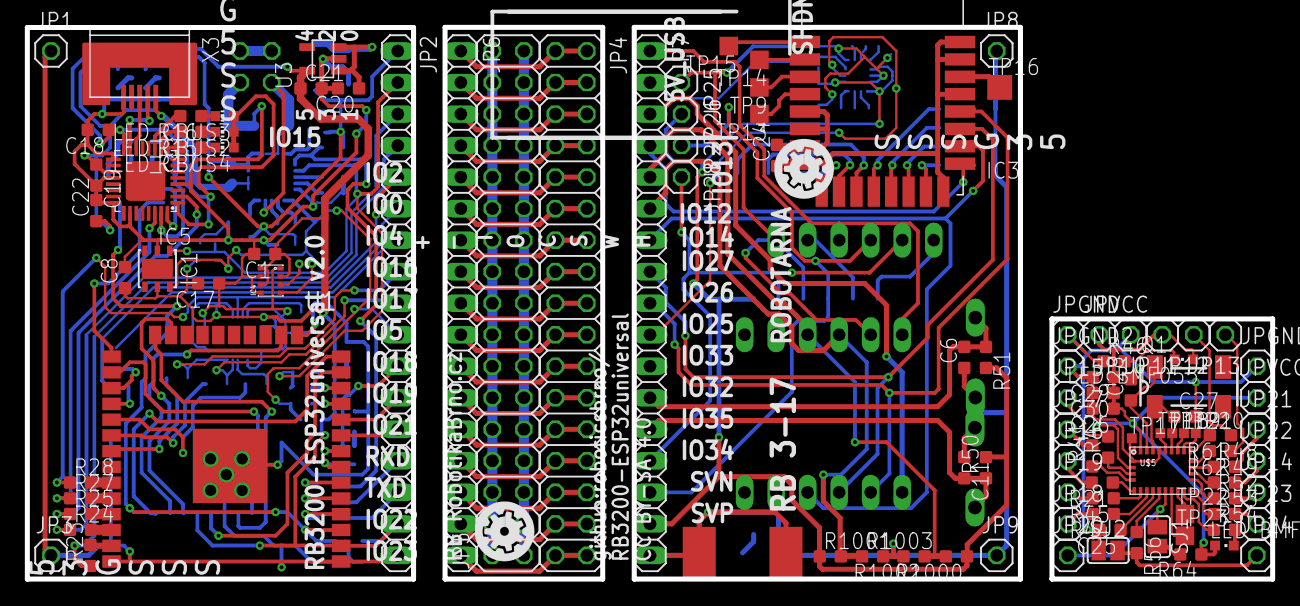
[picture p113: board SensorBoard.brd from above]

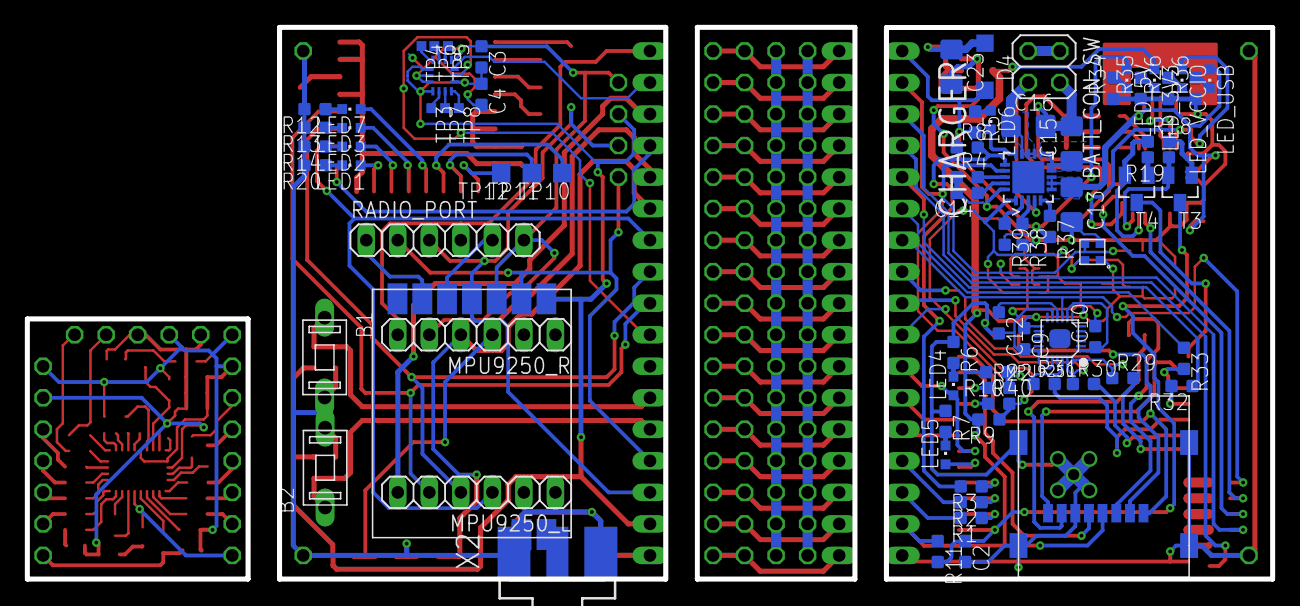
[picture p114: board SensorBoard.brd from below]

Board: 2 copper layers, 100.3 x 44.5 mm, 185 parts (78 on the bottom side), 144 nets.
