bsaid/SensorBoard/firmware/SensorBoard_orig/main/led.h

#ifndef GLOBAL_LED_H
#define GLOBAL_LED_H

#include "driver/gpio.h"

class Led
{
    gpio_num_t ledPin;

public:
    /**
     * LED constructor
     * @param ledPin number of GPIO pin
     */
    Led(gpio_num_t ledPin)
        : ledPin(ledPin)
    {
        gpio_config_t io_conf;
        io_conf.intr_type = (gpio_int_type_t)GPIO_PIN_INTR_DISABLE;
        io_conf.mode = GPIO_MODE_OUTPUT;
        io_conf.pin_bit_mask = (1ULL<<ledPin);
        io_conf.pull_down_en = (gpio_pulldown_t)0;
        io_conf.pull_up_en = (gpio_pullup_t)0;
        gpio_config(&io_conf);
    }

    /**
     * Light on.
     */
    void set()
    {
        gpio_set_level(ledPin, 1);
    }

    /**
     * Light off.
     */
    void reset()
    {
        gpio_set_level(ledPin, 0);
    }

    /**
     * Blink count times and keep the light for delay_ms milliseconds.
     * @param count    blink how many times
     * @param delay_ms how long keep the light on/off
     */
    void blink(int count = 5, int delay_ms = 500)
    {
        for(int i=0; i<count; i++)
        {
            set();
            vTaskDelay(delay_ms/portTICK_PERIOD_MS);
            reset();
            vTaskDelay(delay_ms/portTICK_PERIOD_MS);
        }
    }
};

#endif // GLOBAL_LED_H
