bsaid/SensorBoard/firmware/SensorBoard_orig/main/RuntimeSettings.h

#ifndef MAIN_RUNTIME_SETTINGS_H_
#define MAIN_RUNTIME_SETTINGS_H_

//TODO: merge with GlobalSettings
class RuntimeSettings
{
public:
    bool isLogging = true;
    bool isStreaming = false;
    bool isHorseAnalysis = false;
};

#endif // MAIN_RUNTIME_SETTINGS_H_
