bsaid/SensorBoard/(commit log)

2017-11-03 Added SensorBoard firmware.
2017-11-03 Added hardware design in Eagle.
    [SensorBoard.brd, SensorBoard.sch, final.brd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]
2018-02-12 Cleaned hardware data.
    [SensorBoard.brd, SensorBoard.sch, SensorBoardManufacturingPanel.brd]
2018-02-12 First update of the thesis text.
    [RequirementsHW.xlsx]
2018-02-13 Added schematics and board layout to the thesis text.
2018-02-16 Added other text to Hardware, written the first version of Abstract, added Bibliography and Index.
    [RequirementsHW.xlsx]
2018-03-21 Added power supply info to Appendix.
2018-03-22 Horse Analysis integrated with MPU9250 accelerometer.
2018-03-23 Added conversion of BMP280 raw data to pressure and temperature.
2018-03-23 Added LED control class.
2018-03-23 Added MPU9250 class controlled via I2C.
2018-03-23 Added accelerometer output to log and stream with horse analysis.
2018-04-09 MPU9250 magnetometer bugs fixed.
    [ComputingTask.h]
2018-04-17 Rapidly prototyped WiFi access point with DHCP server, TCP server and basic communication protocol.
2018-04-28 Restructured files.
    [bot.gbr, dim.gbr, mill.gbr, plt.gbr, smb.gbr, smt.gbr, top.gbr]
2018-05-01 Grammar correction.
    [RequirementsHW.xlsx]
2018-05-08 Thesis update. Only horse analysis chapter remaining.
    [SchESP32.sch]
2018-05-21 Hardware schematics splitted into four sheets.
    [SensorBoard.brd, SensorBoard.sch]
