bsaid/SensorBoard/(notices)

Notices in the files:
hardware/SensorBoardManufacturingPanel.brd:
CC BY-SA 4.0
parts and their libraries:
esp32: Creative Commons Attribution-ShareAlike 4.0 International
si70xx: (c) 2014 Samuel Lourenço
User-Submitted: Licensing: Creative Commons ShareAlike 4.0 International - https://creativecommons.org/licenses/by-sa/4.0
